brut/3dp_taz/Juniper/TAZ-BOM-Juniper.xlsx

Sheet: KT-PR0017
№ | Category | AO Part # | Description | Manufacturer | Manufacturer PN | Distributor | Distributor SKU | КОЛ-ВО | UOM | Price Per Unit | Price Total | Qty to Order | PO | Date | ETA
1 | Hardware | HD-MS0054 | Square Bumper |  |  | Advanced Antivibration components | V10R87-B08130 | 8 | ea | $0.087 | $0.70 | 12000 | PO04955 | 2014-10-16 | 2014-11-03
2 | Firmware |  | Firmware, Marlin 2014Q4 |  |  | Aleph Objects |  | 1 | ea |  |  | 1520
3 | Printed | PP-GP0083 | bed_finger |  |  |  |  | 4 | ea | $0.100 | $0.40 | 6080
4 | Printed | PP-GP0084 | double_bearing_holder |  |  |  |  | 3 | ea | $2.890 | $8.67 | 4560
5 | Printed | PP-GP0117 | Bearing Holder v1.1b, TAZ |  |  |  |  | 5 | ea | $1.170 | $5.85 | 7600
6 | Printed | PP-GP0086 | Belt clamp, TAZ |  |  |  |  | 2 | ea | $0.080 | $0.16 | 3040
7 | Printed | PP-GP0089 | LCD_spacer |  |  |  |  | 4 | ea | $0.005 | $0.02 | 6080
8 | Printed | PP-GP0120 | feed_tube_holder_v2.0 |  |  |  |  | 1 | ea | $0.660 | $0.66 | 1520
9 | Printed | PP-GP0074 | feed_tube spinner |  |  |  |  | 1 | ea | $0.530 | $0.53 | 1520
10 | Printed | PP-GP0061 | herringbone_large_gear |  |  |  |  | 1 | ea | $2.430 | $2.43 | 1520
11 | Printed | PP-GP0062 | herringbone_small_gear |  |  |  |  | 1 | ea | $0.340 | $0.34 | 1520
12 | Printed | PP-GP0060 | Wade Reloaded Bearing Washer |  |  |  |  | 1 | ea | $0.020 | $0.02 | 1520
13 | Printed | PP-GP0186 | Wade extruder body for Hex nozzle v1.0 |  |  |  |  | 1 | ea | $4.010 | $4.01 | 1520
14 | Printed | PP-GP0059 | Wade Reloaded Idler Block v1.4, Taz & Mini |  |  |  |  | 1 | ea | $0.900 | $0.90 | 1520
15 | Printed | PP-GP0091 | extruder_latch |  |  |  |  | 1 | ea | $0.260 | $0.26 | 1520
16 | Printed | PP-GP0151 | X Idler v2.3 , TAZ |  |  |  |  | 1 | ea | $2.770 | $2.77 | 1520
17 | Printed | PP-GP0128 | X Carriage v2.0 ,TAZ |  |  |  |  | 1 | ea | $6.000 | $6.00 | 1520
18 | Printed | PP-GP0094 | x_carriage_guide |  |  |  |  | 1 | ea | $0.760 | $0.76 | 1520
19 | Printed | PP-GP0152 | X Motor Mount v2.1, TAZ |  |  |  |  | 1 | ea | $2.820 | $2.82 | 1520
20 | Printed | PP-GP0194 | Extruder Mount for Hex v1.0, TAZ |  |  |  |  | 1 | ea | $6.510 | $6.51 | 1520
21 | Printed | PP-GP0150 | y_belt_mount |  |  |  |  | 1 | ea | $2.460 | $2.46 | 1520
22 | Printed | PP-GP0121 | Y Mount Chassis v2.1, TAZ |  |  |  |  | 4 | ea | $0.730 | $2.92 | 6080
23 | Printed | PP-GP0122 | y_mount_table-2.1 |  |  |  |  | 4 | ea | $0.730 | $2.92 | 6080
24 | Printed | PP-GP0123 | Z Top Drive v1.2-Left, TAZ |  |  |  |  | 1 | ea | $3.560 | $3.56 | 1520
25 | Printed | PP-GP0124 | Z Top Drive v1.2-Right, TAZ |  |  |  |  | 1 | ea | $3.560 | $3.56 | 1520
26 | Printed | PP-GP0125 | Z Motor Mount v2.1 nonswitch-Right |  |  |  |  | 1 | ea | $5.840 | $5.84 | 1520
27 | Printed | PP-GP0126 | Z Motor Mount v2.1 switch-Left , TAZ |  |  |  |  | 1 | ea | $6.070 | $6.07 | 1520
28 | Printed | PP-GP0109 | Spool Arm, TAZ |  |  |  |  | 1 | ea | $2.010 | $2.01 | 1520
29 | Printed | PP-GP0118 | Bed Corner v2.5 |  |  |  |  | 4 | ea | $0.250 | $1.00 | 6080
30 | Printed | PP-GP0107 | shipping_clamp_a |  |  |  |  | 4 | ea | $0.250 | $1.00 | 6080
31 | Printed | PP-GP0108 | shipping_clamp_b |  |  |  |  | 4 | ea | $0.210 | $0.84 | 6080
32 | Printed | PP-GP0113 | Y Corner Left v1.2, TAZ |  |  |  |  | 2 | ea | $2.010 | $4.02 | 3040
33 | Printed | PP-GP0114 | Y Corner Right v1.2, TAZ |  |  |  |  | 2 | ea | $2.010 | $4.02 | 3040
34 | Printed | PP-GP0115 | Y Bearing Mount v2.6.b, TAZ |  |  |  |  | 1 | ea | $0.970 | $0.97 | 1520
35 | Printed | PP-GP0116 | Y Motor Mount v2.4, TAZ |  |  |  |  | 1 | ea | $5.170 | $5.17 | 1520
36 | Printed | PP-GP0127 | Z Nut Mount V 2.0 , TAZ |  |  |  |  | 2 | ea | $2.050 | $4.10 | 3040
37 | Printed | PP-GP0154 | Electronics Case Mount v1.0 |  |  |  |  | 4 | ea | $0.240 | $0.96 | 6080
38 | Printed | PP-GP0153 | Extruder Fan Mount v1.0, TAZ |  |  |  |  | 1 | ea | $1.120 | $1.12 | 1520
39 | Printed | PP-GP0163 | Long Shim |  |  |  |  | 2 | ea | $1.000 | $2.00 | 3040
40 | Accessories | RM-AB0079 | ABS 3mm, 1m filament sample, LulzBot green |  |  | Aleph Objects |  | 1 | ea | $0.200 | $0.20 | 1520
41 | Electronic | EL-MS0126 | CONN PLUG, 25 POS, IDC GOLD | 3M | 8225-8000 | Heilind / AA ADAM ELECTRONIC TECHNOLOGY CO., LTD (AMICU ELECTRONICS) | 3M15408-ND | 1 | ea | $3.400 | $3.40 | 1520 | PO05324 / PO06544 | 2015-03-03 | 2015-03-06 | Units that came out of AA Adam will not serve our needs. This need to be 3M parts. Pulled from Heilind
42 | Electronic | EL-MS0127 | CONN D-SUB RCPT 25 POS IDC GOLD | 3M | 8325-8003 | Heilind / AA ADAM ELECTRONIC TECHNOLOGY CO., LTD (AMICU ELECTRONICS) | 3M15414-ND | 1 | ea | $3.990 | $3.99 | 1520 | PO05324 / PO06544 | 3/3/15/ | 2015-03-06 | Units that came out of AA Adam will not serve our needs. This need to be 3M parts. Pulled from Heilind
43 | Mechanical | HD-MS0002-3 | Borosilicate Glass Bed 300mm x 300mm |  |  | Allen Scientific |  | 1 | ea | $12.850 | $12.85 | 1520 | PO05325 | 2014-11-19 | 2014-12-29
44 | Hardware | HD-MS0027 | Spring, Extruder, 6mm OD, 0.8mm WD, 9.7mm FL |  |  | Associated Spring | C0240-032-0380-M | 6 | ea | $0.137 | $0.82 | 9120 | PO04996 | 2014-10-21 | 2014-11-03
45 | Mechanical | HD-BL0009 | GT2, Single sided Neoprene Belt, 2mm pitch, 582 teeth, 6mm wide,fiberglass cords |  |  | B & B Manufacturing, Inc | 1164-2P-06 (2MR-1164-06) | 2 | ea | $2.540 | $5.08 | 3040 | PO05281 | 2014-11-20 | 2015-01-09
46 | Mechanical | HD-MS0033 | GT2 Timing Pulley, 5mm Bore Aluminum |  |  | B & B Manufacturing, Inc | 16-2P06M6CA5 5MM BORE ALUMINUM | 2 | ea | $2.900 | $5.80 | 3040 | PO05281 | 2014-11-20 | 2015-01-16
47 | Tools | TL-HD0048 | Elmer's X-Acto No. 1 Precision Knife – Aluminum |  | X3201 | Utrecht Art Supplies | 57497-1001 | 1 | ea | $1.940 | $1.94 | 1520 | PO05559 | 2014-12-12 | 2015-01-06 | 198 units shipping 12/31/2014 – Balance to ship1/8/2015. TS
48 | Tools | TL-HD0050 | 6" Professional Long Nose Pliers |  |  | Newark | 43W8049 | 1 | ea | $5.180 | $5.18 | 1520 | PO05016 | 2014-10-24 | 2014-10-24 | Vendor double shipped the Ironwood order
49 | Mechanical | PP-FP0012 | frame_connector |  |  | Custom Laser Design |  | 7 | ea | $2.450 | $17.15 | 10640 | PO05561 | 2014-12-12 | 2015-01-06 | First units will start to arrive the week of 12/29/2014 and a minimum of 250 units will be delivered weekly until complete. TSimpson
50 | Mechanical | PP-FP0011 | TAZ name plate, laser cut |  |  | Custom Laser Design |  | 1 | ea | $3.700 | $3.70 | 1520 | PO05561 | 2014-12-12 | 2015-01-06 | First units will start to arrive the week of 12/29/2014 and a minimum of 250 units will be delivered weekly until complete. TSimpson
51 | Hardware | HD-MS0061 | KNOB CLR/MATTE .50"DIA 6MM SHAFT |  | OEJA-50-3-7 | Digikey | 226-3128-ND | 1 | ea | $3.170 | $3.17 | 1520 | PO05779 | 2014-12-30 | See Notes | 1339 units shipping 12/30/2014 remaining 181 shipping 2/2/2015
52 | Electronic | EL-MS0141 | Term Ring Non Ins 26-22AWG #4 (THIS COMES IN BULK) | Panduit | P22-4R-M | TTI | 298-10067-ND | 3 | ea | $0.059 | $0.10 | 4560 | PO05784 | 2014-12-31 | 2015-01-09 | Per Chris, this is a bulk product.
53 | Electronic | PC-CN0010 | IDC 10POS Dual 30AU | FCI | BRG71600-010LF | Digikey / TTI | 609-1739-ND | 2 | ea | $0.501 | $1.00 | 3040 | PO05790 | 2014-12-31 | 2015-01-09
54 | Electronic | EL-MS0134 | Backshell DB25 Flat Ribbon | Norcomp, Inc. | 976-025-010R031 | Digikey/Mouser | 976-25RPE-ND | 1 | ea | $0.998 | $1.00 | 1520 | PO05113 | 2014-11-05 | See Notes | 10 Week Lead Time – 11/05Shipping 31 immediately BO Schedule 550 by 12/21, 200 by 1/30, 739 by 2/4. (Becasue these are difficult to get, I had Heilind pull in addition units to reduce lead times. -
55 | Electronic | EL-MS0133 | 14-POS, panel mount w. brass inserts | TE | 211103-1 | TTI | A106308-ND | 4 | ea | $3.771 | $15.08 | 6080 | PO05694 | 2014-12-29 | 2015-01-09 | 2301 units shipping 12/31/2014 the balance will ship ~ 1/23/2015.
56 | Electronic | EL-MS0128 | 4-POS, free hanging | TE | 206429-1 | TTI | A1357-ND | 1 | ea | $2.552 | $2.55 | 1520 | PO05694 | 2014-12-29 | 2015-01-09
57 | Electronic | EL-MS0131 | 14-POS, free hanging | TE | 206044-1 | Digikey | A1358-ND | 3 | ea | $2.403 | $7.21 | 4560 | PO05239 | 2014-11-14 | 2014-11-20
58 | Electronic | PC-CN0035 | 4-POS, panel mount w. brass inserts | TE | 211102-01 | TTI | A25053-ND | 1 | ea | $3.360 | $3.36 | 1520 | PO05784 | 2014-12-31 | 2015-01-09
59 | Electronic | EL-MS0142 | CONN RECEPT FASTON 22-26AWG .110 |  | 7-520365-2 | TTI | 7-520365-2 | 6 | ea | $0.109 | $0.65 | 9120 | PO05694 | 2014-12-29 | 2015-01-09
60 | Electronic | EL-MS0143 | Conn Fast Receptacle14-16 AWG .250 |  | 3-350820-2 | TTI | 3-350820-2 | 2 | ea | $0.077 | $0.15 | 3040 | PO05694 | 2014-12-29 | 2015-01-09
61 | Electronic | EL-MS0123 | 20-24 AWG Tin Pin for Plug | TE | 1-66106-5 | Digikey | A31991TR-ND | 37 | ea | $0.200 | $7.40 | 56240 | PO04398 | 2014-09-19 | 2014-09-24 | 60000 (Notes from Ironwood) | Do not need more for Juniper | 17+ WK LT (12/19/2014 placed order for 60K units for Kauri) | There was a 12 week lead on PN-A31991TR-ND / Ordered 4k of alternate PN-A032008-TR-ND Under PO 04547. B/O of PO03450 from June for 20,000 ETA 10/13.
62 | Electronic | EL-MS0124 | 20-24 AWG Tin Sockets for Receptacle | TE | 1-66331-4 | Digikey / Heilind | A31995TR-ND | 48 | ea | $0.230 | $11.04 | 72960 | PO05113 | 2014-11-05 | See Notes | 18 Week Lead Time / 12k Shipping 11/05 -BO Schedule 36k by 1/7, 12k by 2/11, 12k by 3/11. | Qty was 46, qty of line above was 35 | 17+ WK LT (12/19/2014 placed order for 73K units for Kauri)
63 | Electronic | EL-MS0121 | 14-18 AWG Tin Sockets for Receptacle | TE | 1-66358-6 | TTI | A31997TR-ND | 3 | ea | $0.210 | $0.63 | 4560 | PO05784 | 2014-12-31 | 2015-01-09
64 | Electronic | EL-MS0122 | 14-18 AWG Tin Pin for Plug | TE | 1-66359-4 | Digikey | A31998TR-ND | 3 | ea | $0.174 | $0.52 | 4560 | PO05239 | 2014-11-14 | 2014-11-20 | Needed to order a small amount for RMA's and it only comes on reels of 4k to I ordered Juniper as well.
65 | Electronic | EL-MS0129 | Cable Clamp for 14-Pos; 0.453” opening | TE | 206070-8 | TTI | A32516-ND | 2 | ea | $2.160 | $4.32 | 3040 | PO05784 | 2014-12-31 | 2015-01-09
66 | Electronic | EL-MS0130 | Cable Clamp for 14-Pos; 0.453” opening; full cover | TE | AMP1546349-2 | Heilind | A33754-ND | 1 | ea | $3.390 | $3.39 | 1520 | PO05784 / PO06453 | 2014-12-31 | 2015-01-09 | Ordered Fill in from Digi Key (PO06455) and Heilind
67 | Electronic | EL-WR0104 | 24AWG Stranded – Orange |  | HU1569247OE | Allcable | HU1569247OE | 2520 | mm | $7.545931759e-05 | $0.19 | 12566.92913 | PO05812 | 2014-12-12 | 2015-01-09
68 | Electronic | EL-WR0105 | 24AWG Stranded – Black |  | HU1569247BK | Allcable | HU1569247BK | 4860 | mm | $0.0001 | $0.37 | 24236.22047 | PO05812 | 2014-12-12 | 2015-01-09 | qty was 3560 (PO05812 covers Juniper, fill in for Daffodil and Euphorbia)
69 | Electronic | EL-WR0111 | 24AWG Stranded – Blue |  | HU1569247BE | Allcable | HU1569247BE | 690 | mm | $0.0001 | $0.05 | 3440.944882 | PO05812 | 2014-12-12 | 2015-01-09
70 | Electronic | EL-WR0103 | 24AWG Stranded – Red |  | HU1569247RD | Allcable | HU1569247RD | 6100 | mm | $0.0001 | $0.46 | 30419.94751 | PO05812 | 2014-12-12 | 2015-01-09 | qty was 4800 (PO05812 covers Juniper, fill in for Daffodil and Euphorbia)
71 | Electronic | EL-WR0107 | 24AWG Stranded – White |  | HU1569247WE | Allcable | HU1569247WE | 1160 | mm | $0.0001 | $0.09 | 5784.776903 | PO05812 | 2014-12-12 | 2015-01-09
72 | Electronic | EL-WR0109 | 24AWG Stranded – Yellow |  | HU1569247YW | Allcable | HU1569247YW | 1100 | mm | $0.0001 | $0.08 | 5485.564304 | PO05812 | 2014-12-12 | 2015-01-09
73 | Electronic | EL-WR0106 | 16AWG Stranded – Red |  | HU15691626RD | Allcable | HU15691626RD | 650 | mm | $0.0003 | $0.19 | 3241.469816 | PO05812 | 2014-12-12 | 2015-01-09
74 | Electronic | EL-WR0108 | 16AWG Stranded – Violet |  | HU15691626VT | Allcable | HU15691626VT | 1200 | mm | $0.0003 | $0.35 | 5984.251969 | PO05812 | 2014-12-12 | 2015-01-09
75 | Electronic | EL-WR0110 | 16AWG Stranded – Yellow |  | HU15691626YW | Allcable | HU15691626YW | 50 | mm | $0.0003 | $0.01 | 249.343832 | PO05812 | 2014-12-12 | 2015-01-09
76 | Electronic | EL-SW0020 | SWITCH ROCKER DPST 20A 125V | E-switch | R5ABLKBLKFF0 | Digikey | EG1529-ND | 1 | ea | $1.046 | $1.05 | 1520 | PO05779 | 2014-12-30 | 2015-01-06
77 | Electronic | EL-WR0098 | 25Cond Ribbon LT GRY |  | HF365/25SF | Digikey | MD25R-100-ND | 160 | mm | $0.316 | $50.56 | 243200 | PO05776 | 2014-12-30 | 2015-01-06 | 800 ft
78 | Electronic | EL-SW0021 | Switch SIM Roll SPDT 3A 125V | Omron | SG-3GL13PT | Digikey | SW768-ND | 3 | ea | $0.609 | $1.83 | 4560 | See notes |  |  | 5500 from PO04969 on hand
79 | Electronic | EL-WR0099 | Shielded 4Cond 22AWG |  | 0762A.41.10 | Allcable | C0762A.41.10 | 3657 | mm | $0.001 | $3.70 | 18237.00787 | PO05812 | 2014-12-12 | 2015-01-09
80 | Electronic | EL-MS0059 | CONN TERM FEMALE 22-24AWG TIN | Molex Inc. | 16-02-0086 | TTI | WM2510TR-ND | 96 | ea | $0.019 | $1.82 | 145920 (8 Reels) | PO05694 | 2014-12-29 | 2015-01-09 | Reel = 20,000 units
81 | Electronic | EL-MS0205 | CONN TERM MALE 22-24AWG TIN | Molex | 16-02-0107 | TTI | WM2517TR-ND | 36 | ea | $0.042 | $1.51 | 54720 (3 Reels of 20K) | PO05694 | 2014-12-29 | 2015-01-09 | Qty was 32, qty of line above was 92 Reel = 20,000 units
82 | Electronic | EL-MS0212 | CONN PIN 24-30AWG CRIMP TIN | Molex | 16-02-0108 | TTI | MOL16-02-0108 | 2 | ea | $0.081 | $0.16 | 3040 | PO05784 | 2014-12-31 | 2015-01-09 | This comes in BULK
83 | Electronic | EL-MS0075 | 8-POS .100 Dual (Black) |  | 22552081 | TTI | WM2521-ND | 1 | ea | $0.081 | $0.08 | 1520 | PO05694 | 2014-12-29 | 2015-01-09
84 | Electronic | EL-MS0074 | 20-POS .100 Dual (Black) |  | 22552201 | Digikey | WM2527-ND | 1 | ea | $0.988 | $1.059 | 1520 | PO05779 | 2014-12-30 | 2015-01-06 | Backorder will ship 215 units on 1//21/15.
85 | Electronic | PP-MP0059 | CONN HOUSING MALE 2POS .100 |  | 0701070001 | TTI | WM2533-ND | 5 | ea | $0.124 | $0.62 | 7600 | PO05694 | 2014-12-29 | 2015-01-09 | qty was 4 PO05694 Ordered 8,000 units)
86 | Electronic | EL-MS0061 | Connector, 4 pin Male housing with latch | Molex | 0701070003 | TTI | WM2535-ND | 6 | ea | $0.136 | $0.82 | 9120 | PO05694 | 2014-12-29 | 2015-01-09 | qty was 5
87 | Electronic | PC-CN0001 | CONN HOUSING 2POS .100 W/LATCH |  | 050579402 | TTI | WM2900-ND | 12 | ea | $0.062 | $0.74 | 18240 | PO05694 | 2014-12-29 | 2015-01-09 | qty was 10
88 | Electronic | PC-CN0003 | Connector Housing 3POS .100 W/Latch |  | 0050579403 | TTI | WM2901-ND | 3 | ea | $0.060 | $0.18 | 4560 | PO05694 | 2014-12-29 | 2015-01-09
89 | Electronic | EL-MS0062 | Connector, 4 pin Female housing with latch | Molex | 50579404 | Helind | WM2902-ND | 12 | ea | $0.062 | $0.74 | 18240 | PO05062 | 2014-12-31 | 2015-01-09
90 | Electronic | PC-CN0032 | Term Block Plug 2POS STR 5.08MM |  | 0395300002 | TTI | WM7819-ND | 5 | ea | $0.456 | $2.28 | 7600 | PO05694 | 2014-12-29 | 2015-01-09
91 | Electronic | PC-CN0036 | Term Block Plug 6POS STR 5.08MM |  | 0395300006 | TTI/ Digi-Key /Vercial | WM7822-ND | 1 | ea | $1.820 | $1.82 | 1520 | PO05780 | 2014-12-30 | 2015-01-06 | TTI Out of stock, Digi-key only has 1112 – Vertical had enough in stock and was cheaper than Digi-Key.
92 | Electronic | EL-MS0140 | Cable Clamp for 4-Pos; 0.329” opening | TE | 1-206062-5 | TTI | A104910-ND | 1 | ea | $1.420 | $1.42 | 1520 | PO05784 | 2014-12-31 | 2015-01-09
93 | Electronic | EL-MS0242 | TAPE COPPER FOIL 12.7MMX5.5 |  |  | Digikey | 3M9903-ND | 0.0127 | ea | $19.403 | $0.25 | 20 rolls | PO06249 | 2015-02-02 |  | 5 received, 15 unknown backorder
94 | Mechanical | PP-FP0029 | Cover, Electronics, TAZ |  |  | EPOCS |  | 1 | ea | $5.750 |  | 200 | PO05088 | 2014-11-05 | 2014-12-10
95 | Mechanical | PP-FP0030 | Enclosure, Sheet Metal, TAZ |  |  | EPOCS |  | 1 | ea | $23.750 |  | 200 | PO05088 | 2014-11-05 | 2014-12-10
96 | Mechanical | PP-FP0009 | LCD cover back, black anodized, TAZ |  |  | EPOCS |  | 1 | ea | $14.500 |  | 200 | PO05088 | 2014-11-05 | 2014-12-10
97 | Mechanical | PP-FP0008 | LCD cover front, black anodized, TAZ |  |  | EPOCS |  | 1 | ea | $3.750 |  | 200 | PO05088 | 2014-11-05 | 2014-12-10
98 | Mechanical | PP-MP0045 | Bed Mount Plate, Aluminum, TAZ |  |  | EPOCS |  | 1 | ea | $16.500 |  | 200 | PO05088 | 2014-11-05 | 2014-12-10
99 | Mechanical | PP-FP0015 | Y Axis End Idler, TAZ |  |  | EPOCS |  | 1 | ea | $6.750 |  | 200 | PO05088 | 2014-11-05 | 2014-12-10
100 | Mechanical | PP-FP0016 | Y Axis End Motor, TAZ |  |  | EPOCS |  | 1 | ea | $6.750 |  | 200 | PO05088 | 2014-11-05 | 2014-12-10
101 | Mechanical | PP-FP0031 | X end Plate, TAZ |  |  | EPOCS |  | 2 | ea | $12.000 |  | 400 | PO05088 | 2014-11-05 | 2014-12-10
102 | Mechanical | PP-FP0029 | Cover, Electronics, TAZ |  |  | Rapid Sheet Metal |  | 1 | ea | $5.500 | $5.500 | 1400 | PO04936 | 2014-10-14 | See Notes | 100 Piece set of parts to start landing 10/23 – 2nd set of 100 parts by 10/30/2014 Then the 1,200 unit balance of this PO will start shipping 12/16/2014 with all units to be in house on or before 1/22/2015 – the first deliveries of 100 units x 2 was to fill in for Ironwood/Epocs delay – the rest are for Juniper. These are all Juniper parts now.
103 | Mechanical | PP-FP0030 | Enclosure, Sheet Metal, TAZ |  |  | Rapid Sheet Metal |  | 1 | ea | $20.750 | $20.750 | 1400 | PO04936 | 2014-10-14 | See Notes Above
104 | Mechanical | PP-FP0009 | LCD cover back, black anodized, TAZ |  |  | Rapid Sheet Metal |  | 1 | ea | $13.750 | $13.750 | 1400 | PO04936 | 2014-10-14 | See Notes Above
105 | Mechanical | PP-FP0008 | LCD cover front, black anodized, TAZ |  |  | Rapid Sheet Metal |  | 1 | ea | $3.250 | $3.250 | 1400 | PO04936 | 2014-10-14 | See Notes Above
106 | Mechanical | PP-MP0045 | Bed Mount Plate, Aluminum, TAZ |  |  | Rapid Sheet Metal |  | 1 | ea | $16.500 | $16.500 | 1400 | PO04936 | 2014-10-14 | See Notes Above
107 | Mechanical | PP-FP0015 | Y Axis End Idler, TAZ |  |  | Rapid Sheet Metal |  | 1 | ea | $7.350 | $7.350 | 1400 | PO04936 | 2014-10-14 | See Notes Above
108 | Mechanical | PP-FP0016 | Y Axis End Motor, TAZ |  |  | Rapid Sheet Metal |  | 1 | ea | $7.200 | $7.200 | 1400 | PO04936 | 2014-10-14 | See Notes Above
109 | Mechanical | PP-FP0031 | X end Plate, TAZ |  |  | Rapid Sheet Metal |  | 2 | ea | $11.500 | $23.00 | 2800 | PO04936 | 2014-10-14 | See Notes Above
110 | Consumable | TL-CS0003 | ArmsKeeper Glues: Maxi-Cure Extra Thick |  |  | FRP Games | ARM05113 | 1 | g | $0.141 | $0.14 | 1520 | PO05795 | 2015-01-02 | 2015-01-09
111 | Tools | TL-MS0020 | Stainless Steel/Straight Instrument Cleaner Brush |  |  | Gordon Brush | 906501 | 1 | ea | $5.290 | $5.29 | 1520 | PO05562 | 2014-12-12 | 2015-01-06
112 | Tools | TL-HD0047 | Tekton 13-pc. Long Arm Ball Hex Key Wrench Set (Metric) |  |  | Hayden Industrial | 25220 | 1 | ea | $4.850 | $4.85 | 1520 | PO05796 | 2014-12-31 | 2015-01-09
113 | Consumable | TL-CS0099 | Hot Glue |  |  | Quill |  | 1 | g | $0.0001641791045 | $0.0001641791045 | 1520 | PO05838 | 2015-01-06 | 2015-01-09
114 | Consumable | TL-CS0010/TL-CS0114 | Lithium Grease |  |  | Amazon | 934178 | 3 | g | $0.015 | $0.04 | 4560 | PO5809 | 2015-01-05 | 2015-01-09
115 | Mechanical | HD-BU0001 | DryLin® R - Solid polymer bearing RJM-01, 10mm |  |  | IGUS | RJM-01-10 | 11 | ea | $1.320 | $14.52 | 16720 | PO04957 | 2014-10-16 | 2014-12-31
116 | Electronic | EL-FA0011 | FAN,24VDC,Sleeve,5.75CFM,40X40X10MM,60mA 6000RPM,1.44W,280MM LEADS,CE/RoHS |  | TF4010-24H-S | Kysan | 69829 | 1 | ea | $1.450 | $1.45 | 1520 | PO04958 | 2014-10-16 | 2015-01-02
117 | Electronic | EL-FA0012 | FAN,24VDC,BALL,31.60CFM,80×80×15 MM,100mA |  | TF8015-24M-B | Kysan | 69866 | 1 | ea | $2.350 | $2.35 | 1520 | PO04958 | 2014-10-16 | 2015-01-02
118 | Documentation | DC-MN0013 | Lulzbot-Taz 5.0 User Manual |  |  | Lightning Source |  | 1 | ea | $3.530 | $3.53 | 1520 | PO05569
119 | Accessories | DC-LB0007 | Label, Top of Box |  |  | Lightspeed Color |  | 1 | ea | $0.238 | $0.24 | 1520 | PO05563 |  |  | Need Steven's Approval to order
120 | Accessories | DC-LB0024 | Label, Bottom of Box |  |  | Lightspeed Color |  | 1 | ea | $0.238 | $0.24 | 1520 | PO05563 |  |  | Need Steven's Approval to order
121 | Documentation | DC-MS0034 | Test/Acceptance record TAZ 5.0 |  |  | Lightspeed Color |  | 1 | ea | $0.476 | $0.48 | 1520 | PO05563 |  |  | Need Steven's Approval to order
122 | Documentation | DC-MS0035 | Quality checklist, TAZ 5.0 |  |  | Lightspeed Color |  | 1 | ea | $0.762 | $0.76 | 1520 | PO05563 |  |  | Need Steven's Approval to order
123 | Documentation | DC-MS0036 | Packing List, TAZ 5.0 |  |  | Lightspeed Color |  | 1 | ea | $0.238 | $0.24 | 1520 | PO05563 |  |  | Need Steven's Approval to order
124 | Documentation | DC-MN0012 | Getting Started Guide, TAZ 5 |  |  | Lightspeed Color |  | 1 | ea | $1.619 | $1.62 | 1520 | PO05563 |  |  | Need Steven's Approval to order
125 | Documentation | DC-MS0041 | Declaration of Conformity, TAZ v5.0 |  |  | Lightspeed Color |  | 1 | ea | $0.114 | $0.11 | 1520 |  | 2015-02-24 | 2015-03-02
126 | Mechanical | HD-RD0004 | 8mm Smooth Rod x 18-19mm |  |  | MBK | 8mm Smooth Rod x 18-19mm | 1 | ea | $5.100 | $5.10 | 1520 | PO05554 | 2014-12-12 | 2015-01-08
127 | Hardware | HD-BT0108 | Hobbed Bolt, M8 x 50mm Hex head, 26mm offset, Stainless Steel |  |  | Quatro |  | 1 | ea | $5.850 | $5.85 | 1520 | PO05555 | 2014-12-12 | 2015-01-08
128 | Hardware | HD-TB0007 | Feed Tube, PTFE |  | Z49086 | Hayden Industrial | 5239K12 | 850 | mm | $0.004 | $3.76 | 1292000 | PO05811 | 2015-01-05 | 2015-01-14
129 | Tools | TL-HD0253 | 13mm Combination End Wrenches - Crome Finish, 13mm Sz, 15 Deg Angle |  |  | Image Supply Service, Inc. | MI13MML19 | 1 | ea | $2.790 | $2.79 | 1520 | PO05955 | 2015-01-09 | 2015-01-19 | These were TL-HD0014 but because they were hard to get in large volumes, I had to switch to TL-HD0253 with a crome finish. Costing goes from 7.660 to 2.79 each. Purchased for Juniper and Kauri | McMaster-Carr Supply Company – 5488A19 Black Oxide units at 7.660 ea. / Manufacture Metric & Multistandard Complenents PN1027215 3000 units @ 2.00 with 8-10 week lead time.
130 | Tools | TL-HD0008 | Stainless Steel Pocket Rule Semiflexible, Metric Grads, 150 mm Length |  |  | McMaster-Carr Supply Company / Image Supply | 6813A62 | 1 | ea | $2.100 | $2.10 | 1520 | PO06045 | 2015-01-12 | 2015-01-19 | 500 coming in from McMcaster and Image Supply is providing the rest. (Juniper and Kauri) | McMaster-Carr Supply Company | 6813A62
131 | Electronic | EL-MS0073 | Tubing, Corrugated Loom .25" | Panduit | CLT25F-C20 | Fastenal | 708161 | 1345 | mm | $2.916666667e-06 | $0.003922916667 | 3526400 | PO05823 | 2015-01-02 | 2015-01-09
132 | Electronic | EL-MS0139 | Tubing, Corrugated Loom .375" | Panduit | 0708162 | McMaster / Fastenal | 7840K32 | 1280 | mm | $3.225065617e-06 | $0.00412808399 | 463600 | PO05598 | 2014-12-16 | 2014-12-17 | 463600/304.8=1520.99 so we need to order 1550 feet
133 | Electronic | TL-CS0083 | EMI/RFI-Shield Heat-Shrink Tubing 3/16" ID Before, 3/32" ID After, 48" L, Black |  |  | Allcable | 7937K31 | 230 | mm | $0.013 | $3.04 | 286.7454068 | PO05812 | 2014-12-12 | 2015-01-09
134 | Electronic | TL-CS0129 | Interference-Shielding Heat-Shrink Tubing, 3/8" ID Before, 3/16" ID After, 48" Long, Black |  |  | Allcable | 7937K33 | 175 | mm | $0.025 | $4.38 | 218.175853 | PO05812 | 2014-12-12 | 2015-01-09
135 | Hardware | HD-MS0197 | Type 316 Stainless Steel Socket Head Cap Screw, M5 Thread, 12mm Length, .8mm Pitch |  | DMS-08350030 | Timberline | DMS-08350030 | 1 | ea | $0.061 | $0.06 | 1520 | PO05688 | 2015-01-02 | 2015-01-09
136 | Hardware | HD-MS0164 | Aluminum Male-Female Threaded Hex Standoff, 3/16" Hex, 3/16" Length |  |  | McMaster-Carr Supply Company | 93505A853, 4-40 | 2 | ea | $0.660 | $1.32 | 3040 | PO05891 | 2015-01-08 | 2015-01-09
137 | Hardware | HD-WA0027 | Metric 18-8 Stainless Steel Internal-Tooth Lock Washer, M3 Screw Size, 6mm OD, .4mm min Thick |  | WF6330000/ | Mcmaster / Fastenal | 93925A240 | 2 | ea | $0.006 | $0.01 | 3040 | PO05891 | 2015-01-08 | 2015-01-09
138 | Hardware | HD-MS0157 | Plastic Head Thumb Screw, Knurled Head, M5 Thread, 0.8mm Pitch, 20mm Long |  |  | McMaster-Carr Supply Company | 96016A245 | 1 | ea | $0.738 | $0.74 | 1520 | PO05891 | 2015-01-08 | 2015-01-09 | 65 packs shipping 1/15/2015 and the balance will deliver on January 20th.
139 | Hardware | HD-MS0203 | Steel Compression Spring, Zinc-Plated Music Wire, 1.00" Long,.300" OD,.022" Wire |  |  | Associated Spring | CO300-022-1000-M | 1 | ea | $0.271 | $0.27 | 1520 | PO04996 | 2014-10-21 | 2014-01-14 | Get BACKORDER information
140 | Electronic | EL-MS0160 | Noninsulated Wire Ferrule, 14 AWG, .39" Pin Length |  |  | McMaster-Carr Supply Company | 9681K25 | 1 | ea | $0.064 | $0.06 | 1520 | PO05891 | 2015-01-08 | 2015-01-09
141 | Hardware | HD-NT0017 | T-nut M5 Thread |  |  | Misumi | HNKK5-5 | 77 | ea | $0.091 | $7.05 | 117040 | PO05162 | 2014-11-07 | See Notes | Staggered deliveries: 12/29/2014 – 01/19/2015 – 02/09/2015 – 03/02/2015
142 | Mechanical | HD-RD0018 | 10mm x 500mm smooth rod |  |  | Misumi | SSFHR10-500 | 6 | ea | $11.990 | $71.94 | 9120 | PO05162 | 2014-11-07 | See Notes | Staggered deliveries: 12/29/2014 – 01/19/2015 – 02/09/2015 – 03/02/2015
143 | Mechanical | HD-MS0194 | Coupling, Set Screw, Misumi GSASL16-5-5 |  |  | Misumi | GSASL16-5-5 | 2 | ea | $7.500 | $15.00 | 3040 | PO05162 | 2014-11-07 | See Notes | Staggered deliveries: 12/29/2014 – 01/19/2015 – 02/09/2015 – 03/02/2015
144 | Mechanical | HD-EX0010 | Aluminum Frame, extrusion 20mm x 20mm x 500mm, black |  |  | Misumi | HFSB5-2020-500 | 4 | ea | $4.150 | $16.60 | 6080 | PO05162 | 2014-11-07 | See Notes | Staggered deliveries: 12/29/2014 – 01/19/2015 – 02/09/2015 – 03/02/2015
145 | Mechanical | HD-EX0011 | Aluminum Frame LTP, extrusion 20mm x 20mm x 500mm,Tapped M5x0.8 on one End, black |  |  | Misumi | HFSB5-2020-500-LTP | 4 | ea | $5.840 | $23.36 | 6080 | PO05162 | 2014-11-07 | See Notes | Staggered deliveries: 12/29/2014 – 01/19/2015 – 02/09/2015 – 03/02/2015
146 | Mechanical | HD-EX0012 | Aluminum Frame TPW, extrusion 20mm x 20mm x 500mm,Tapped M5x0.8 on both Ends, black |  |  | Misumi | HFSB5-2020-500-TPW | 2 | ea | $7.420 | $14.84 | 3040 | PO05162 | 2014-11-07 | See Notes | Staggered deliveries: 12/29/2014 – 01/19/2015 – 02/09/2015 – 03/02/2015
147 | Mechanical | HD-MS0172 | Screw, Lead, Misumi MTSBRK12-420-F7-R8-T9-Q8-S20-E5-FE0-FW7-FY1 |  |  | Misumi | MTSBRK12-420-F7-R8-T9-Q8-S20-E5-FE0-FW7-FY1 | 2 | ea | $24.180 | $48.36 | 3040 | PO05162 | 2014-11-07 | See Notes | Staggered deliveries: 12/29/2014 – 01/19/2015 – 02/09/2015 – 03/02/2015
148 | Mechanical | HD-MS0173 | Nut, Lead Screw, Resin, Misumi MTSRR12 |  |  | Misumi | MTSRR12 | 2 | ea | $7.400 | $14.80 | 3040 | PO05162 | 2014-11-07 | See Notes | Staggered deliveries: 12/29/2014 – 01/19/2015 – 02/09/2015 – 03/02/2015
149 | Electronic | EL-CA0001 | 6ft USB 2.0 A Male to B Male 28/24AWG Cable |  |  | Monoprice | 5438 | 1 | ea | $1.090 | $1.09 | 1520 | PO04966 | 2014-10-16 | 2014-11-03 | Have Linvox quote these next time.
150 | Electronic | EL-MS0008 | Heavy Duty Power Connectors HOUSING ONLY, BLACK POWERPOLE 15/45 |  |  | Mouser | 879-1327G6-BK | 2 | ea | $0.184 | $0.37 | 3040 | PO05425 | 2014-12-02 | 2014-12-08
151 | Electronic | EL-MS0010 | Heavy Duty Power Connectors POWERPOLE 15A CONT |  |  | Mouser | 879-1332-BK | 2 | ea | $0.121 | $0.24 | 3040 | PO05425 | 2014-12-02 | 2014-12-08
152 | Electronic | EL-CA0016 | Flat Cables .050" 10C Shielded Black 28AWG Stranded |  |  | Mouser | 517-3517/10 | 685 | mm | $0.016 | $11.24 | 1041200 | PO05425 | 2014-12-02 | 2015-01-05 | 685*1520=1041200/304.8= 3,416 / 11 units shipping 12/2/2014 – 4 week lead on remaining 29 Est. ETA 1/5/2015
153 | Electronics | PC-BD0027 | Silicon Heater, 24V ,360W, 298mm x 298mm, Self Adhesive, w/ connectors |  | NPH PC-BD0027 | National Plastic Heater | NPH PC-BD0027 | 1 | ea | $37.900 | $37.90 | 1520 | PO04210 | 2014-08-19 | 2014-11-07
154 | Electronic | TL-HD0178 | MOLEX 19069-0117 TERMINAL, RING TONGUE, #10, CRIMP |  | 55H3650 | TTI | 55H3650 | 1 | ea | $0.051 | $0.05 | 1520 | PO05694 | 2014-12-29 | 2015-01-09
155 | Electronic | EL-WR0013 | HOOK-UP WIRE 100FT 18AWG TIN-COPPER BLK |  | HU15691816BK | Allcable | HU15691816BK | 240 | mm | $0.002 | $0.44 | 1196.850394 | PO05812 | 2014-12-12 | 2015-01-09
156 | Hardware | EL-MS0144 | Connector Accessories, Sealing Cap, Shell Size 17 |  |  | Onlinecomponents.com | 207445-3 | 1 | ea | $1.980 | $1.98 | 1520 | PO05568 | 2014-12-15 | 2014-12-31 | 1230 Ships Today 12/15/2014 - 290 Backorder (8 Wks ~2/9/2015)
157 | Mechanical | HD-MS0262 | Ultem PEI, 0.010" x 12.50" x 90ft rolls |  |  | Professional Plastics |  | 0.01162790698 | ea | $1199.640 | $13.95 | 19 | PO05792 | 2014-12-31 | 2015-01-15 | Rolls need to be cut to 12.5 inches
158 | Mechanical | HD-MS0263 | 3M 468MP Adhesive Transfer Tape – 14.4” x 60 yards |  |  | Professional Plastics |  | 0.005813953488 | ea | $402.390 | $2.34 | 11 | PO05792 | 2014-12-31 | 2015-01-15 | Rolls need to be cut to 14.4 inches
159 | Electronic | EL-PS0022 | Power Supply, 24V, 16.66A, 400W, 4pin, Pengchu Ltd. V2 |  |  | Pengchu Ltd. |  | 1 | ea | $48.000 | $48.00 | 1520 | PO05278 | 2014-11-26 | See Notes | We will be doing a partial shipment to start production, there are 14 PSU per carton, connsidering a half pallet which would be 21 cartons - 294 PSUs – the rest to come by sea.
160 | Electronic | KT-EL0026 | Wired Power plug from Power Supply, 24V, 16.66A, 400W, 4pin, Pengchu Ltd. |  |  | Pengchu Ltd. |  | 1 | ea | $0.000 | #VALUE! | 1520 |  |  |  | Comes with EP-PS0022
161 | Electronic | EL-FA0020 | RFB2008 Micro Blower, 30 AWG wire 250mm long |  |  | Pelonis |  | 1 | ea | $6.68 | $6.68 | 1520 | PO05564 | 2014-12-15 | 2015-01-16 | Make sure this is ordered with 30awg wire that is 250mm long (DONE) 1600 pc shipping 1/12/ and Bal to follow another 4 weeks – All should be in by 2/13. TS
162 | Tools | TL-HD0046 | Pro Dental Pick, 5 3/4 in |  | J1031S | Precision Products | (DP-19) M S V | 1 | ea | 1.05 | 1.05 | 1520 | PO06004 | 2015-01-12 | 2015-01-16
163 | Mechanical | HE-SH0033 | Reprap Modified Hexagon Hotend, Lulzbot Edition, 3.0mm Filament, 0.35mm nozzle |  |  | reprapdiscount |  | 1 | ea | $23.000 | $23.00 | 1520 | PO05566 | 2014-12-12 | 2015-01-08
164 | Electronic | PC-AS0019 | Full Graphic Smart LCD Controller |  |  | reprapdiscount |  | 1 | ea | $28.000 | $28.00 | 1520 | PO05566 | 2014-12-12 | 2015-01-08
165 | Accessories | EL-MS0119 | SD card from GLCD kit |  |  | reprapdiscount |  | 1 | ea |  |  | 1520 | PO05566 | 2014-12-12 | 2015-01-08
166 | Accessories | SH-PG0031 | Anti-Static Control Products 2X3 STATIC SHLD BAG W/ZIP TOP |  |  | Uline | S-6509 | 1 | ea | $0.130 | $0.13 | 1520 | PO06054 | 2015-01-14 | 2015-01-16 | Added this line item to the BOM per Seth 1/14/2015. Placing Uline order now. TS
167 | Tools | TL-HD0049 | 6'' Deluxe Bent Stainless Steel Tweezer with Serrated Teeth |  |  | Roeder Industries | TWE6 | 1 | ea | $2.250 | $2.25 | 1520 | PO05537 | 2014-12-10 | 2014-12-31
168 | Accessories | SH-BX0032 | 30x24x13 CUSTOM BOX |  |  | Shippers Supply |  | 1 | ea | $4.090 | $4.09 | 1520 | PO05542 | 2014-12-12 | 2014-01-09
169 | Accessories | SH-BX0025 | 10x8x2-1/2 32 Ect B Brown Roll End Tuck Mailer, Custom Box |  |  | Shippers Supply |  | 1 | ea | $0.650 | $0.65 | 1520 | PO05542 | 2014-12-12 | 2014-01-09
170 | Accessories | SH-PA0030 | Fabricated Foam Insert: 2 End Caps, Tray w/Plastic Corrugated & Plain Pad, v4 |  |  | Shippers Supply |  | 1 | ea | $37.95 | $37.95 | 1520 | PO05542 | 2014-12-12 | 2014-01-09
171 | Accessories | SH-PG0056 | Kraft packing tape, tan, 3x450', gummed |  |  | Shippers Supply |  | 4267 | mm | $4.738990959e-05 | $0.20 | 6485840 | PO05542 | 2014-12-12 | 2014-01-09
172 | Accessories | SH-PA0025 | CUSTOM PAD 4-1/2X9-38 |  |  | Shippers Supply |  | 1 | ea | $0.140 | $0.14 | 1520 | PO05542 | 2014-12-12 | 2014-01-09
173 | Electronic | EL-MT0001 | NEMA 17 Stepper Motors, wires cut to 60mm |  |  | Changzhou FTX Motors Co., Ltd. | SY42STH47-1504A | 5 | ea | $7.500 | $37.50 | 7600 | PO04851 | 2014-10-23 | 2015-01-05 | Needs confirmation
174 | Tools | TL-MS0001 | Tool Kit Bag w/ LulzBot logo |  |  | Specialty incentives Inc. |  | 1 | ea | $12.500 | $12.50 | 1520 | PO05565 | 2014-12-15 | 2015-01-05
175 | Hardware | HD-MS0062 | Metric Aluminum Unthreaded Spacer, 8MM OD, 8MM Length, M5 Screw Size |  |  | Fastenal | 11485208 | 1 | ea | $0.169 | $0.17 | 1520 | PO05823 | 2015-01-02 | 2015-01-09
176 | Hardware | HD-BT0053 | 18-8 SS Flat Head Phillips Machine Screw Black-Oxide Finish, 4-40 Thread, 1/4" Length |  | NS3420-2208/BO | Timberline | NS3420-2208/BO | 20 | ea | $0.027 | $0.53 | 30400 | PO05688 | 2015-01-02 | 2015-01-09
177 | Hardware | HD-BT0054 | Metric Class 12.9 Socket Head Cap Screw Alloy STL, M2.5 Thread, 12mm Length, 0.45mm Pitch |  | 0134612 | Fastenal | 0134612 | 4 | ea | $0.023 | $0.09 | 6080 | PO05823 | 2015-01-02 | 2015-01-09
178 | Hardware | HD-WA0013 | DIN 125 Zinc-Plated Class 4 Steel Flat Washer M2.5 Screw Size, 6mm OD, .45mm-.55mm Thick |  | MNTR-M312.521 | Timberline | MNTR-M312.521 | 4 | ea | $0.003 | $0.01 | 6080 | PO05688 | 2015-01-02 | 2015-01-09
179 | Hardware | PP-MP0066 | Metric Brass Heat-Set Insert for Plastics, Tapered, M2-.4 Internal Thread, 2.9MM Length |  |  | Mcmaster / Hayden | 94180A307 | 5 | ea | $0.103 | $0.51 | 7600 | PO05891 | 2015-01-09 | 2015-01-12 | This qty was 4 (Mark is pulling 85K of these in for TAZ and MINI for 2015 VMI)
180 | Hardware | HD-BT0107 | Metric Class 12.9 Socket Head Cap Screw Alloy Steel, Black, M2 Thread, 10mm Length, 0.4mm Pitch |  | 0134599 | Fastenal | 0134599 | 6 | ea | $0.022 | $0.13 | 9120 | PO05823 | 2015-01-02 | 2015-01-09
181 | Hardware | HD-WA0012 | Steel Flat Washer, DIN 125 zinc-plated class 4,M2 screw sz, 5mm OD, .25mm-.35mm thick |  | 40350 | Fastenal | 40350 | 6 | ea | $0.002 | $0.01 | 9120 | See notes |  |  | 18K in stock as of 1/12/2015
182 | Hardware | HD-MS0230 | M2 x 6 SHCS, Black-Oxide |  | 8050-0206 | Timberline | 8050-0206 | 1 | ea | $0.04 | $0.04 | 1520 | PO05688 | 2015-01-02 | 2015-01-09
183 | Hardware | HD-MS0030 | M3-.5 3.8mm Heatset Insert |  | 11125995 | Hayden Industrial | 11125995 | 69 | ea | $0.040 | $2.76 | 104880 | PO04956 | 2014-10-16 | 2014-12-19
184 | Hardware | HD-MS0060 | M5-.8 11mm Heatset Insert |  | 11126012 | Hayden Industrial | DV-M50-TH | 15 | ea | $0.110 | $1.65 | 22800 | PO05541 | 2014-12-11 | 2014-12-19
185 | Hardware | HD-MS0158 | M5-.8 6.7mm Heatset Insert |  | 11125997 | Hayden Industrial | 11125997 | 6 | ea | $0.149 | $0.90 | 9120 | PO04956 | 2014-10-16 | 2014-12-19
186 | Hardware | HD-NT0004 | M3 Nut, Zinc Plated |  | 8100-0030 | Timberline | 8100-0030 | 16 | ea | $0.009 | $0.15 | 24320 | PO05688 | 2015-01-02 | 2015-01-09
187 | Hardware | HD-BT0012 | M3 Set Screw (Grub Screw) |  | NS0310-0306/met | Timberline | NS0310-0306/met | 11 | ea | $0.019 | $0.21 | 16720 | PO05688 | 2105-01-02 | 2015-01-09
188 | Hardware | HD-WA0001 | M3 Washer, Steel, Zinc Plated |  | MTR-M3100321 | Timberline | MTR-M3100321 | 106 | ea | $0.002 | $0.18 | 161120 | PO05688 | 2015-01-02 | 2015-01-09
189 | Hardware | HD-BT0044 | M3 x 5 Bolt, SHCS Black-Oxide |  | 39501 | Fastenal | 39501 | 4 | ea | $0.022 | $0.09 | 6080 | PO05823 | 2015-01-02 | 2015-01-09
190 | Hardware | HD-BT0104 | M3 x 8 Bolt, BHCS, SST |  |  | mcmaster | 92095A181 | 1 | ea | $0.094 | $0.09 | 1100 | See notes |  |  | 2241 In stock as of 1/12/2015
191 | Hardware | HD-BT0039 | M3 x 12 Bolt, SHCS Black-Oxide |  | 8050-0312 | Timberline | 8050-0312 | 105 | ea | $0.012 | $1.23 | 159600 | PO05688 | 2015-01-02 | 2015-01-09
192 | Hardware | HD-BT0041 | M3 x 25 Bolt, SHCS Black-Oxide |  | 8050-0325 | Timberline | 8050-0325 | 5 | ea | $0.033 | $0.17 | 7600 | PO05688 | #N/A | 2015-01-09
193 | Hardware | HD-NT0011 | M4 Nut,Zinc-Plated Steel |  | 8100-0040 | Timberline | 8100-0040 | 4 | ea | $0.005 | $0.02 | 6080 | PO05688 | 2015-01-02 | 2015-01-09
194 | Hardware | HD-NT0007 | Metric Zinc-Plated Class 5 Steel Wing Nut M4 Screw Size, 0.7mm Pitch |  | 90671 | Fastenal | 90671 | 4 | ea | $0.419 | $1.68 | 6080 | PO06472 | 2015-02-18 | 2015-03-03
195 | Hardware | HD-WA0005 | M4 Washer |  | 8200-0040 | Timberline | 8200-0040 | 6 | ea | $0.004 | $0.02 | 9120 | PO05688 | 2015-01-02 | 2015-01-09
196 | Hardware | HD-BT0010 | M4 x 20 Bolt, SHCS Black-Oxide | 1139527 | 1139527 | Fastenal | 1139527 | 2 | ea | $0.014 | $0.03 | 3040 | PO05823 | 2015-01-02 | 2015-01-09
197 | Hardware | HD-BT0030 | Metric 8.8 Zinc-Pltd Steel Hex Head Cap Screw M4 Size, 20mm Length, .7mm Pitch, Fully Threaded |  | 8000-0420 | Timberline | 8000-0420 | 4 | ea | $0.032 | $0.13 | 6080 | PO05688 | 2015-01-02 | 2015-01-09
198 | Hardware | HD-BT0052 | M4 x 55 Bolt, SHCS Black-Oxide |  | NS8050-0455 | Timberline | NS8050-0455 | 2 | ea | $0.078 | $0.16 | 3040 | PO05688 | 2015-01-02 | 2015-01-09
199 | Hardware | HD-WA0007 | M5 Washer, Steel, Zinc Plated |  | 8200-0050 | Timberline | 8200-0050 | 109 | ea | $0.008 | $0.87 | 165680 | PO05688 | 2015-01-02 | 2015-01-09
200 | Hardware | HD-BT0055 | Class 10.9 STL Button Head Socket Cap Screw M5 Size, 8 mm Length, .8 mm Pitch |  | 40876 | Fastenal | 91239A222 | 4 | ea | $0.028 | $0.11 | 6080 | PO05823 | 2015-01-02 | 2015-01-09
201 | Hardware | HD-BT0048 | M5 x 10 Bolt, SHCS Black-Oxide |  | 8050-0510 | Timberline | 8050-0510 | 106 | ea | $0.022 | $2.33 | 161120 | PO05688 | 2015-01-02 | 2015-01-09
202 | Hardware | HD-BT0049 | M5 x 14 Bolt, SHCS Black_Oxide |  | 1139539 | Fastenal | NOR-M60051014SO | 12 | ea | $0.025 | $0.29 | 18240 | PO05823 | 2015-01-02 | 2015-01-09
203 | Hardware | HD-NT0002 | M8 Nyloc Nut, Zinc Plated |  | GBO-9862700004 | Timberline | 90576A117 | 3 | ea | $0.012 | $0.04 | 4560 | PO05688 | 2015-01-02 | 2015-01-09
204 | Hardware | HD-WA0006 | M8 Washer, Steel, Zinc Plated |  | 8200-0080 | Timberline | 8200-0080 | 9 | ea | $0.014 | $0.13 | 13680 | PO05688 | 2015-01-02 | 2015-01-09
205 | Hardware | HD-BT0059 | M8 x 35 Bolt, BHCS Black-oxide |  | NS8052-0835 | Timberline | NS8052-0835 | 2 | ea | $0.073 | $0.15 | 3040 | PO05688 | 2015-01-02 | 2015-01-09
206 | Hardware | HD-WA0008 | Metric Spring Steel Shim - DIN 988 0.5mm Thick, 8mm ID, 14mm OD |  | NS-010373 | Timberline | 98055A114 | 1 | ea | $0.050 | $0.05 | 1520 | PO05688 | 2015-01-02 | 2015-01-09 |  | McMaster 98055A114
207 | Hardware | HD-WA0009 | Metric Spring Steel Shim - DIN 988 1.0mm Thick, 8mm ID, 14mm OD |  | NS-010374 | Timberline | NS-010374 | 1 | ea | $0.060 | $0.06 | 1520 | PO05688 | 2015-01-02 | 2015-01-09 |  | McMaster-Carr Supply Company | 98055A115
208 | Hardware | HD-MS0031 | Thumb Screw Knob for M4 SHCS, Black |  | NSK-83-98-929B | Timberline | NSK-83-98-929B | 2 | ea | $0.095 | $0.19 | 3040 | PO05688 | 2015-01-02 | 2015-01-09
209 | Hardware | HD-MS0055 | Thumb Screw Knob for M5 SHCS, Black |  | NS-SHE#8398930B | Timberline / McMaster-Carr Supply Company | 91175A063 | 4 | ea | $0.130 | $0.52 | 6080 | PO06478 / PO06472 | 2015-02-18 | 2015-03-03
210 | Hardware | HD-MS0058 | Wire Tie, 8" |  | 7130K32 | Electronics Distributors Corp. | 7130K32 | 24 | ea | $0.020 | $0.47 | 34960 | PO05823 | 2015-01-02 | 2015-01-09 | qty was 23 | McMaster 7130K32
211 | Consumable | TL-CS0040 | Extreme-Temperature Pipe Sealant & Threadlocker, 4 oz bottle, blue |  |  | Mcmaster | 7604A55 | 0.5 | g | $0.066 | $0.03
212 | Accessories | SH-PG0069 | 3M 8898 Economy Strapping Tape - 1⁄2" x 60 yards |  |  | Uline | S-16075 | 700 | mm | $0.0001257655293 | $0.09 | 1064000 | PO05794 | 2014-12-31 | 2015-01-06 | 60 yard rolls 12 per case
213 | Accessories | SH-PG0072 | 3M 8898 Economy Strapping Tape - 2" x 60 yards |  |  | Uline | S-16076 | 600 | mm | $0.001 | $0.50 | 912000 | PO05794 | 2014-12-31 | 2015-01-06
214 | Accessories | DC-LB0023 | Circle Inventory Control Labels - "QC Passed" |  |  | Uline | S-13118 | 1 | ea | $0.036 | $0.04 | 1520 | PO05794 | 2014-12-31 | 2015-01-06
215 | Accessories | DC-LB0021 | Circle Inventory Control Labels - "Inspected by ____" |  |  | Uline | S-13119 | 1 | ea | $0.036 | $0.04 | 1520 | PO05794 | 2014-12-31 | 2015-01-06
216 | Packaging | DC-LB0030 | "CE" Regulated Label - 1 x 1" |  |  | Uline | S-13827 | 1 | ea | $0.03 | $0.03 | 1521 | PO05830 | 2015-01-06 | 2015-01-08
217 | Packaging | OF-MS0011 | 1" Circle Anti-Static Labels - RoHS Compliant" |  |  | Uline | S-13181 | 1 | ea | $0.01 | $0.01 | 1522 | PO05830 | 2015-01-06 | 2015-01-08
218 | Packaging | DC-MS0037 | Colorado Made Green Sticker |  |  | Alpha Graphics |  | 1 | ea | $0.15 | $0.15
219 | Packaging | DC-LB0037 | FCC Sticker, Blank |  |  | Aleph Objects |  | 1 | ea | $0.10 | $0.10
220 | Electronic | PC-BD0045 | RAMBO Electronics v1.3L | UltiMachine |  | UltiMachine |  | 1 | ea | $78.000 | $78.00 | 1520 | PO05567 | 2014-12-12 | 2015-01-06
221 | Mechanical | HD-MS0204 | 100 Sealed Skateboard/inline/Rollerblade Skate Bearing Ball Bearings |  |  | vxb.com | kit708 | 11 | ea | $0.200 | $2.20 | 16720 | PO04999 | 2014-11-19 | 2014-12-22
222 | Tools | TL-HD0009 | 7 1/2" Nylon Handle Clam Knife |  |  | WEBstaurant Store | 35340592 | 1 | ea | $2.030 | $2.03 | 1520 | PO05115 | 2014-11-05 | 2014-12-01

Sheet: KT-PR0017NA
Category | AO Part # | Description | Manufacturer | Manufacturer PN | Distributor | Distributor SKU | Qty Per | UOM | Price Per Unit | Price Total | Qty to Order | PO | Date | ETA
 |  |  |  |  |  |  |  |  |  | $1038.39 | 1100
Printer | KT-PR0017 | TAZ 3D Printer, v5.0 | Aleph Objects, Inc. | KT-PR0017 |  |  | 1 | ea | $1038.19 | $1038.19
Accessories | DC-LB0032 | Label, Lulzbot TAZ 5.0 Barcode, KT-PR0017NA |  |  | Lightspeed Color |  | 1 | ea | $0.143 | $0.14 | 1100
Accessories | DC-LB0031 | TAZ v5.0 serial number sticker, KT-PR0017NA |  |  | Lightspeed Color |  | 2 | ea | $0.029 | $0.06 | 2200

Sheet: KT-PR0017EU
Category | AO Part # | Description | Manufacturer | Manufacturer PN | Distributor | Distributor SKU | Qty Per | UOM | Price Per Unit | Price Total | Qty to Order | PO | Date | ETA
 |  |  |  |  |  |  |  |  |  | $1042.07 | 300
Printer | KT-PR0017 | TAZ 3D Printer, v5.0 | Aleph Objects, Inc. | KT-PR0017 |  |  | 1 | ea | $1038.19 | $1038.19
Accessories | DC-LB0034 | Label, Lulzbot TAZ 5.0 Barcode, KT-PR0017EU |  |  | Lightspeed Color |  | 1 | ea | $0.143 | $0.14 | 300
Accessories | DC-LB0033 | TAZ v5.0 serial number sticker, KT-PR0017EU |  |  | Lightspeed Color |  | 2 | ea | $0.029 | $0.06 | 600
Accessories | EL-CA0031 | 6ft 18AWG England Power Cord Cable - H05VV-F NEMA C13 – Black |  |  | Monoprice | 7691 | 1 | ea | $1.98 | $1.98 | 300 | PO05988 / PO06582 | 2015-03-03 | 2015-03-15 | Purchased 200 as directed in meeting before this page of the BOM was created. 2/25/15 Purchasing the others through new vendor linvox – same mfr part from monoprice -.36
Accessories | EL-CA0032 | 6ft 18AWG European Power Cord Cable - H05VV-F NEMA C13 – Black |  |  | Monoprice | 7692 | 1 | ea | $1.70 | $1.70 | 300 | PO05988 / PO06582 | 2015-03-03 | 2015-03-15 | Purchased 200 as directed in meeting before this page of the BOM was created. 2/25/15 Purchasing the others through new vendor linvox – same mfr part from monoprice -.51

Sheet: KT-PR0017AU
Category | AO Part # | Description | Manufacturer | Manufacturer PN | Distributor | Distributor SKU | Qty Per | UOM | Price Per Unit | Price Total | Qty to Order | PO | Date | ETA
 |  |  |  |  |  |  |  |  |  | $1039.59 | 100
Printer | KT-PR0017 | TAZ 3D Printer, v5.0 | Aleph Objects, Inc. | KT-PR0017 |  |  | 1 | ea | $1038.19 | $1038.19
Accessories | DC-LB0036 | Label, Lulzbot TAZ 5.0 Barcode, KT-PR0017AU |  |  | Lightspeed Color |  | 1 | ea | $0.143 | $0.14 | 100
Accessories | DC-LB0035 | TAZ v5.0 serial number sticker, KT-PR0017AU |  |  | Lightspeed Color |  | 2 | ea | $0.029 | $0.06 | 200
Accessories | EL-CA0056 | 6ft 18AWG Australian Power Cord Cable - H05VV-FNEMA C13 – Black |  |  | Monoprice | 7670 | 1 | ea | $1.20 | $1.20 | 100 | PO06582
