brut/3dp_taz/Juniper/spec.xlsx

Sheet: изготовление
# | наименование | обозначение | кол-во
1
2

Sheet: URLs
инструкция по сборке | https://ohai-kit.alephobjects.com/group/taz-4/
