brut/3dp_taz/1.0/FCStd/TK0_Assembly.fcstd

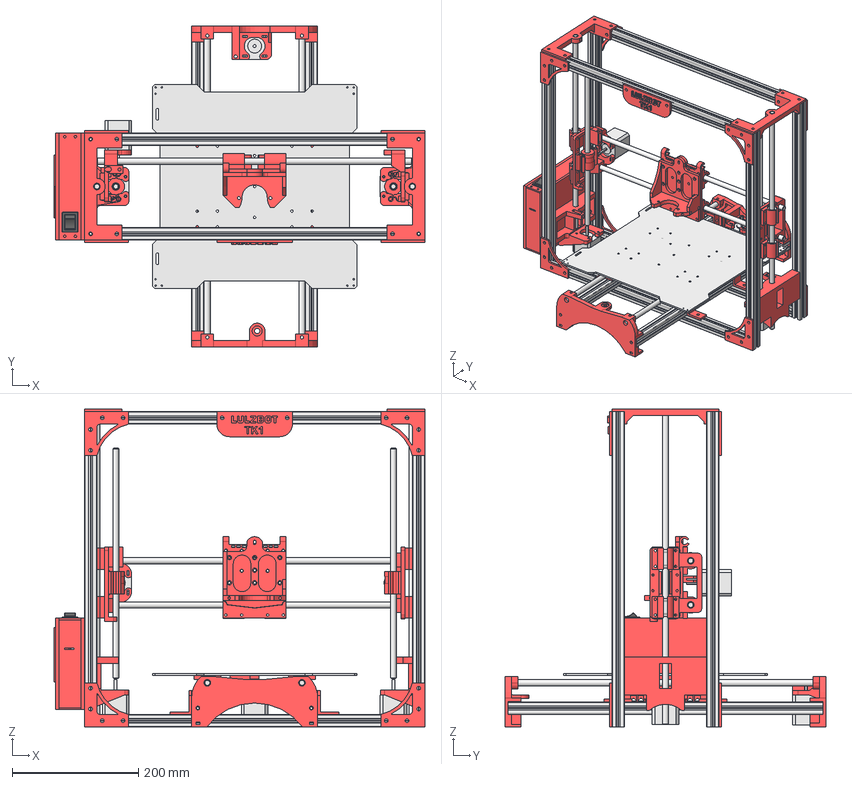
[picture p1: CAD file, 2015-04-01]
1.0/FCStd/TK0_Assembly.fcstd
588.0 x 508.0 x 504.0 mm
HFS5_2020x500mm
HFS5_2020x500mm001
HFS5_2020x500mm002
HFS5_2020x500mm003
FrameConnectors
FrameConnectors001
FrameConnectors002
FrameConnectors003
HFS5_2020x500mm004
HFS5_2020x500mm005
HFS5_2020x500mm006
HFS5_2020x500mm007
FrameConnectors004
FrameConnectors005
FrameConnectors006
FrameConnectors007
Z_top
Z_top001
Z_MotorMount
Z_MotorMount001
smooth_rod_10x500mm
smooth_rod_10x500mm001
NEMA_17_StepperMotor
NEMA_17_StepperMotor001
NamePlate
threaded_rod_0375_12_365mm
threaded_rod_0375_12_365mm001
HFS5_2020x500mm008
HFS5_2020x500mm009
Y_Bearing_4mmoffset
Y_Motor
smooth_rod_10x500mm002
smooth_rod_10x500mm003
NEMA_17_StepperMotor002
Y_FrameConnectorA
Y_FrameConnectorA001
Y_FrameConnectorB
Y_FrameConnectorB001
Y_FrameConnectorA002
Y_FrameConnectorA003
Y_FrameConnectorB002
Y_FrameConnectorB003
Bearing_Holder
Bearing_Holder001
Bearing_Holder002
Bearing_Holder003
LM10UU_LinearBearing
LM10UU_LinearBearing001
LM10UU_LinearBearing002
LM10UU_LinearBearing003
Y_Bed
Y_BeltMount
X_BearingForSpring
Bearing_Holder004
Bearing_Holder005
LM10UU_LinearBearing004
LM10UU_LinearBearing005
smooth_rod_10x500mm004
smooth_rod_10x500mm005
Bearing_Holder006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
