brut/3dp_taz/1.0/FCStd/HFS5-2020-500.fcstd

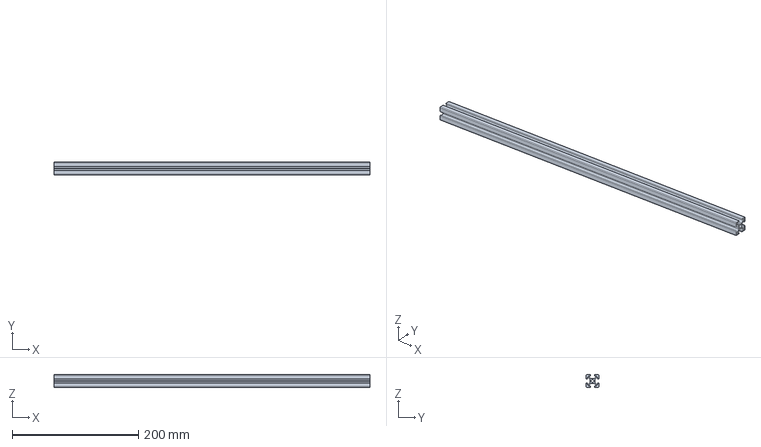
[picture p2: CAD file, 2015-04-01]
1.0/FCStd/HFS5-2020-500.fcstd
500.0 x 20.0 x 20.0 mm
