brut/3dp_taz/1.0/STEP/threaded_rod_0375-12_365mm.stp

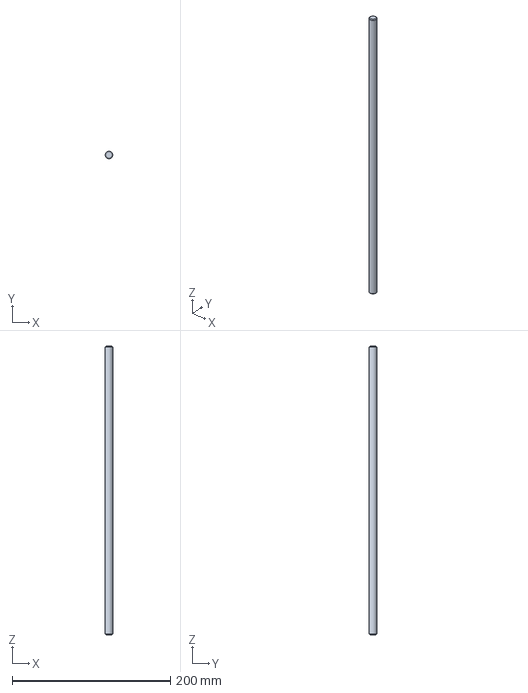
[picture p3: CAD file, 2015-04-01]
1.0/STEP/threaded_rod_0375-12_365mm.stp
9.52 x 9.52 x 365.0 mm
