brut/3dp_taz/Juniper/ToPrint/FreeCAD/X_SingleExtruderMountOffset_v1.1.1.fcstd

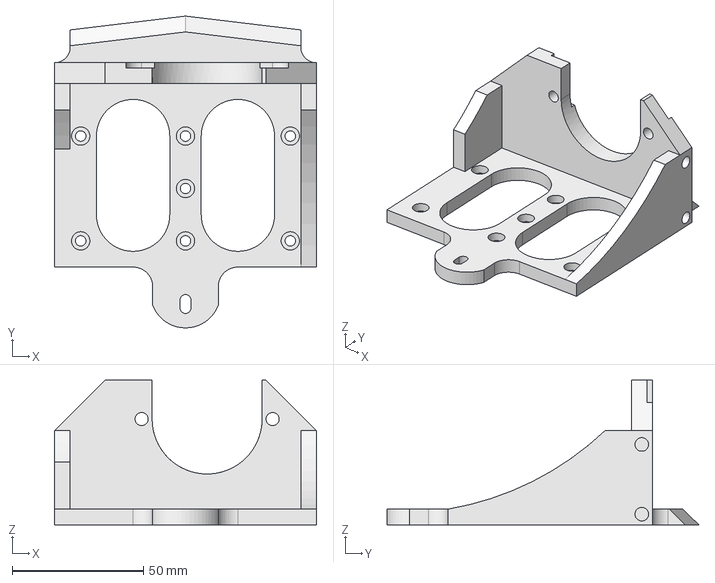
[picture p4: CAD file, 2015-04-01]
Juniper/ToPrint/FreeCAD/X_SingleExtruderMountOffset_v1.1.1.fcstd
100.0 x 119.0 x 55.2 mm
