brut/3dp_taz/Juniper/ToPrint/STL/PP-GP0153 fan_mount_3_ss.STL

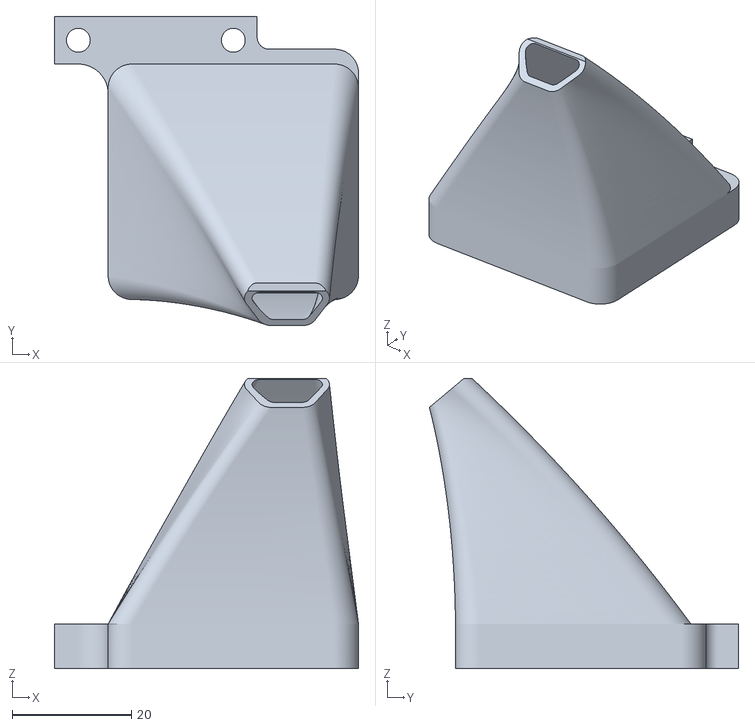
[picture p5: CAD file, 2015-04-01]
Juniper/ToPrint/STL/PP-GP0153 fan_mount_3_ss.STL
51.0 x 51.9 x 48.7
