brut/3dp_taz/1.0/STEP/glass_corner.stp

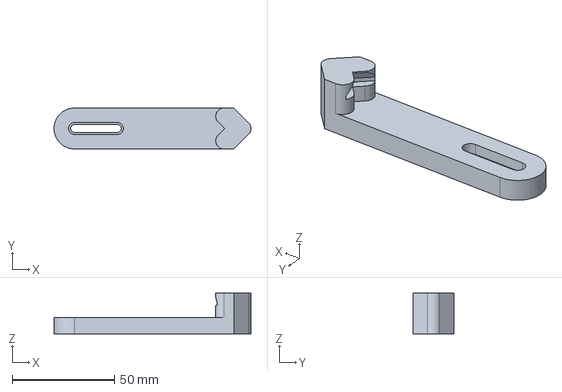
[picture p6: CAD file, 2015-04-01]
1.0/STEP/glass_corner.stp
96.3 x 20.0 x 20.0 mm
