brut/3dp_taz/Juniper/ToPrint/STL/PP-GP0126 z_motor_mount-v2.1-switch-left_ebe_s.stl

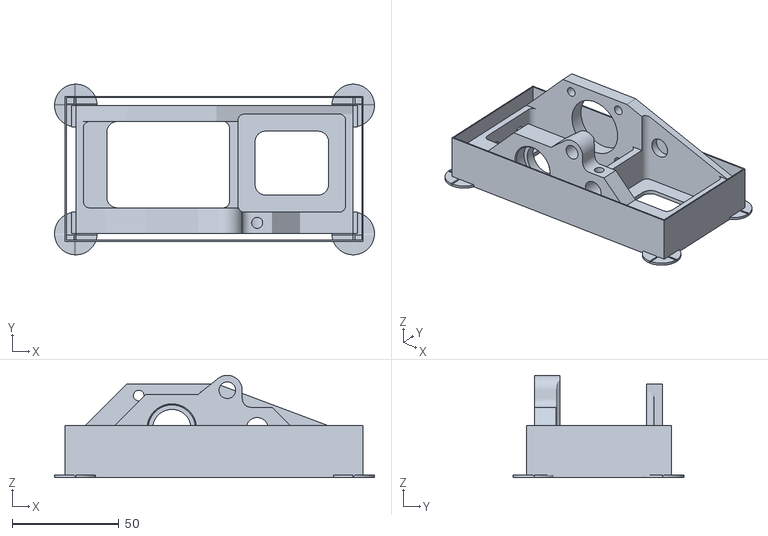
[picture p7: CAD file, 2015-04-01]
Juniper/ToPrint/STL/PP-GP0126 z_motor_mount-v2.1-switch-left_ebe_s.stl
150.0 x 80.0 x 48.0
