brut/3dp_taz/1.0/STEP/ElectronicEnclosureSDSlotSide.stp

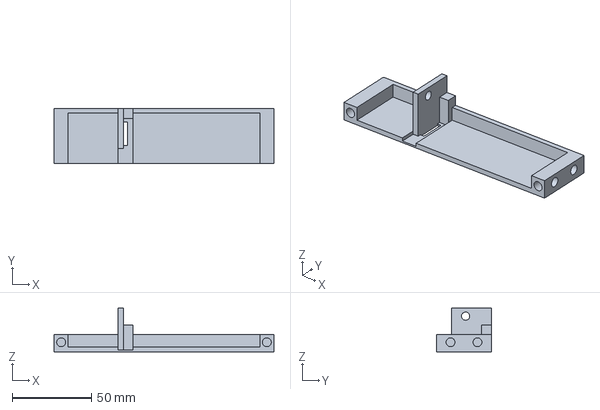
[picture p8: CAD file, 2015-04-01]
1.0/STEP/ElectronicEnclosureSDSlotSide.stp
139.0 x 35.0 x 27.5 mm
