brut/3dp_taz/Juniper/ToPrint/FreeCAD/PP-GP0163 long_shim.fcstd

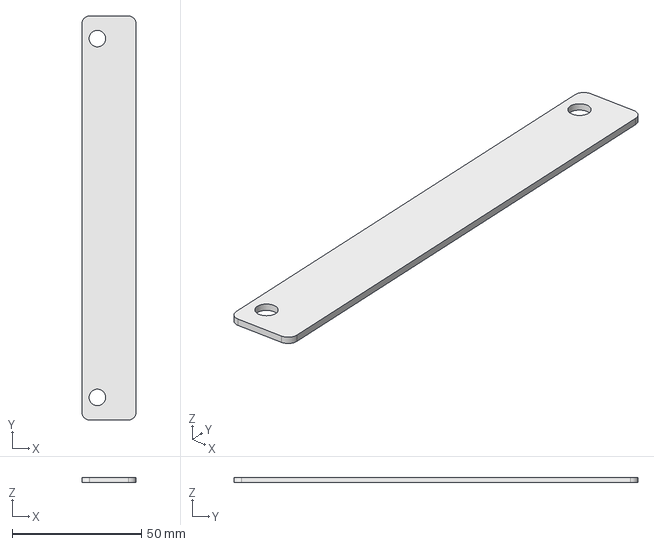
[picture p9: CAD file, 2015-04-01]
Juniper/ToPrint/FreeCAD/PP-GP0163 long_shim.fcstd
21.0 x 156.5 x 2.00 mm
