brut/3dp_taz/Juniper/ToPrint/STL/PP-GP0116 y_motor_mount_v2.4.STL

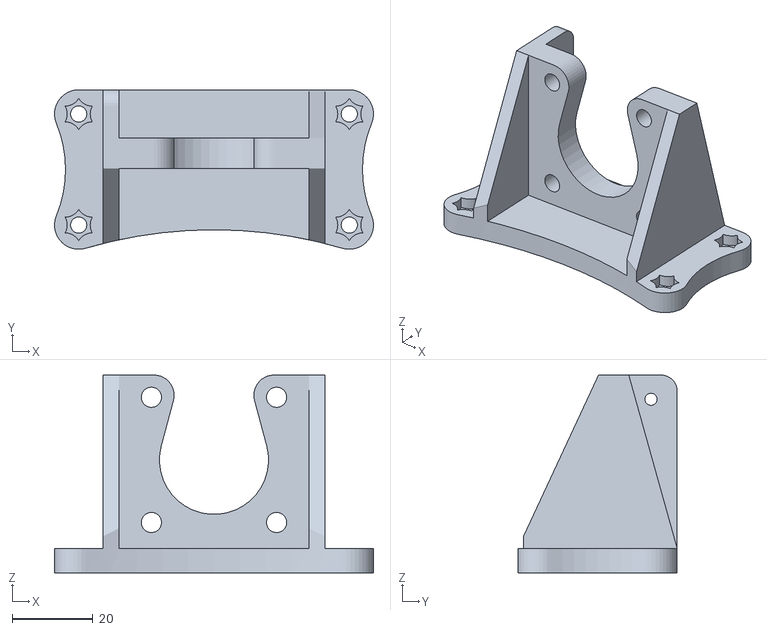
[picture p10: CAD file, 2015-04-01]
Juniper/ToPrint/STL/PP-GP0116 y_motor_mount_v2.4.STL
79.0 x 39.5 x 49.0
