brut/3dp_taz/1.0/STEP/X_Carriage_QuickGuide.stp

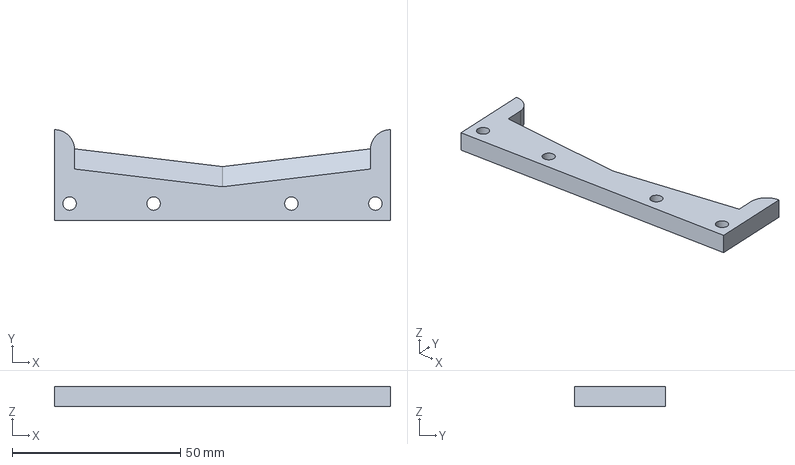
[picture p11: CAD file, 2015-04-01]
1.0/STEP/X_Carriage_QuickGuide.stp
100.0 x 27.0 x 6.00 mm
