brut/3dp_taz/Juniper/ToPrint/STL/PP-GP0113 y_corner_left-v1.4.stl

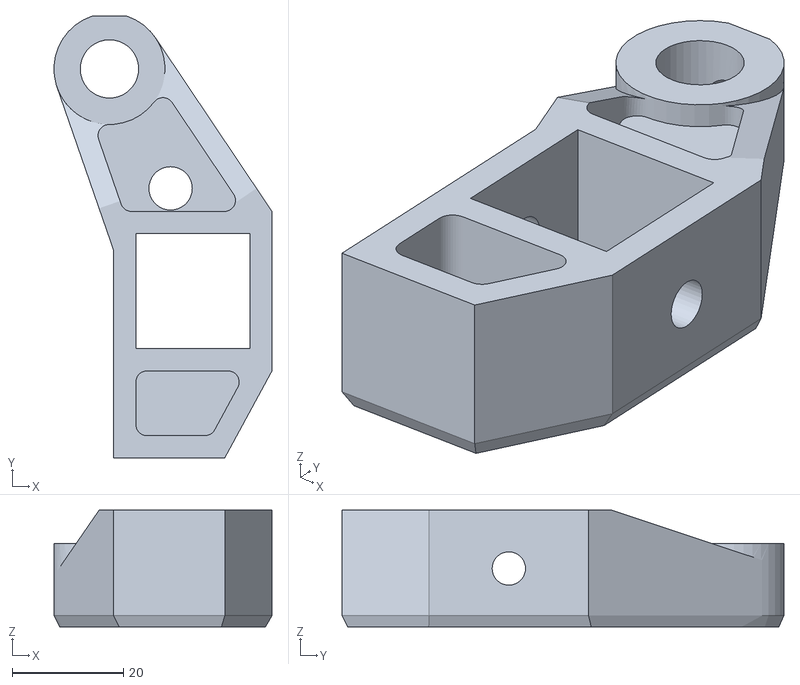
[picture p12: CAD file, 2015-04-01]
Juniper/ToPrint/STL/PP-GP0113 y_corner_left-v1.4.stl
39.2 x 79.5 x 21.0
