brut/3dp_taz/1.0/STEP/CableHolder.stp

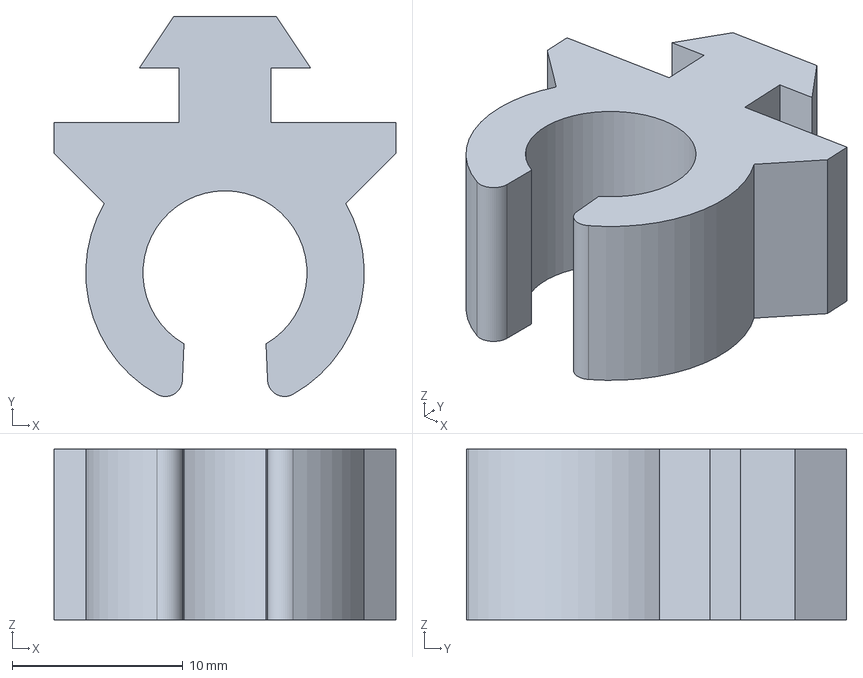
[picture p13: CAD file, 2015-04-01]
1.0/STEP/CableHolder.stp
20.0 x 22.2 x 10.0 mm
