brut/3dp_taz/Juniper/ToPrint/FreeCAD/PP-GP0125 z_motor_mount-v2.1-nonswitch-right_easy-break-ears.fcstd

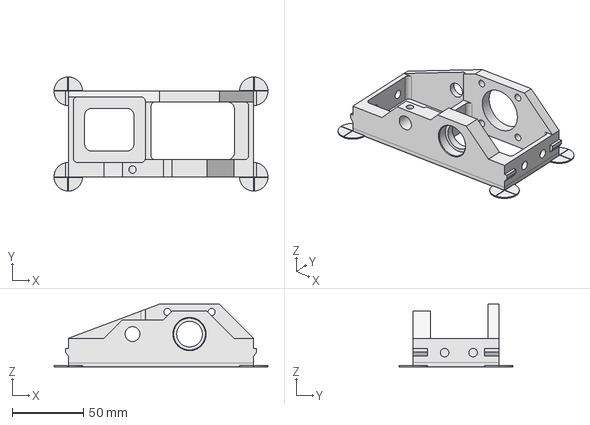
[picture p14: CAD file, 2015-04-01]
Juniper/ToPrint/FreeCAD/PP-GP0125 z_motor_mount-v2.1-nonswitch-right_easy-break-ears.fcstd
150.0 x 80.0 x 44.0 mm
