brut/3dp_taz/Juniper/ToPrint/STL/PP-GP0124 z_top_drive_right-v1.3.stl

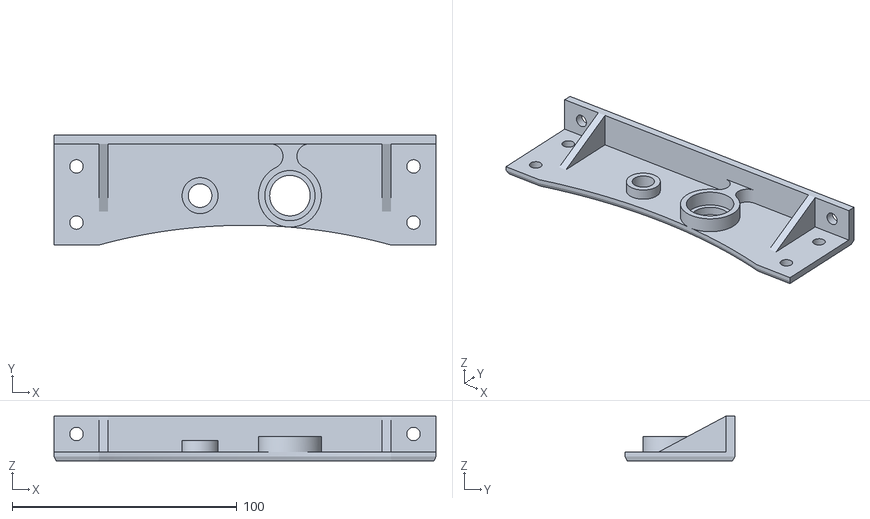
[picture p15: CAD file, 2015-04-01]
Juniper/ToPrint/STL/PP-GP0124 z_top_drive_right-v1.3.stl
170.0 x 49.0 x 20.0
