brut/3dp_taz/1.0/STEP/X_MotorForSpring.stp

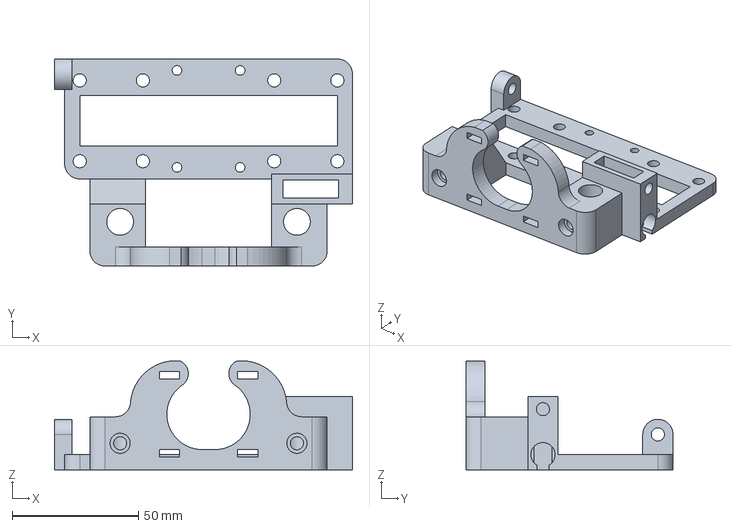
[picture p16: CAD file, 2015-04-01]
1.0/STEP/X_MotorForSpring.stp
118.0 x 82.0 x 43.0 mm
