brut/3dp_taz/Juniper/ToPrint/FreeCAD/Y_Bearing-4mmoffset_v1.1.fcstd

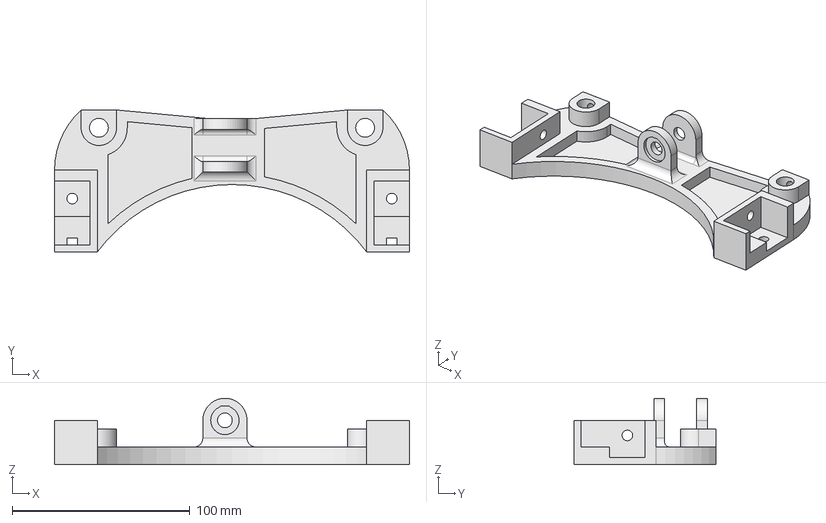
[picture p17: CAD file, 2015-04-01]
Juniper/ToPrint/FreeCAD/Y_Bearing-4mmoffset_v1.1.fcstd
200.0 x 80.0 x 37.5 mm
