brut/3dp_taz/Juniper/ToPrint/STL/PP-GP0115 y_bearing_mount_v2.6.b.STL

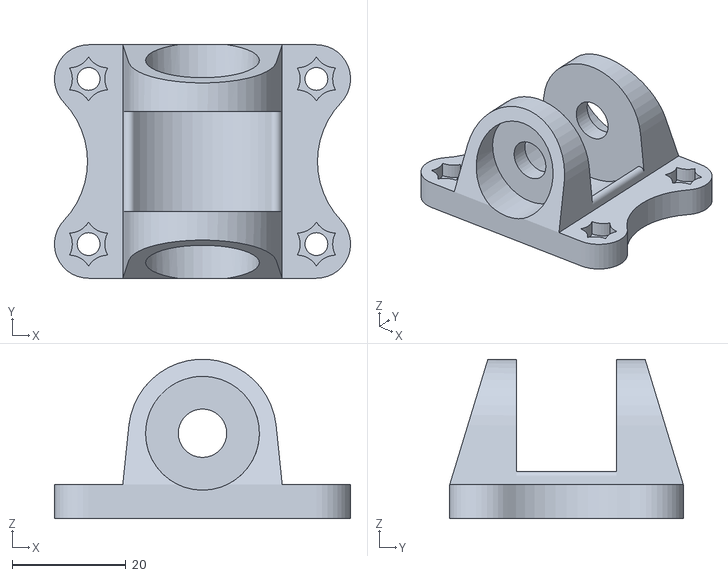
[picture p18: CAD file, 2015-04-01]
Juniper/ToPrint/STL/PP-GP0115 y_bearing_mount_v2.6.b.STL
52.0 x 41.0 x 28.0
