brut/3dp_taz/Juniper/ToPrint/FreeCAD/PP-GP0154 electronics_case_mount_v1.1.fcstd

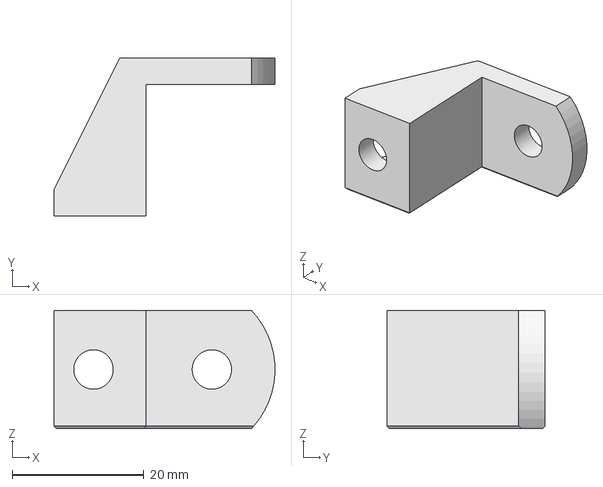
[picture p19: CAD file, 2015-04-01]
Juniper/ToPrint/FreeCAD/PP-GP0154 electronics_case_mount_v1.1.fcstd
33.6 x 24.0 x 18.0 mm
