brut/3dp_taz/Juniper/ToPrint/STL/budaschnozzle1_1.stl

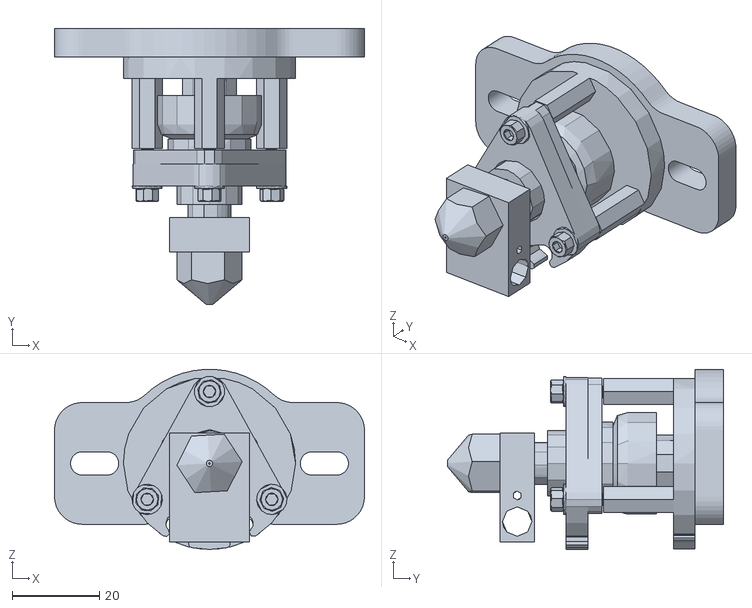
[picture p20: CAD file, 2015-04-01]
Juniper/ToPrint/STL/budaschnozzle1_1.stl
71.1 x 63.3 x 41.3
