brut/3dp_taz/1.0/STEP/ElectronicEnclosurePowerCordSide.stp

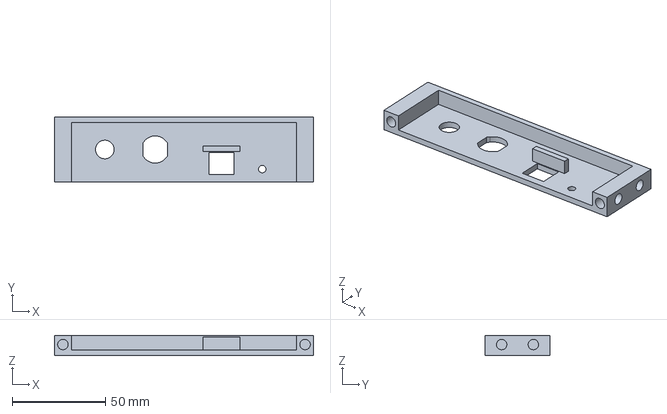
[picture p21: CAD file, 2015-04-01]
1.0/STEP/ElectronicEnclosurePowerCordSide.stp
139.0 x 35.0 x 11.0 mm
