brut/3dp_taz/Juniper/ToPrint/FreeCAD/PP-GP0126 z_motor_mount-v2.1-switch-left.fcstd

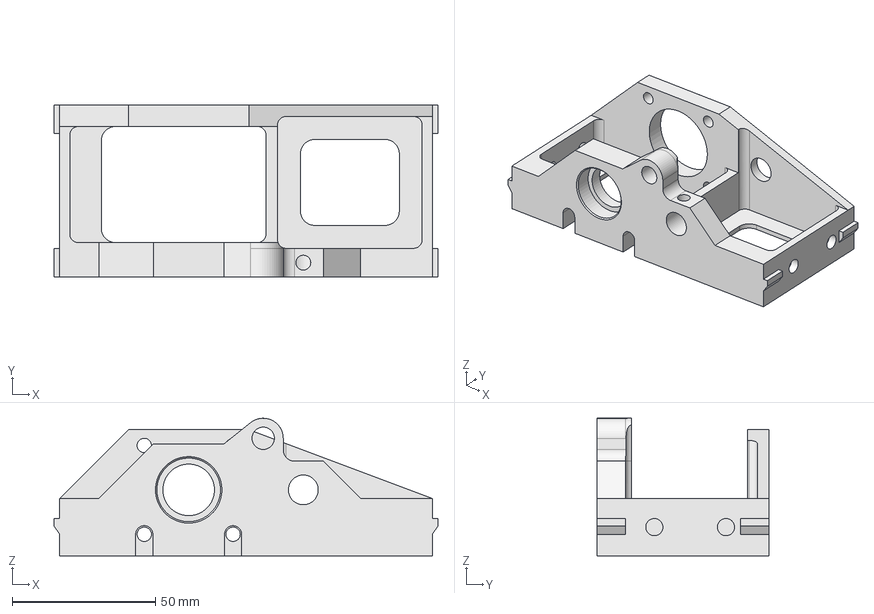
[picture p22: CAD file, 2015-04-01]
Juniper/ToPrint/FreeCAD/PP-GP0126 z_motor_mount-v2.1-switch-left.fcstd
134.0 x 60.0 x 48.0 mm
