brut/3dp_taz/Juniper/ToPrint/STL/PP-GP0150 y_belt_mount-2.4.stl

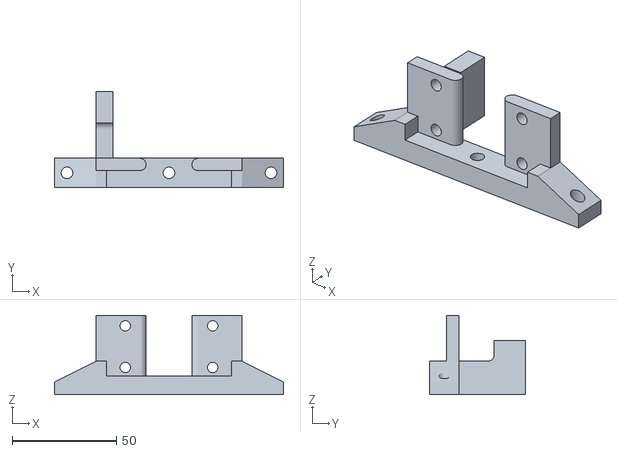
[picture p23: CAD file, 2015-04-01]
Juniper/ToPrint/STL/PP-GP0150 y_belt_mount-2.4.stl
110.0 x 46.0 x 38.0
