brut/3dp_taz/1.0/STEP/Y_FrameConnectorA.stp

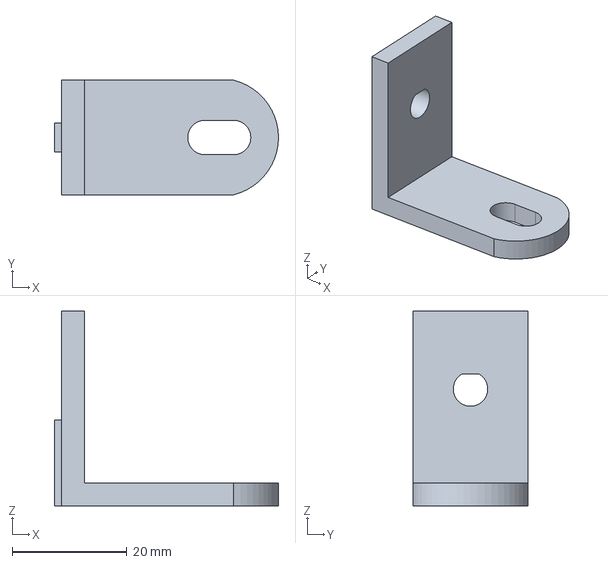
[picture p24: CAD file, 2015-04-01]
1.0/STEP/Y_FrameConnectorA.stp
39.1 x 20.0 x 34.0 mm
