brut/3dp_taz/Juniper/ToPrint/FreeCAD/PP-GP0122 y_mount_table-2.1.fcstd

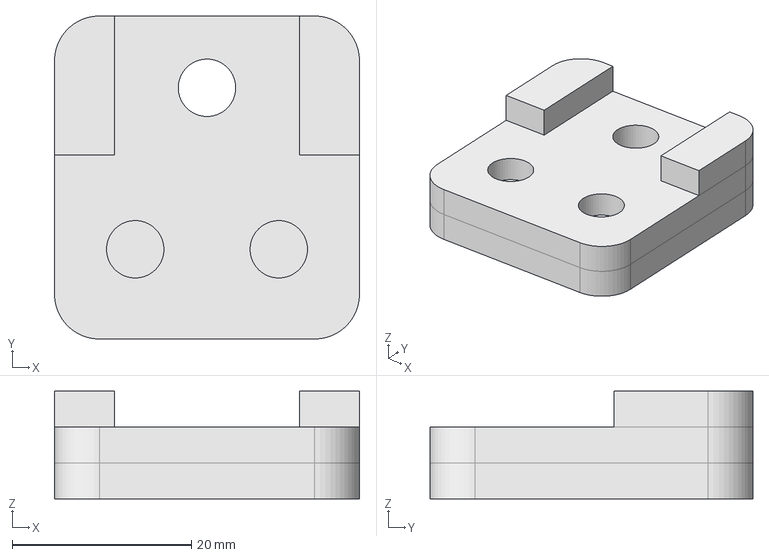
[picture p25: CAD file, 2015-04-01]
Juniper/ToPrint/FreeCAD/PP-GP0122 y_mount_table-2.1.fcstd
34.0 x 36.0 x 12.0 mm
