brut/3dp_taz/1.0/STEP/ElectronicEnclosureTop.stp

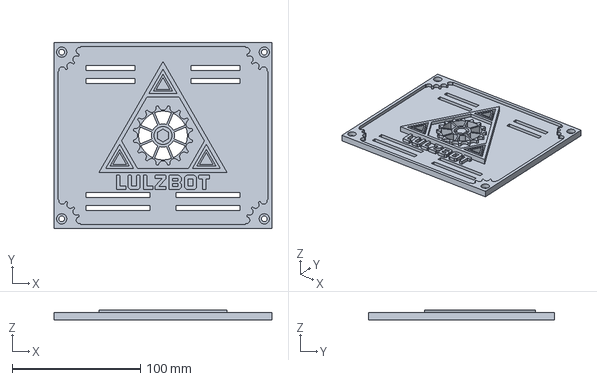
[picture p26: CAD file, 2015-04-01]
1.0/STEP/ElectronicEnclosureTop.stp
170.0 x 145.0 x 8.00 mm
