brut/3dp_taz/Juniper/ToPrint/FreeCAD/PP-GP0125 z_motor_mount-v2.1-nonswitch-right.fcstd

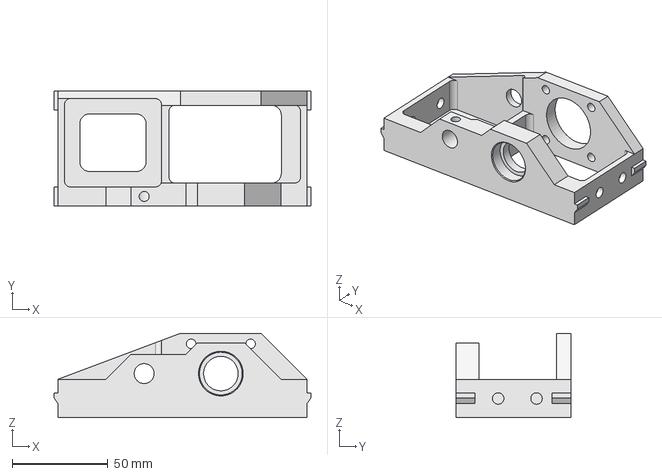
[picture p27: CAD file, 2015-04-01]
Juniper/ToPrint/FreeCAD/PP-GP0125 z_motor_mount-v2.1-nonswitch-right.fcstd
134.0 x 60.0 x 44.0 mm
