brut/3dp_taz/1.0/STEP/X_BearingForSpring.stp

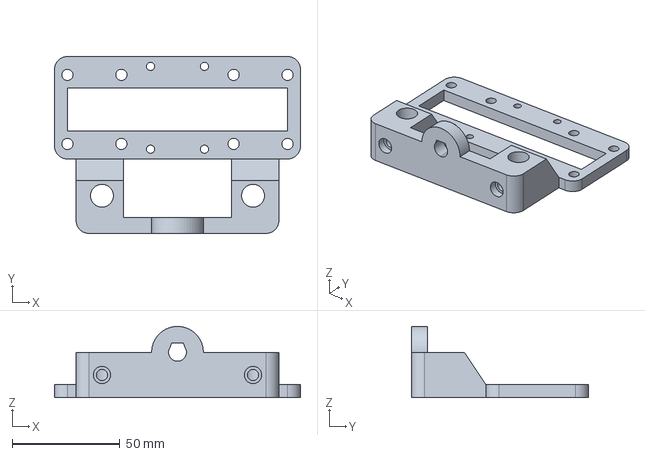
[picture p28: CAD file, 2015-04-01]
1.0/STEP/X_BearingForSpring.stp
114.0 x 82.0 x 33.0 mm
