brut/3dp_taz/Juniper/ToPrint/STL/PP-GP0121 y_mount_chassis-2.2.stl

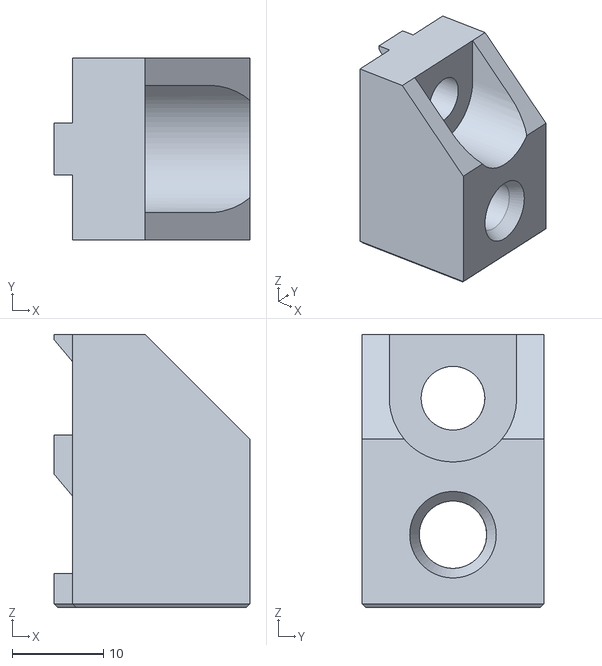
[picture p30: CAD file, 2015-04-01]
Juniper/ToPrint/STL/PP-GP0121 y_mount_chassis-2.2.stl
21.5 x 20.0 x 30.0
