brut/3dp_taz/1.0/STEP/LM10UU_LinearBearing.stp

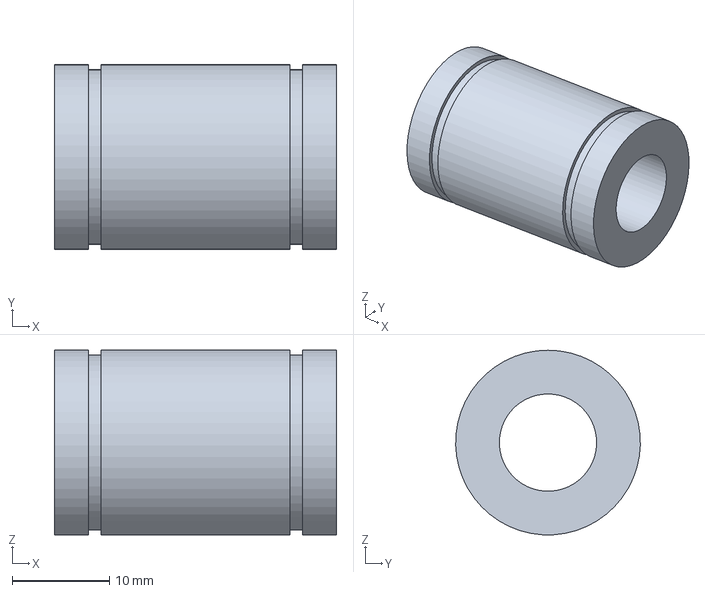
[picture p31: CAD file, 2015-04-01]
1.0/STEP/LM10UU_LinearBearing.stp
29.0 x 19.0 x 19.0 mm
