brut/3dp_taz/Juniper/ToPrint/FreeCAD/PP-GP0152 x_motor_mount-v2.1.fcstd

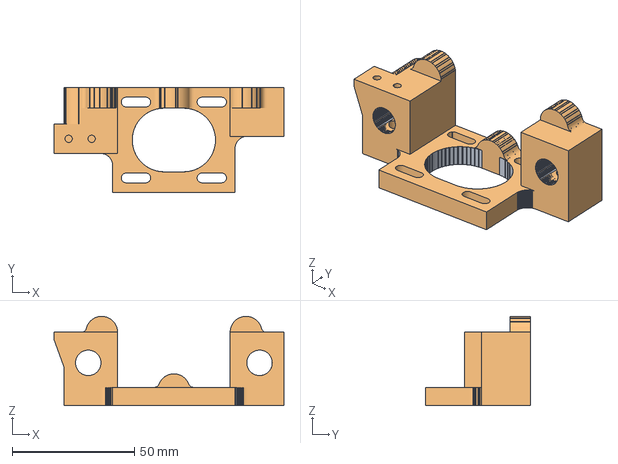
[picture p32: CAD file, 2015-04-01]
Juniper/ToPrint/FreeCAD/PP-GP0152 x_motor_mount-v2.1.fcstd
94.0 x 43.0 x 36.5 mm
Pad005 (Meshed)
