brut/3dp_taz/Juniper/ToPrint/STL/PP-GP0125 z_motor_mount-v2.1-nonswitch-right_easy-break-ears_skirt.stl

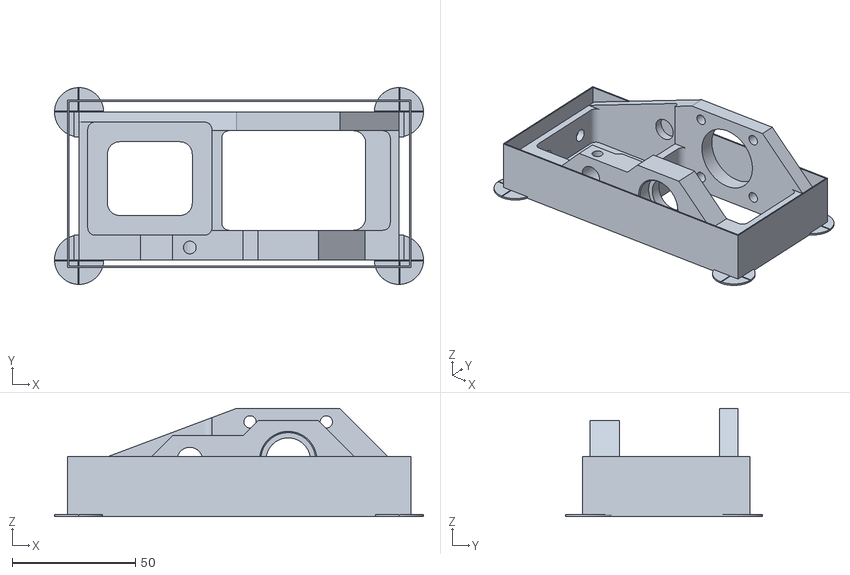
[picture p33: CAD file, 2015-04-01]
Juniper/ToPrint/STL/PP-GP0125 z_motor_mount-v2.1-nonswitch-right_easy-break-ears_skirt.stl
150.0 x 80.0 x 44.0
