brut/3dp_taz/1.0/STEP/ElectronicEnclosureBottom.stp

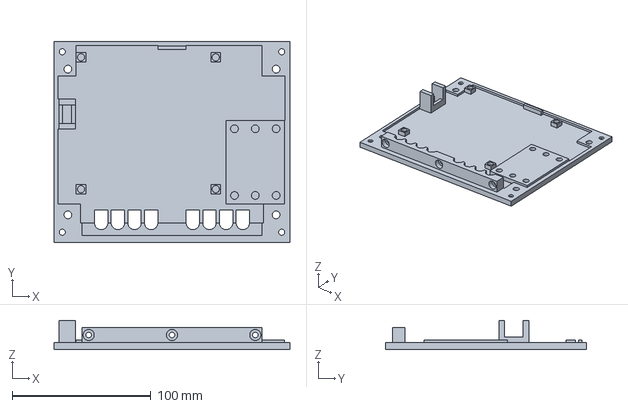
[picture p34: CAD file, 2015-04-01]
1.0/STEP/ElectronicEnclosureBottom.stp
170.0 x 145.0 x 21.0 mm
