brut/3dp_taz/Juniper/ToPrint/FreeCAD/jonaskuehling_gregs-wade-ao-v3.1.3-idler.fcstd

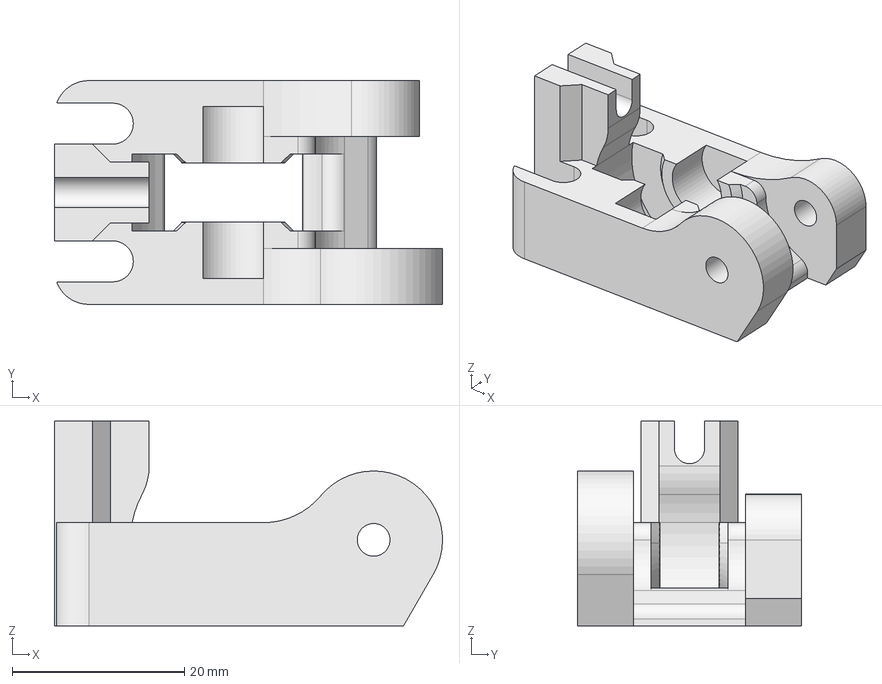
[picture p35: CAD file, 2015-04-01]
Juniper/ToPrint/FreeCAD/jonaskuehling_gregs-wade-ao-v3.1.3-idler.fcstd
45.1 x 26.0 x 23.8 mm
