brut/3dp_taz/Juniper/ToPrint/FreeCAD/PP-GP0128 X_Carriage_v1.2.fcstd

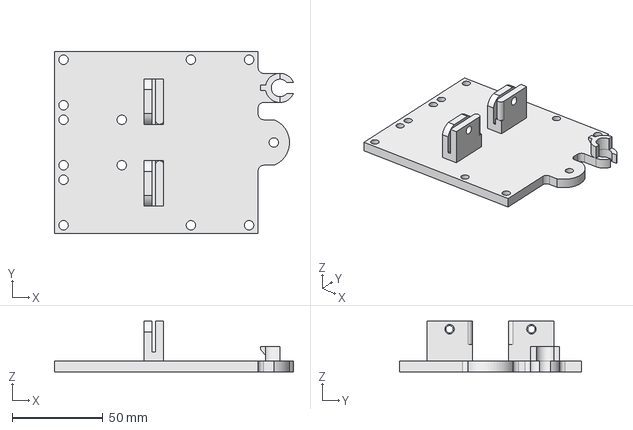
[picture p36: CAD file, 2015-04-01]
Juniper/ToPrint/FreeCAD/PP-GP0128 X_Carriage_v1.2.fcstd
131.4 x 100.0 x 28.0 mm
