brut/3dp_taz/Juniper/ToPrint/STL/PP-GP0109 spool_arm_2.1.stl

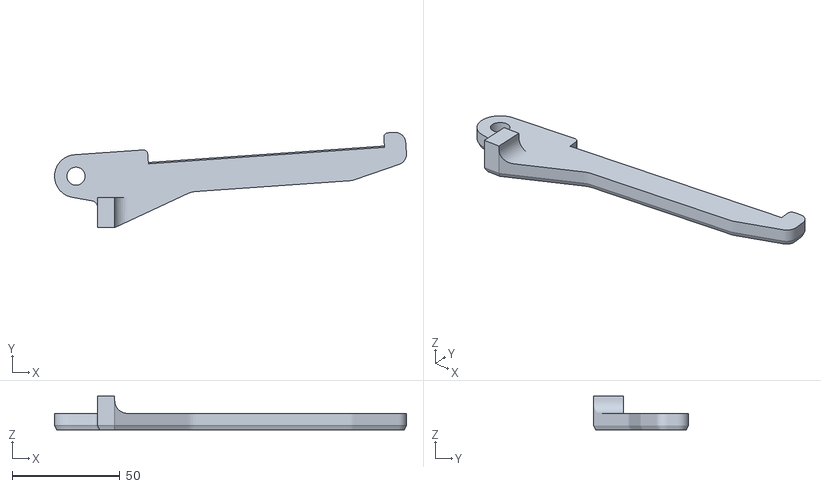
[picture p37: CAD file, 2015-04-01]
Juniper/ToPrint/STL/PP-GP0109 spool_arm_2.1.stl
163.6 x 44.3 x 15.6
