brut/3dp_taz/1.0/STEP/rocker_switch.stp

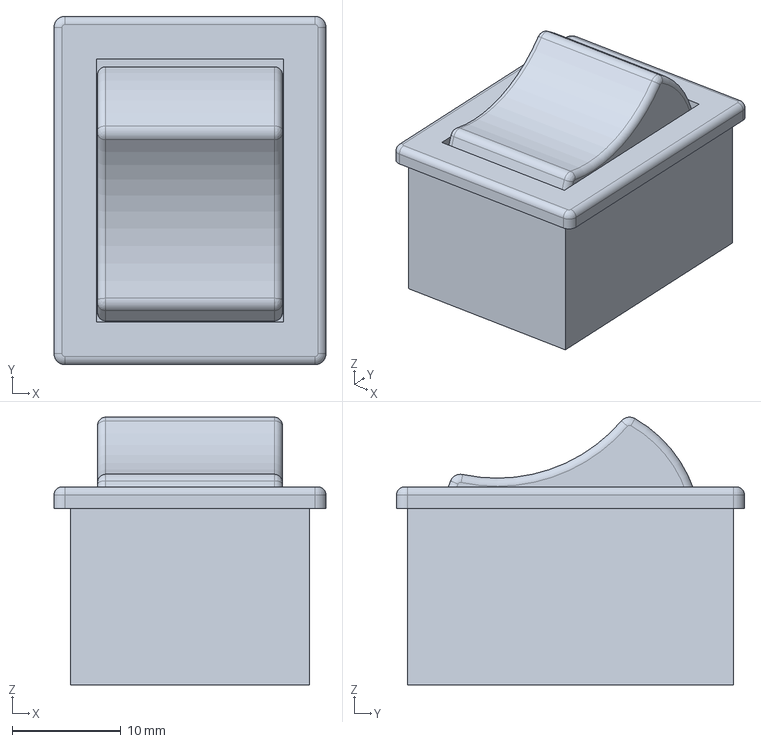
[picture p38: CAD file, 2015-04-01]
1.0/STEP/rocker_switch.stp
25.0 x 32.0 x 24.6 mm
