brut/3dp_taz/Juniper/ToPrint/FreeCAD/X_BearingForSpring_v1.2.fcstd

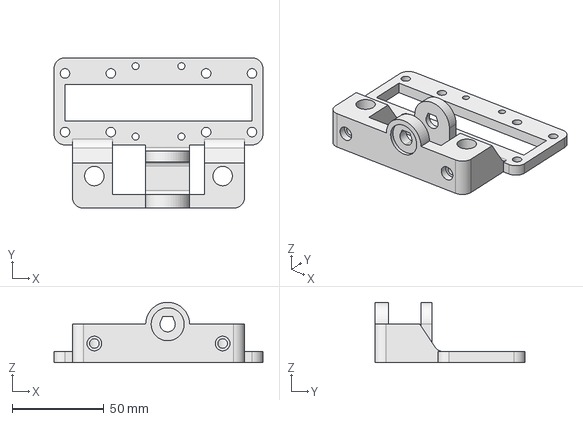
[picture p39: CAD file, 2015-04-01]
Juniper/ToPrint/FreeCAD/X_BearingForSpring_v1.2.fcstd
114.0 x 82.0 x 33.0 mm
