brut/3dp_taz/Juniper/ToPrint/STL/PP-GP0089 lcd_spacer_v0.4.stl

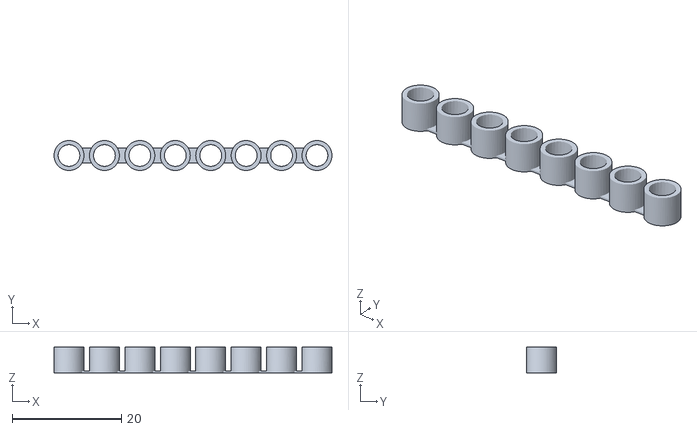
[picture p40: CAD file, 2015-03-31]
Juniper/ToPrint/STL/PP-GP0089 lcd_spacer_v0.4.stl
51.0 x 5.50 x 4.75
