brut/3dp_taz/1.0/STEP/X_SingleExtruderShield.stp

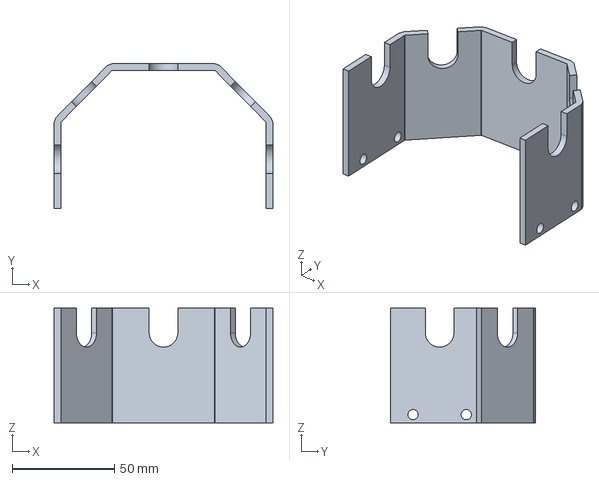
[picture p41: CAD file, 2015-04-01]
1.0/STEP/X_SingleExtruderShield.stp
107.0 x 70.8 x 56.0 mm
