brut/3dp_taz/Juniper/ToPrint/FreeCAD/PP-GP0123 z_top_drive_v1.2-left.fcstd

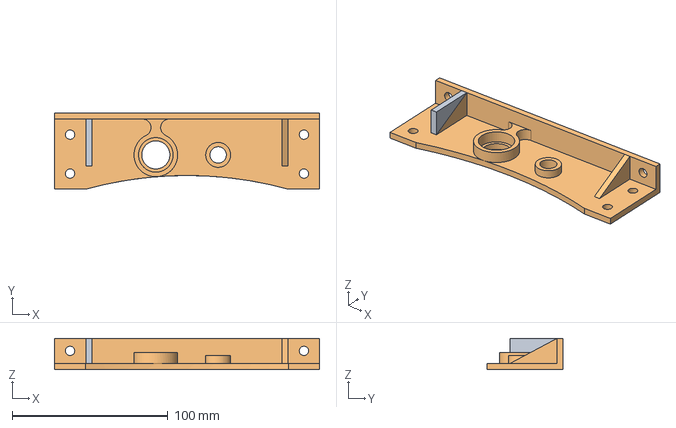
[picture p42: CAD file, 2015-04-01]
Juniper/ToPrint/FreeCAD/PP-GP0123 z_top_drive_v1.2-left.fcstd
170.0 x 49.0 x 20.0 mm
