brut/3dp_taz/1.0/STEP/smooth_rod_10x500mm.stp

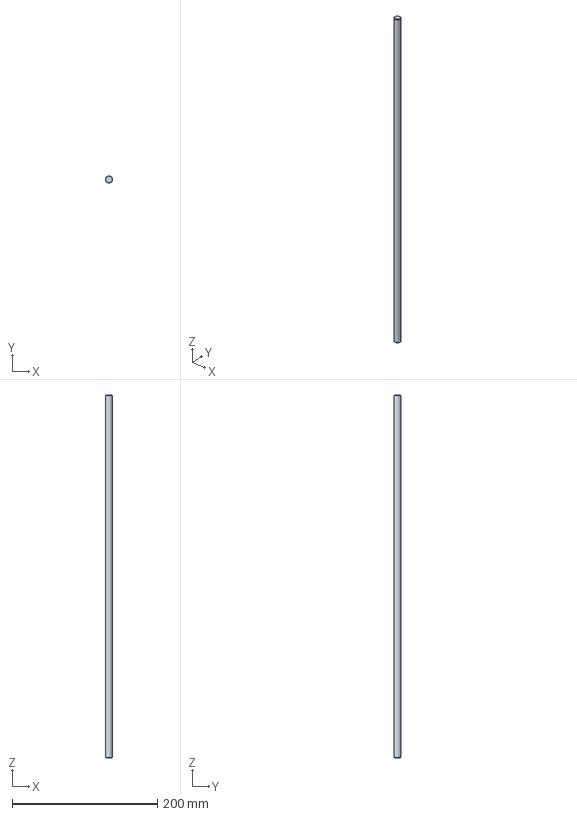
[picture p43: CAD file, 2015-04-01]
1.0/STEP/smooth_rod_10x500mm.stp
9.99 x 10.00 x 500.0 mm
