brut/3dp_taz/Juniper/ToPrint/STL/PP-GP0194 extruder_mount_hex.STL

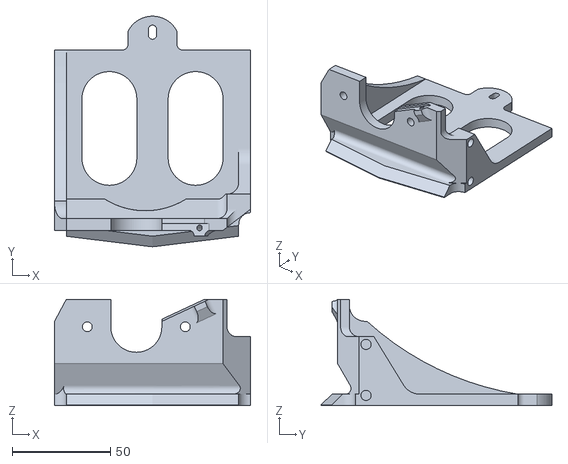
[picture p44: CAD file, 2015-03-31]
Juniper/ToPrint/STL/PP-GP0194 extruder_mount_hex.STL
100.0 x 117.7 x 54.2
