brut/3dp_taz/1.0/STEP/Y_FrameConnectorB.stp

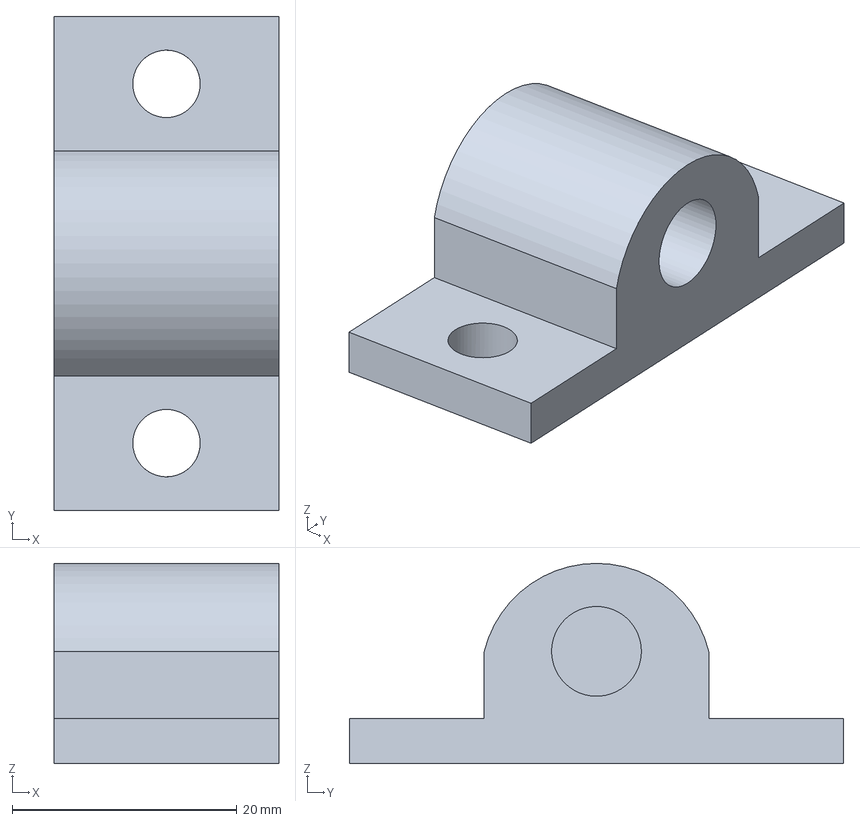
[picture p45: CAD file, 2015-04-01]
1.0/STEP/Y_FrameConnectorB.stp
20.0 x 44.0 x 17.8 mm
