brut/3dp_taz/Juniper/ToPrint/FreeCAD/extruder_mt_fangtooth-guppy_0.5.fcstd

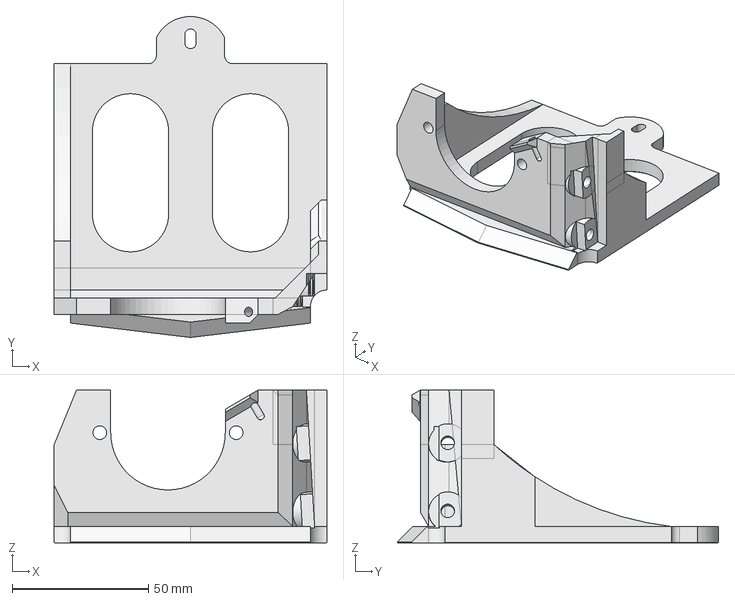
[picture p46: CAD file, 2015-04-01]
Juniper/ToPrint/FreeCAD/extruder_mt_fangtooth-guppy_0.5.fcstd
100.0 x 117.7 x 56.0 mm
