brut/3dp_taz/Juniper/ToPrint/STL/PP-GP0083 bed_finger-2.1.STL

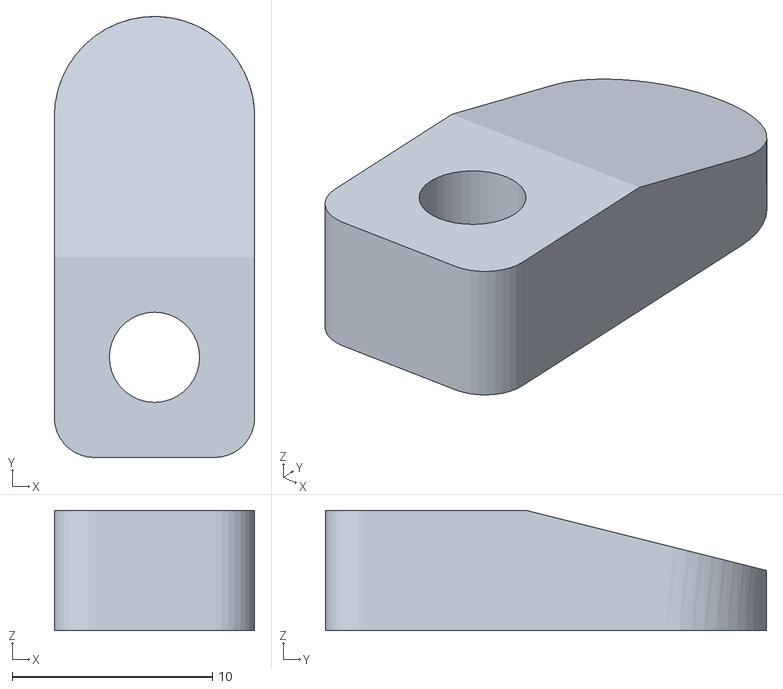
[picture p47: CAD file, 2015-03-31]
Juniper/ToPrint/STL/PP-GP0083 bed_finger-2.1.STL
10.0 x 22.0 x 6.00
