brut/3dp_taz/1.0/STEP/Z_top.stp

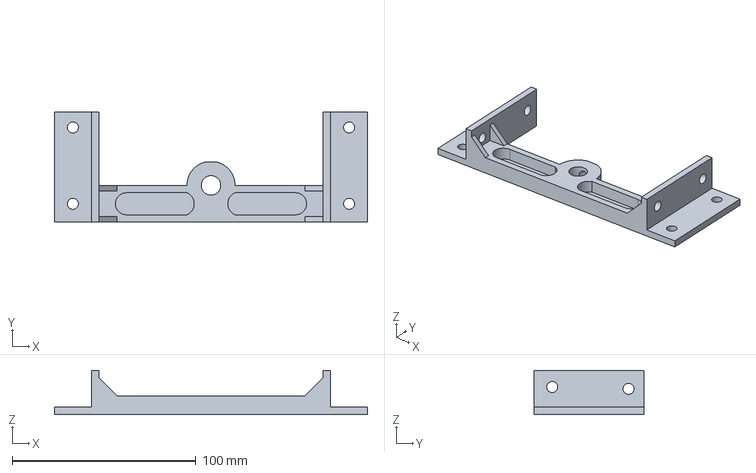
[picture p48: CAD file, 2015-04-01]
1.0/STEP/Z_top.stp
170.2 x 60.0 x 24.0 mm
