brut/3dp_taz/Juniper/ToPrint/STL/PP-GP0086 belt_clamp-2.0.stl

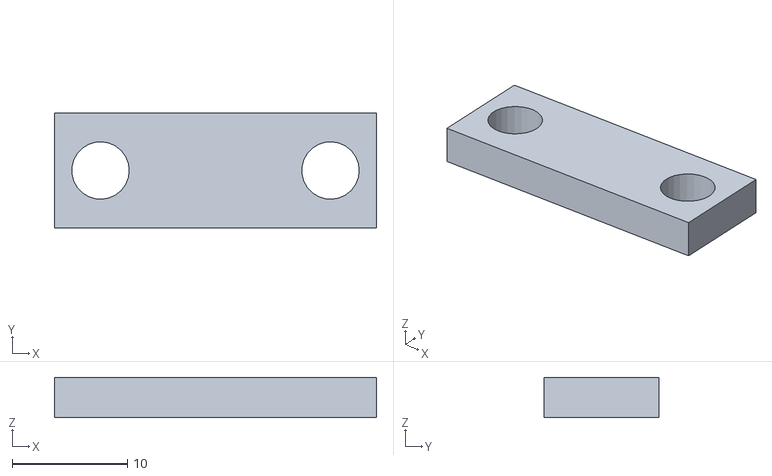
[picture p49: CAD file, 2015-03-31]
Juniper/ToPrint/STL/PP-GP0086 belt_clamp-2.0.stl
28.0 x 10.0 x 3.50
