brut/3dp_taz/1.0/STEP/Bearing_Holder.stp

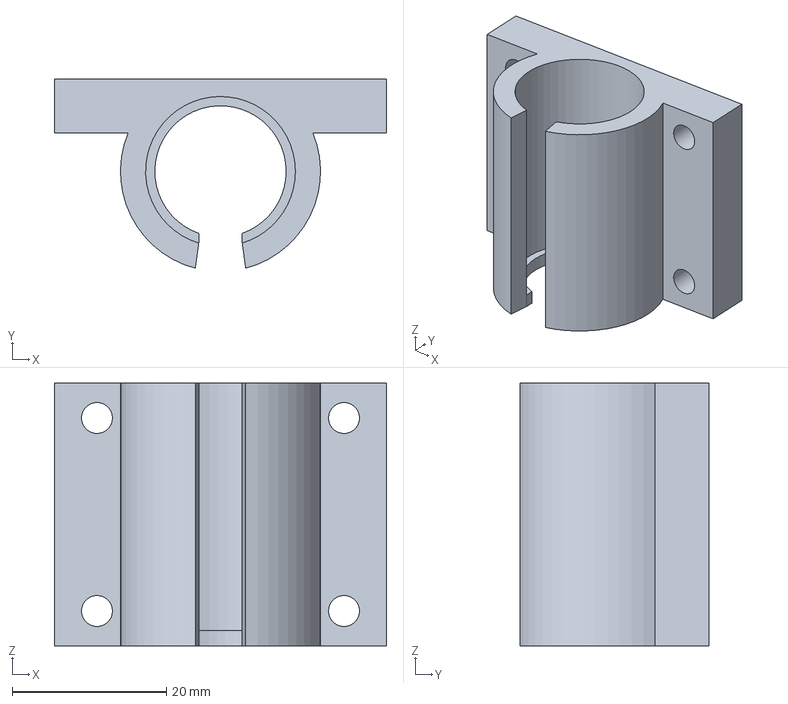
[picture p50: CAD file, 2015-04-01]
1.0/STEP/Bearing_Holder.stp
43.0 x 24.5 x 34.0 mm
