brut/3dp_taz/Juniper/ToPrint/FreeCAD/Z_MotorMount_v1.2.fcstd

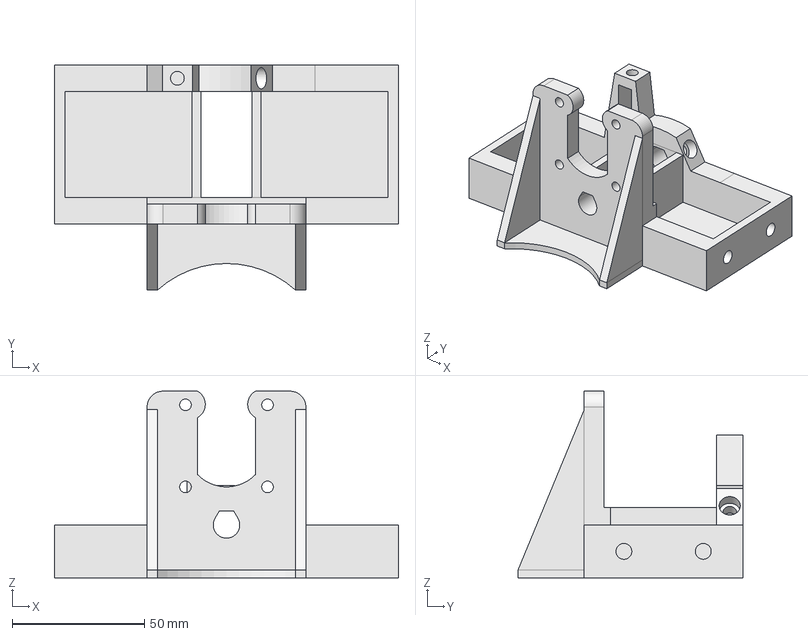
[picture p51: CAD file, 2015-04-01]
Juniper/ToPrint/FreeCAD/Z_MotorMount_v1.2.fcstd
130.0 x 85.0 x 70.6 mm
