brut/3dp_taz/Juniper/ToPrint/STL/PP-GP0091 extruder_latch-2.0.stl

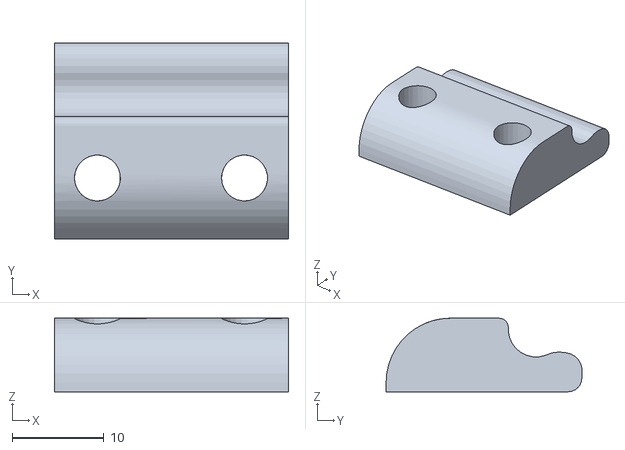
[picture p52: CAD file, 2015-03-31]
Juniper/ToPrint/STL/PP-GP0091 extruder_latch-2.0.stl
25.5 x 21.3 x 8.00
