brut/3dp_taz/1.0/STEP/FilamentGuide.stp

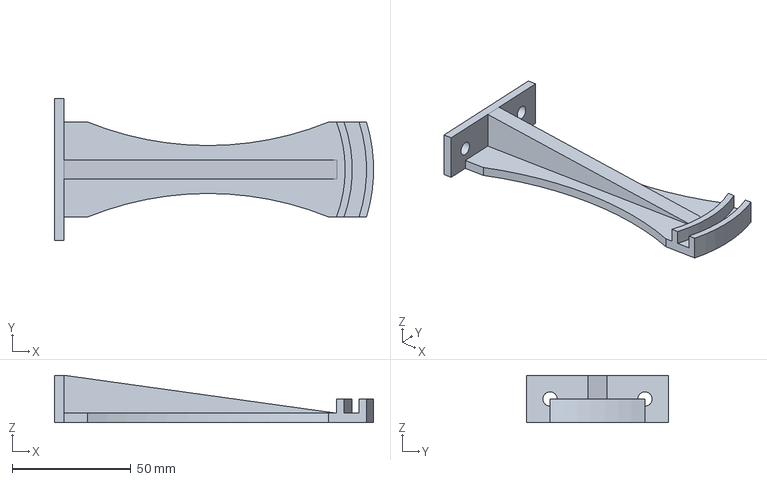
[picture p53: CAD file, 2015-04-01]
1.0/STEP/FilamentGuide.stp
134.4 x 60.0 x 20.0 mm
