brut/3dp_taz/Juniper/ToPrint/FreeCAD/PP-GP0118 bed_corner-2.5.FCStd

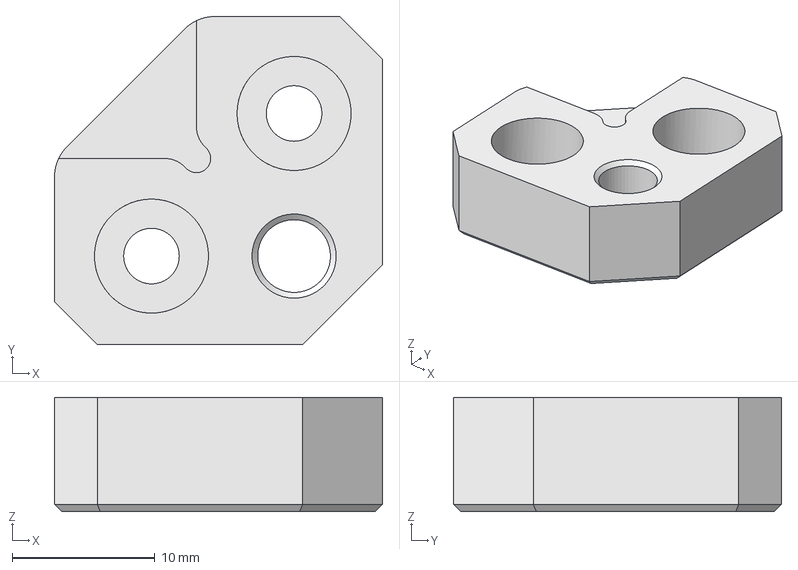
[picture p54: CAD file, 2015-04-01]
Juniper/ToPrint/FreeCAD/PP-GP0118 bed_corner-2.5.FCStd
23.0 x 23.0 x 8.00 mm
