brut/3dp_taz/Juniper/ToPrint/STL/PP-GP0151 x_idler_v2.4.stl

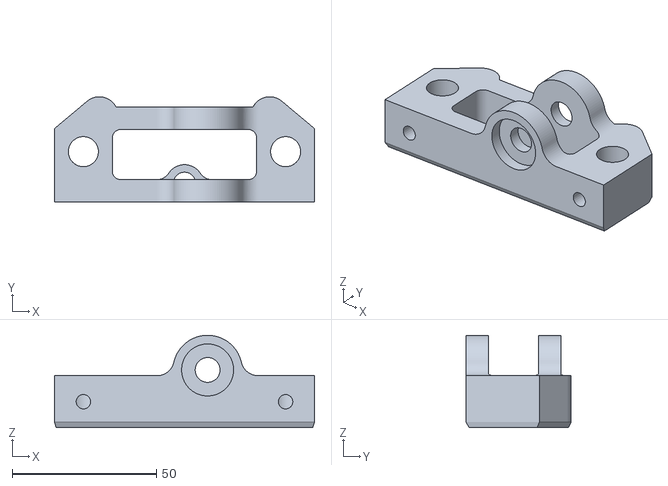
[picture p55: CAD file, 2015-03-31]
Juniper/ToPrint/STL/PP-GP0151 x_idler_v2.4.stl
90.0 x 36.5 x 32.0
