brut/3dp_taz/1.0/STEP/NEMA-17_StepperMotor.stp

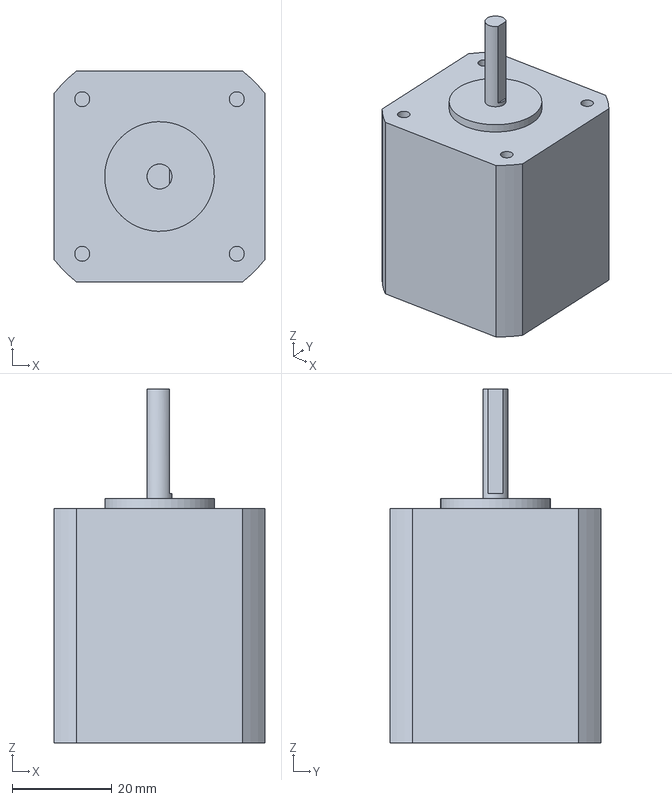
[picture p56: CAD file, 2015-04-01]
1.0/STEP/NEMA-17_StepperMotor.stp
42.3 x 42.3 x 71.0 mm
