brut/3dp_taz/Juniper/ToPrint/FreeCAD/PP-GP0126 z_motor_mount-v2.1-switch-left_easy-break-ears.fcstd

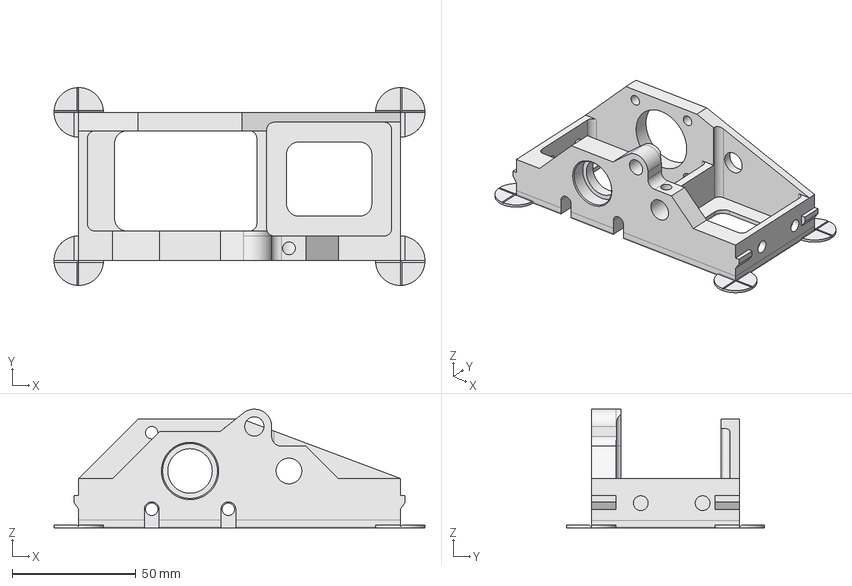
[picture p57: CAD file, 2015-04-01]
Juniper/ToPrint/FreeCAD/PP-GP0126 z_motor_mount-v2.1-switch-left_easy-break-ears.fcstd
150.0 x 80.0 x 48.0 mm
