brut/3dp_taz/Juniper/ToPrint/STL/PP-GP0084 double_bearing_holder_2.1.STL

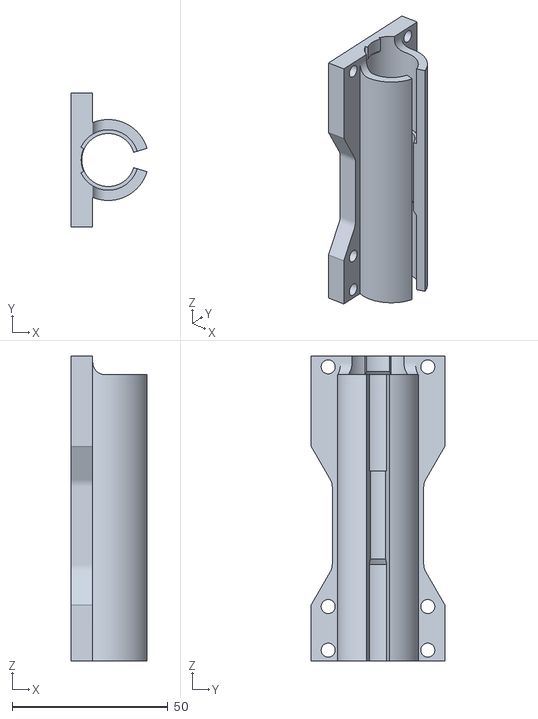
[picture p58: CAD file, 2015-03-31]
Juniper/ToPrint/STL/PP-GP0084 double_bearing_holder_2.1.STL
24.4 x 43.0 x 98.0
