brut/3dp_taz/1.0/STEP/X_Carriage.stp

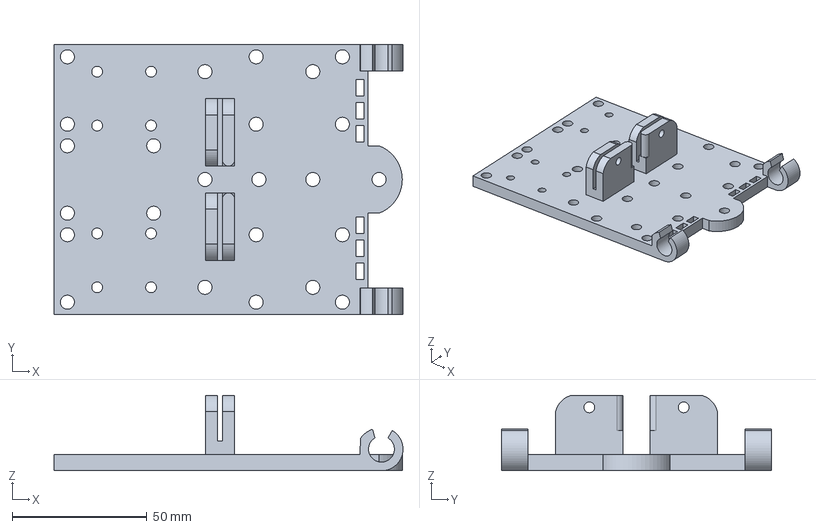
[picture p59: CAD file, 2015-04-01]
1.0/STEP/X_Carriage.stp
129.5 x 100.0 x 28.0 mm
