brut/3dp_taz/Juniper/ToPrint/STL/PP-GP0128 x_carriage_v2.0.STL

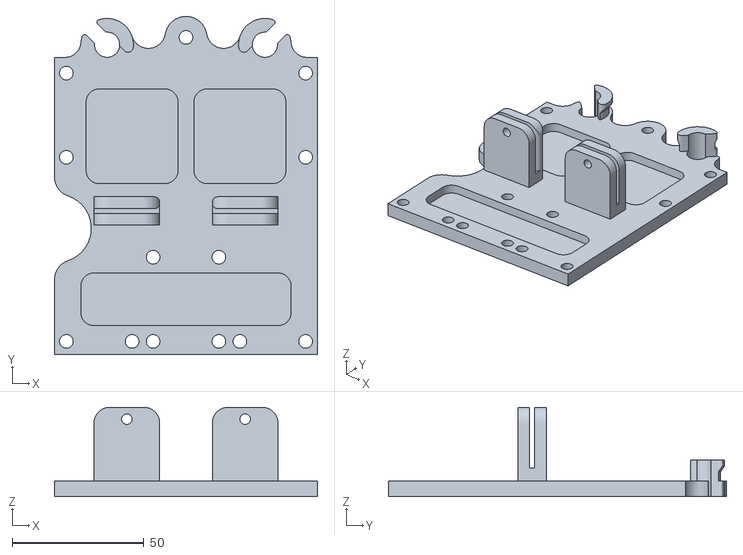
[picture p60: CAD file, 2015-03-31]
Juniper/ToPrint/STL/PP-GP0128 x_carriage_v2.0.STL
100.0 x 128.5 x 34.0
