brut/3dp_taz/1.0/STEP/glass_finger.stp

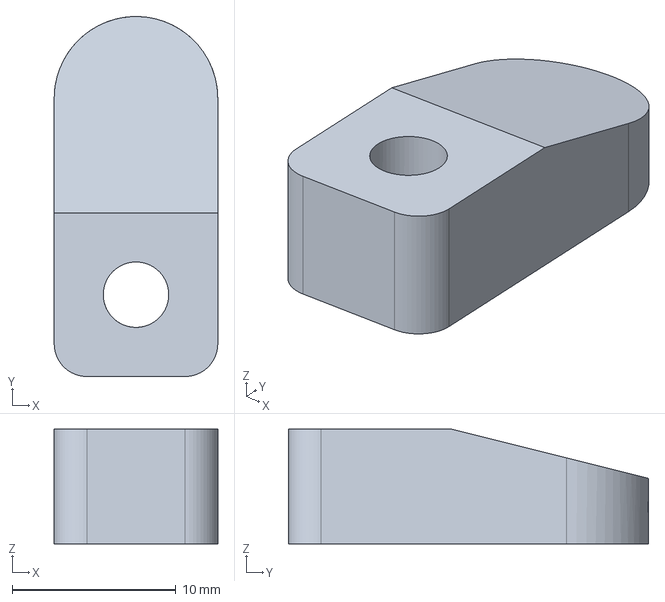
[picture p61: CAD file, 2015-04-01]
1.0/STEP/glass_finger.stp
10.0 x 22.0 x 7.00 mm
