brut/3dp_taz/Juniper/ToPrint/FreeCAD/Y_Bearing-4mmoffset_v1.3.b.fcstd

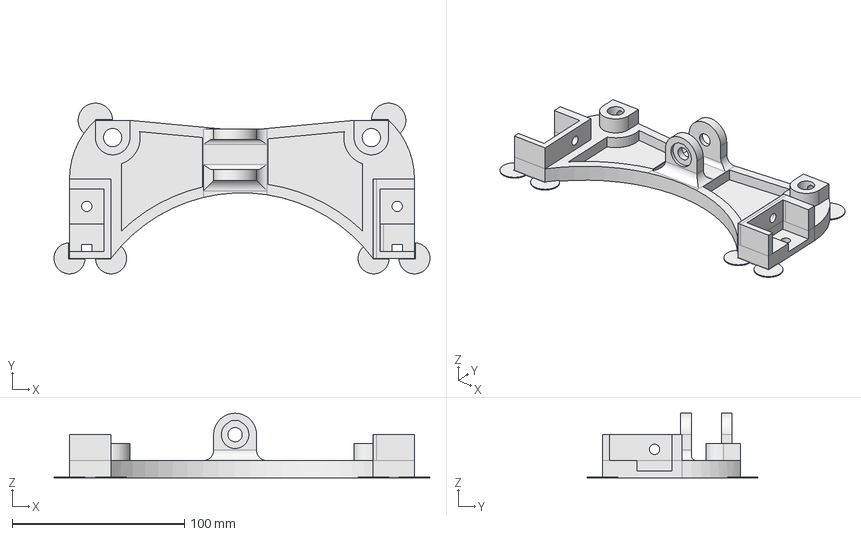
[picture p62: CAD file, 2015-04-01]
Juniper/ToPrint/FreeCAD/Y_Bearing-4mmoffset_v1.3.b.fcstd
218.0 x 99.0 x 37.4 mm
