brut/3dp_taz/Juniper/ToPrint/STL/PP-GP0061 lrg_herringbone_gear_v1.3.stl

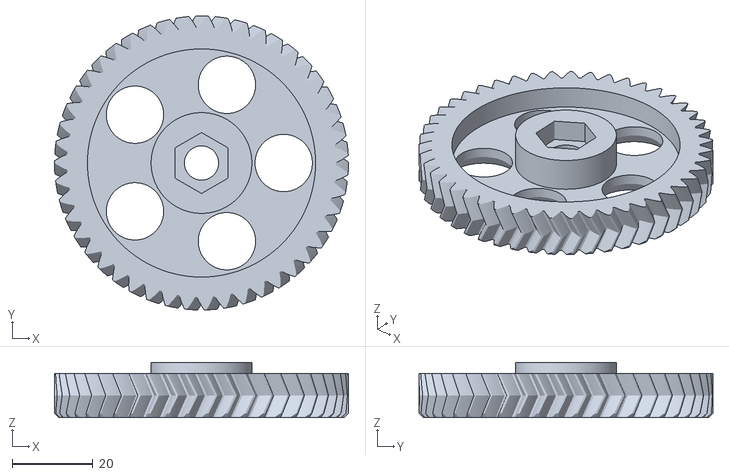
[picture p63: CAD file, 2015-03-31]
Juniper/ToPrint/STL/PP-GP0061 lrg_herringbone_gear_v1.3.stl
73.0 x 73.0 x 13.8
