brut/3dp_taz/1.0/STEP/Y_Motor.stp

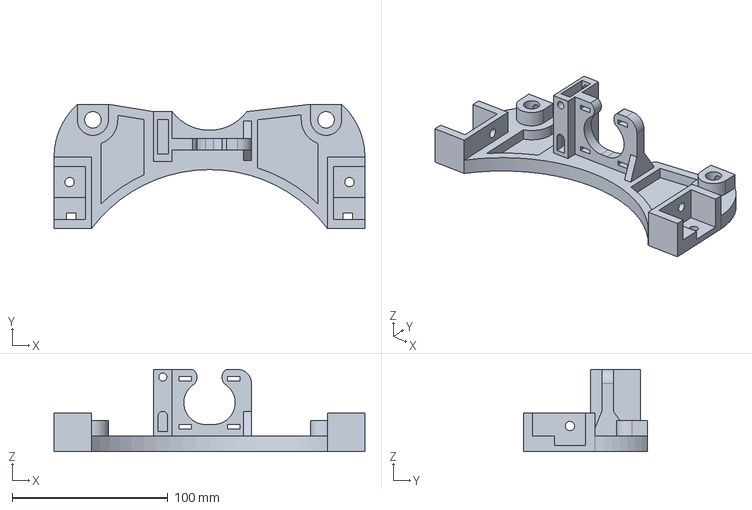
[picture p64: CAD file, 2015-04-01]
1.0/STEP/Y_Motor.stp
200.0 x 80.0 x 53.0 mm
