brut/3dp_taz/Juniper/ToPrint/FreeCAD/PP-GP0120 feed_tube_holder_v2.0.fcstd

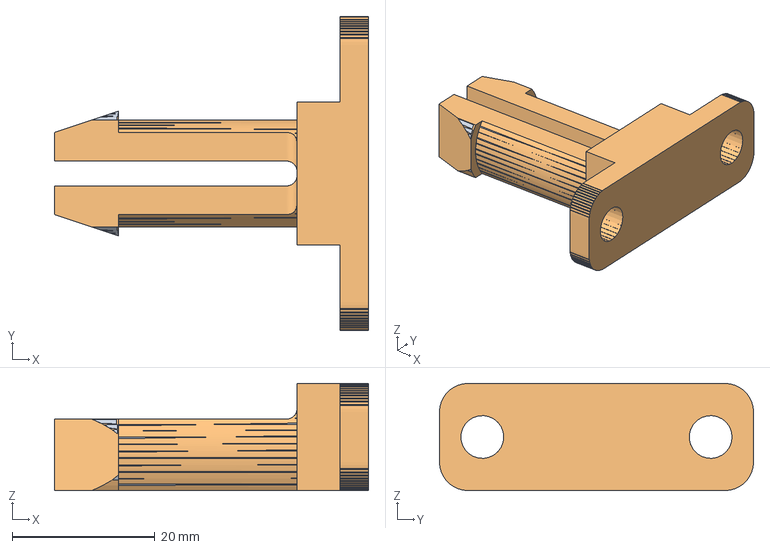
[picture p65: CAD file, 2015-03-31]
Juniper/ToPrint/FreeCAD/PP-GP0120 feed_tube_holder_v2.0.fcstd
44.0 x 44.0 x 15.0 mm
Fillet002 (Meshed)
