brut/3dp_taz/1.0/STEP/ElectronicEnclosureSwitchSide.stp

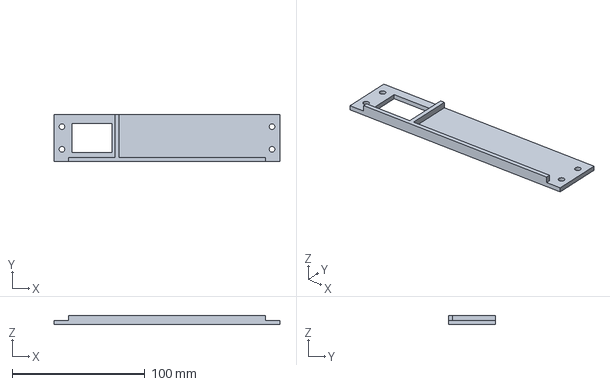
[picture p66: CAD file, 2015-04-01]
1.0/STEP/ElectronicEnclosureSwitchSide.stp
170.0 x 35.0 x 7.00 mm
