brut/3dp_taz/Juniper/ToPrint/FreeCAD/PP-GP0059 extruder_idler_v1.4.fcstd

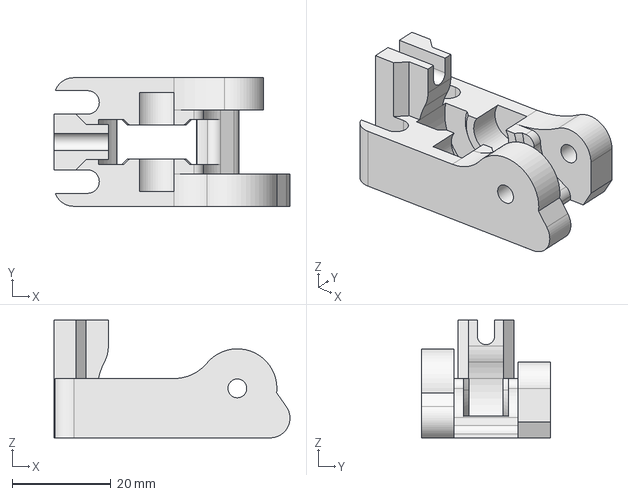
[picture p67: CAD file, 2015-03-31]
Juniper/ToPrint/FreeCAD/PP-GP0059 extruder_idler_v1.4.fcstd
47.7 x 26.0 x 23.8 mm
