brut/3dp_taz/Juniper/ToPrint/STL/PP-GP0062 herringbone_small_gear-1.1-highres-050.stl

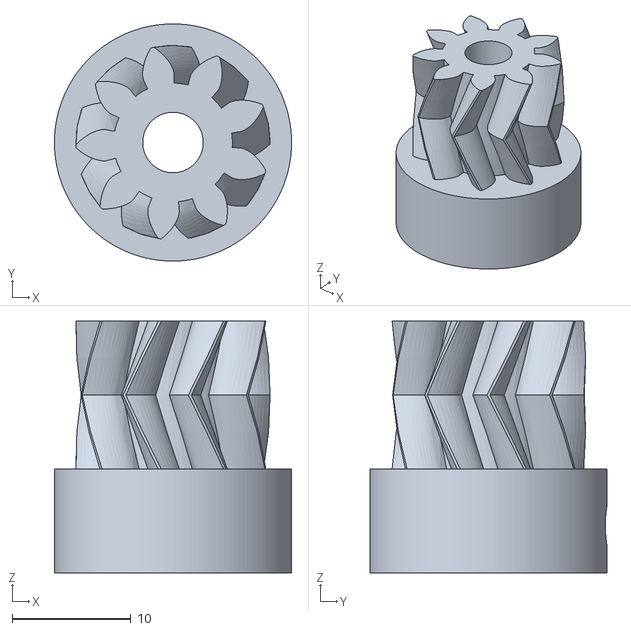
[picture p68: CAD file, 2015-03-31]
Juniper/ToPrint/STL/PP-GP0062 herringbone_small_gear-1.1-highres-050.stl
20.0 x 20.0 x 21.2
