brut/3dp_taz/1.0/STEP/Z_NutSpring.stp

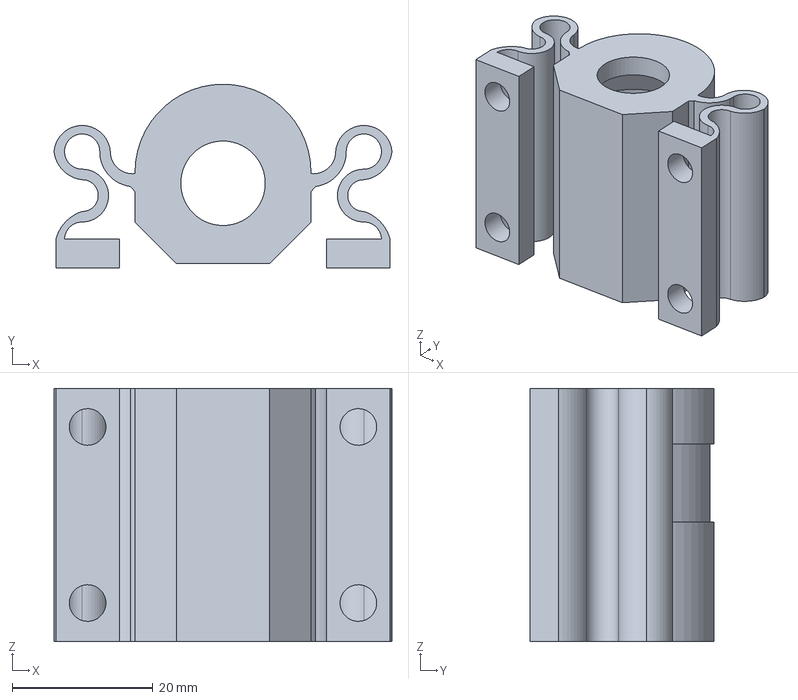
[picture p69: CAD file, 2015-04-01]
1.0/STEP/Z_NutSpring.stp
48.0 x 26.1 x 36.0 mm
