brut/3dp_taz/Juniper/ToPrint/STL/PP-GP0074 feed_tube_spinner-1.0-x6.stl

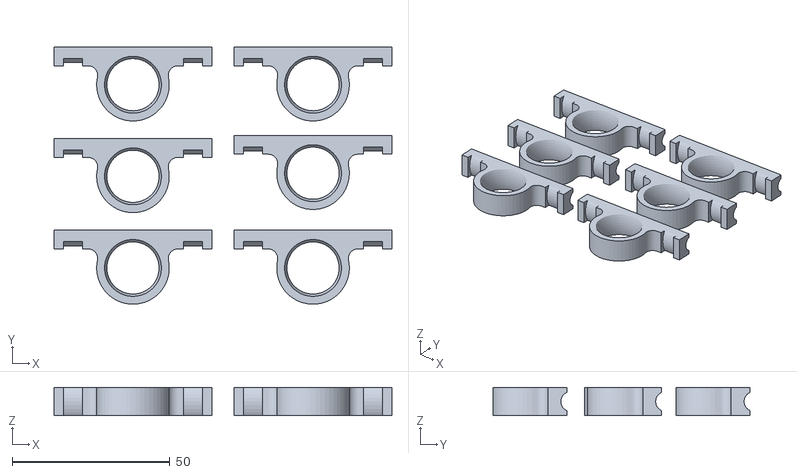
[picture p70: CAD file, 2015-03-31]
Juniper/ToPrint/STL/PP-GP0074 feed_tube_spinner-1.0-x6.stl
107.0 x 81.5 x 9.00
