brut/3dp_taz/1.0/STEP/Y_Bed.stp

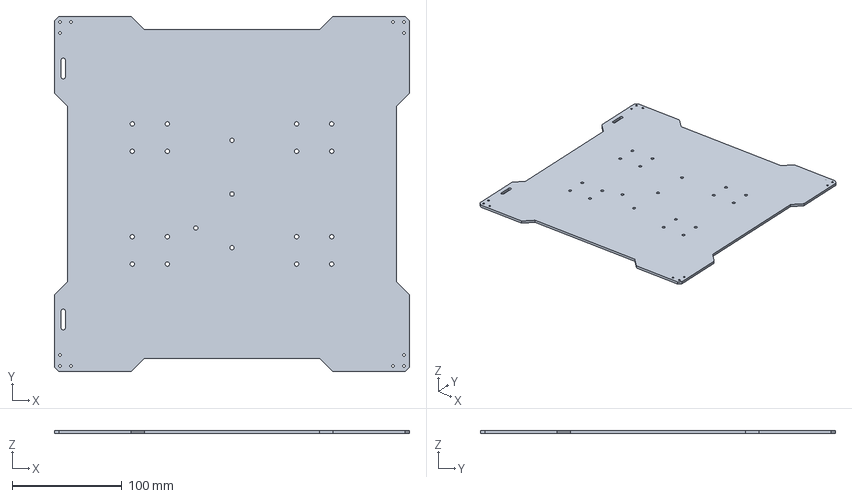
[picture p71: CAD file, 2015-04-01]
1.0/STEP/Y_Bed.stp
324.0 x 324.0 x 3.18 mm
