brut/3dp_taz/Juniper/ToPrint/STL/PP-GP0117 bearing_holder_v1.1.b.stl

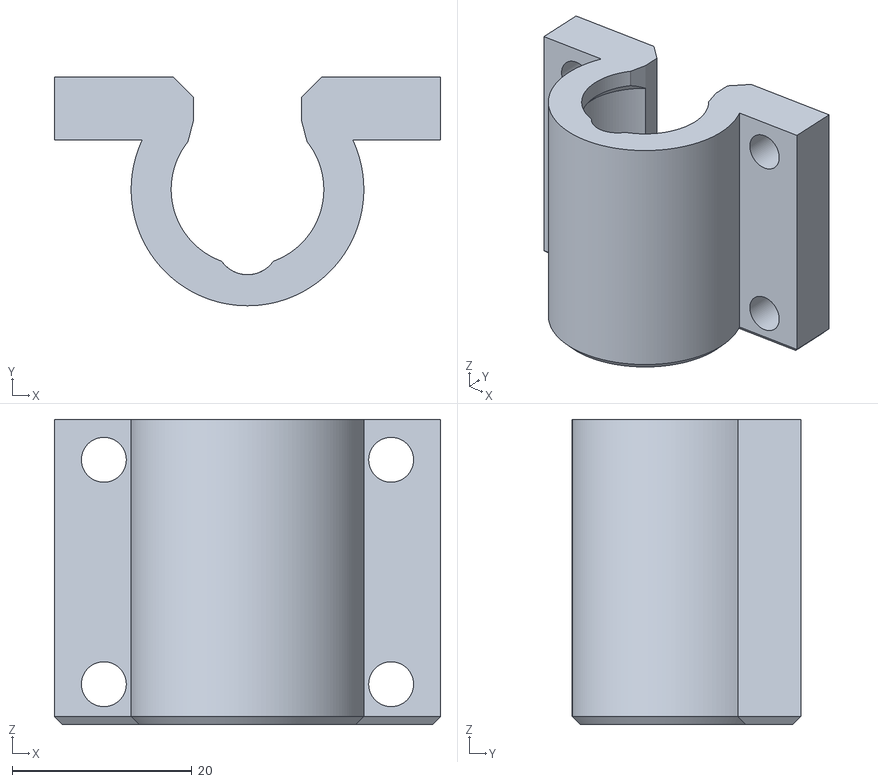
[picture p72: CAD file, 2015-03-31]
Juniper/ToPrint/STL/PP-GP0117 bearing_holder_v1.1.b.stl
43.0 x 25.5 x 34.0
