brut/3dp_taz/1.0/STEP/ElectronicEnclosureStrainRelief.stp

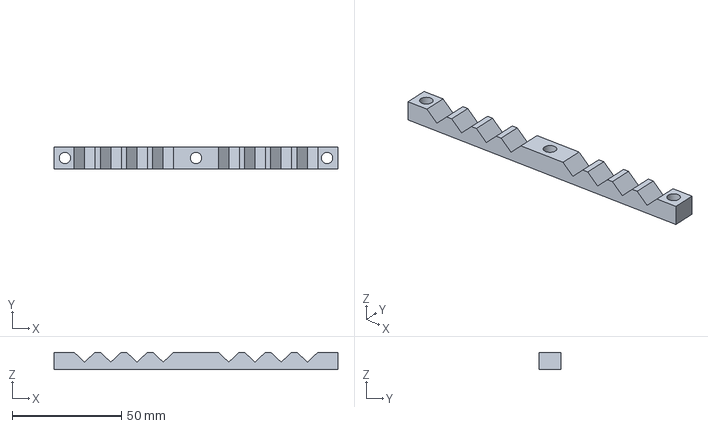
[picture p73: CAD file, 2015-04-01]
1.0/STEP/ElectronicEnclosureStrainRelief.stp
130.0 x 10.0 x 8.00 mm
