brut/3dp_taz/Juniper/ToPrint/STL/PP-GP0152 x_motor_mount_v2.2.stl

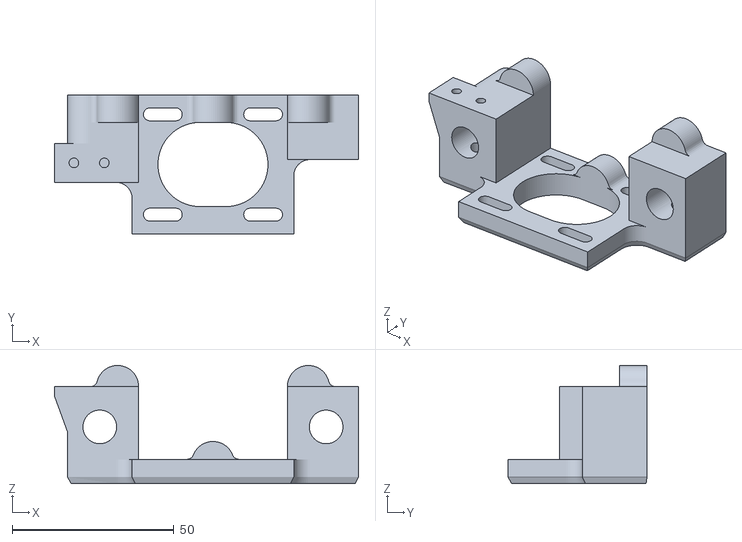
[picture p74: CAD file, 2015-03-31]
Juniper/ToPrint/STL/PP-GP0152 x_motor_mount_v2.2.stl
94.0 x 43.0 x 36.5
