brut/3dp_taz/1.0/STEP/ElectronicEnclosureTopBlank.stp

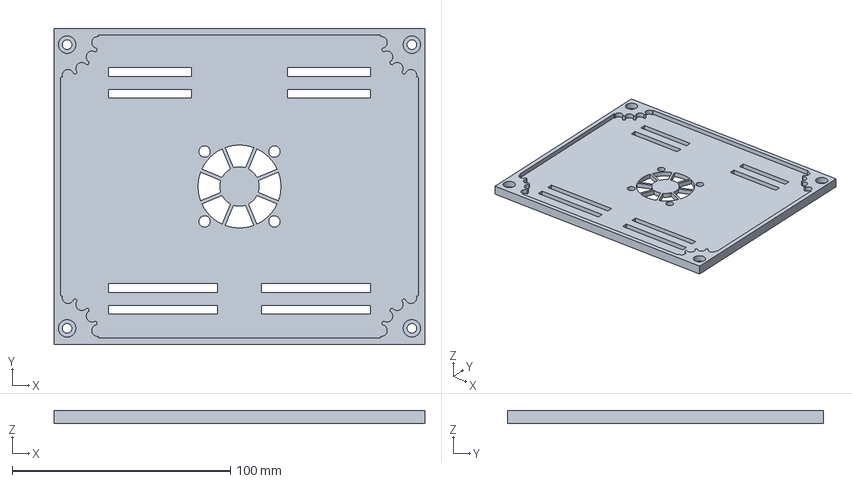
[picture p75: CAD file, 2015-04-01]
1.0/STEP/ElectronicEnclosureTopBlank.stp
170.0 x 145.0 x 6.00 mm
