brut/3dp_taz/1.0/STEP/BeltClamp.stp

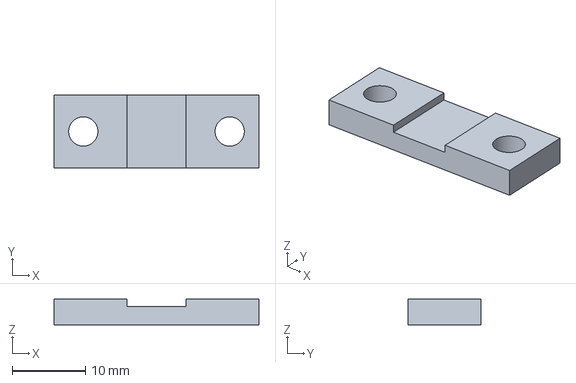
[picture p76: CAD file, 2015-04-01]
1.0/STEP/BeltClamp.stp
28.0 x 10.0 x 3.50 mm
