brut/3dp_taz/Juniper/ToPrint/STL/bed_finger-2.1-x20.stl

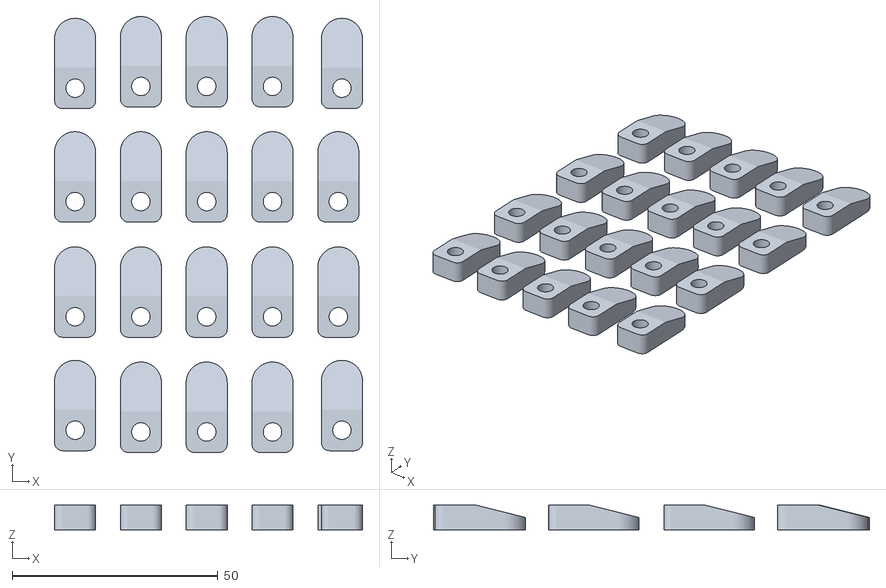
[picture p77: CAD file, 2015-03-31]
Juniper/ToPrint/STL/bed_finger-2.1-x20.stl
74.9 x 106.0 x 6.00
