brut/3dp_taz/1.0/STEP/NamePlate.stp

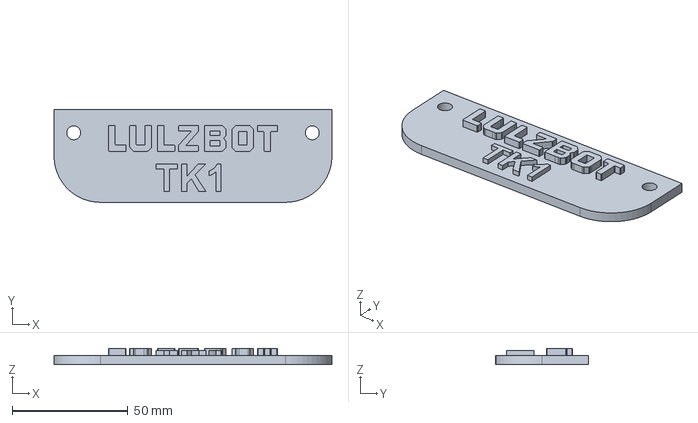
[picture p78: CAD file, 2015-04-01]
1.0/STEP/NamePlate.stp
120.0 x 40.0 x 7.00 mm
