brut/3dp_taz/1.0/STEP/FrameConnectors.stp

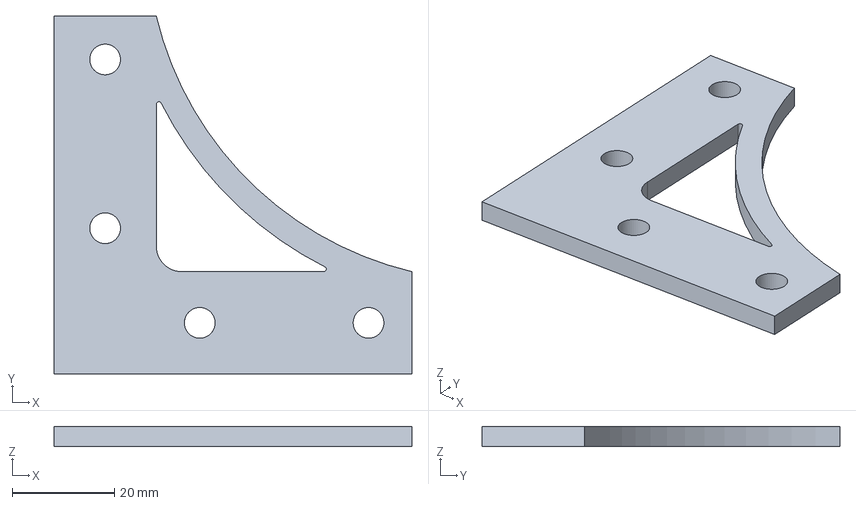
[picture p79: CAD file, 2015-04-01]
1.0/STEP/FrameConnectors.stp
70.0 x 70.0 x 4.00 mm
