brut/3dp_taz/(list of files, cad)

Other CAD files:
Juniper/ToPrint/FreeCAD/Y_Motor_v1.1.d.fcstd
1.0/STEP/HFS5-2020x500mm.stp
Juniper/ToPrint/STL/PP-GP0123 z_top_drive_left-v1.3.stl
Juniper/ToPrint/STL/PP-GP0114 y_corner_right-v1.4.stl
1.0/STEP/X_SingleExtruderMount.stp
Juniper/ToPrint/STL/PP-GP0094 x_carriage_guide-1.0.stl
Juniper/ToPrint/FreeCAD/PP-GP0121 y_mount_chassis-2.1.fcstd
Juniper/ToPrint/FreeCAD/X_MotorForSpring_v1.2.fcstd
Juniper/ToPrint/STL/PP-GP0084 double_bearing_holder-2.0.stl
Juniper/ToPrint/FreeCAD/PP-GP0089 lcd_spacers_v0.4.FCStd
1.0/STEP/ElectronicEnclosureStrainReliefSide.stp
1.0/STEP/Y_BeltMount.stp
1.0/STEP/Y_Bearing-4mmoffset.stp
1.0/STEP/X_SingleExtruderMountOffset.stp
1.0/STEP/Z_MotorMount.stp
1.0/FCStd/Bearing_Holder.fcstd
1.0/FCStd/BeltClamp.fcstd
1.0/FCStd/CableHolder.fcstd
1.0/FCStd/ElectronicEnclosureBottom.fcstd
1.0/FCStd/ElectronicEnclosurePowerCordSide.fcstd
1.0/FCStd/ElectronicEnclosureSDSlotSide.fcstd
1.0/FCStd/ElectronicEnclosureStrainRelief.fcstd
1.0/FCStd/ElectronicEnclosureStrainReliefSide.fcstd
1.0/FCStd/ElectronicEnclosureSwitchSide.fcstd
1.0/FCStd/ElectronicEnclosureTop.fcstd
1.0/FCStd/ElectronicEnclosureTopBlank.fcstd
1.0/FCStd/FilamentGuide.fcstd
1.0/FCStd/FrameConnectors.fcstd
1.0/FCStd/LM10UU_LinearBearing.fcstd
1.0/FCStd/NEMA-17_StepperMotor.fcstd
1.0/FCStd/NamePlate.fcstd
1.0/FCStd/X_BearingForSpring.fcstd
1.0/FCStd/X_Carriage.fcstd
1.0/FCStd/X_Carriage_QuickGuide.fcstd
1.0/FCStd/X_MotorForSpring.fcstd
1.0/FCStd/X_SingleExtruderMount.fcstd
1.0/FCStd/X_SingleExtruderMountOffset.fcstd
1.0/FCStd/X_SingleExtruderShield.fcstd
1.0/FCStd/Y_Bearing-4mmoffset.fcstd
1.0/FCStd/Y_Bed.fcstd
1.0/FCStd/Y_BeltMount.fcstd
1.0/FCStd/Y_FrameConnectorA.fcstd
1.0/FCStd/Y_FrameConnectorB.fcstd
1.0/FCStd/Y_Motor.fcstd
1.0/FCStd/Z_MotorMount.fcstd
1.0/FCStd/Z_NutSpring.fcstd
1.0/FCStd/Z_Top.fcstd
1.0/FCStd/glass_corner.fcstd
1.0/FCStd/glass_finger.fcstd
1.0/FCStd/rocker_switch.fcstd
1.0/FCStd/smooth_rod_10x500mm.fcstd
1.0/FCStd/threaded_rod_0375-12_365mm.fcstd
Juniper/ToPrint/FreeCAD/PP-GP0127 drive_nut_holder_4.fcstd
Juniper/ToPrint/FreeCAD/jonaskuehling_gregs-wade-ao-v3.1-washer.fcstd
Juniper/ToPrint/STL/PP-GP0059 extruder_idler_v1.4.stl
Juniper/ToPrint/STL/PP-GP0061 lrg_herringbone_gear_v1.3.blend
Juniper/ToPrint/STL/PP-GP0118 bed_corner-2.5.stl
Juniper/ToPrint/STL/PP-GP0120 feed_tube_holder_v2.0.stl
Juniper/ToPrint/STL/PP-GP0122 y_mount_table-2.1.stl
Juniper/ToPrint/STL/PP-GP0127 drive_nut_holder_4.1.stl
Juniper/ToPrint/STL/PP-GP0127 drive_nut_holder_4.stl
Juniper/ToPrint/STL/PP-GP0154 electronics_case_mount_v1.1.stl
Juniper/ToPrint/STL/PP-GP0163 long_shim.stl
Juniper/ToPrint/STL/jonaskuehling_gregs-wade-ao-v3-washer-x7.stl
