brut/3dp_taz/Juniper/ToBuy/300mm_bed_mount_plate_rA.PDF

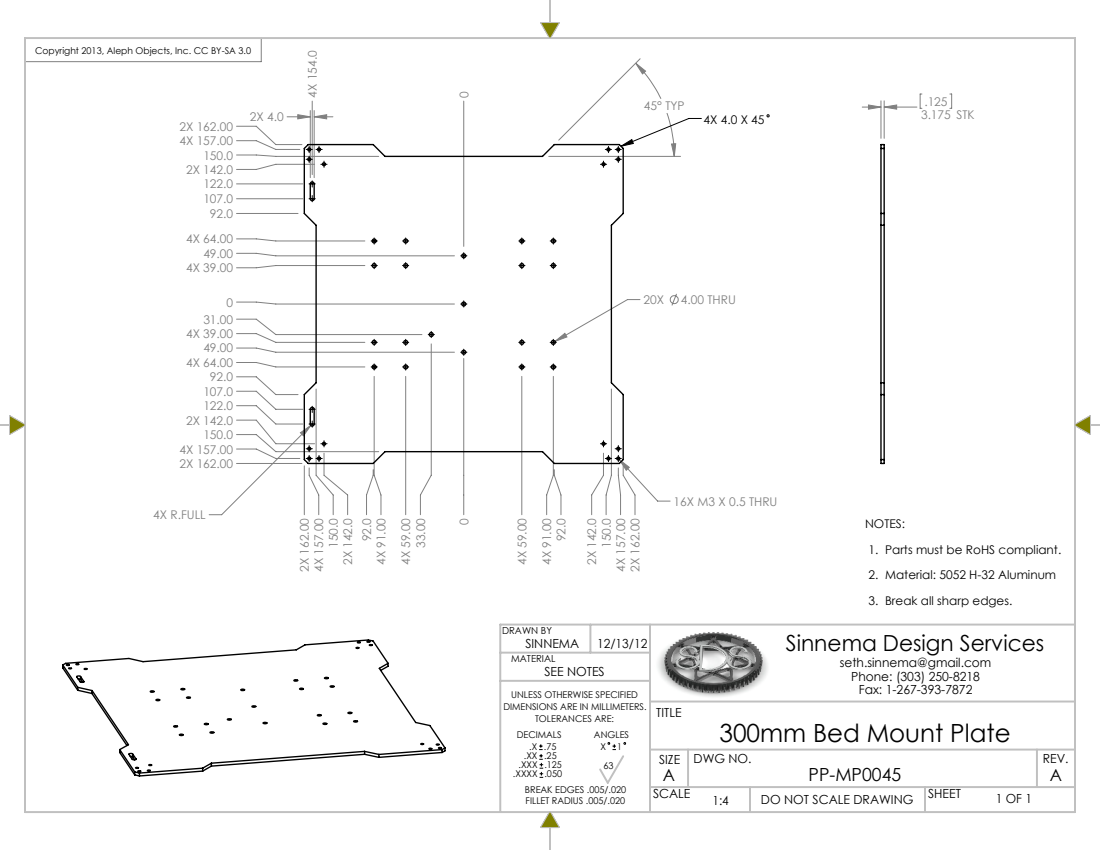
[picture p80: page 1]
45° TYP; 16X M3 X 0.5 THRU; 20X 4.00 THRU; 4X R.FULL; 3.175 STK; SEE NOTES; SINNEMA 12/13/12; DRAWN BY; SCALE; 1 OF 1 SHEET; DWG NO.; REV.

Copyright 2013, Aleph Objects, Inc. CC BY-SA 3.0

NOTES:
1. Parts must be RoHS compliant.
2. Material: 5052 H-32 Aluminum
3. Break all sharp edges.
Sinnema Design Services

seth.sinnema@gmail.com
Phone: (303) 250-8218
Fax: 1-267-393-7872

UNLESS OTHERWISE SPECIFIED
DIMENSIONS ARE IN MILLIMETERS.
TOLERANCES ARE:
DECIMALS
.XXX .125
.XXXX .050
BREAK EDGES .005/.020
FILLET RADIUS .005/.020

TITLE
300mm Bed Mount Plate

DO NOT SCALE DRAWING
