brut/3dp_taz/Juniper/ToBuy/smooth_rod_rF.PDF

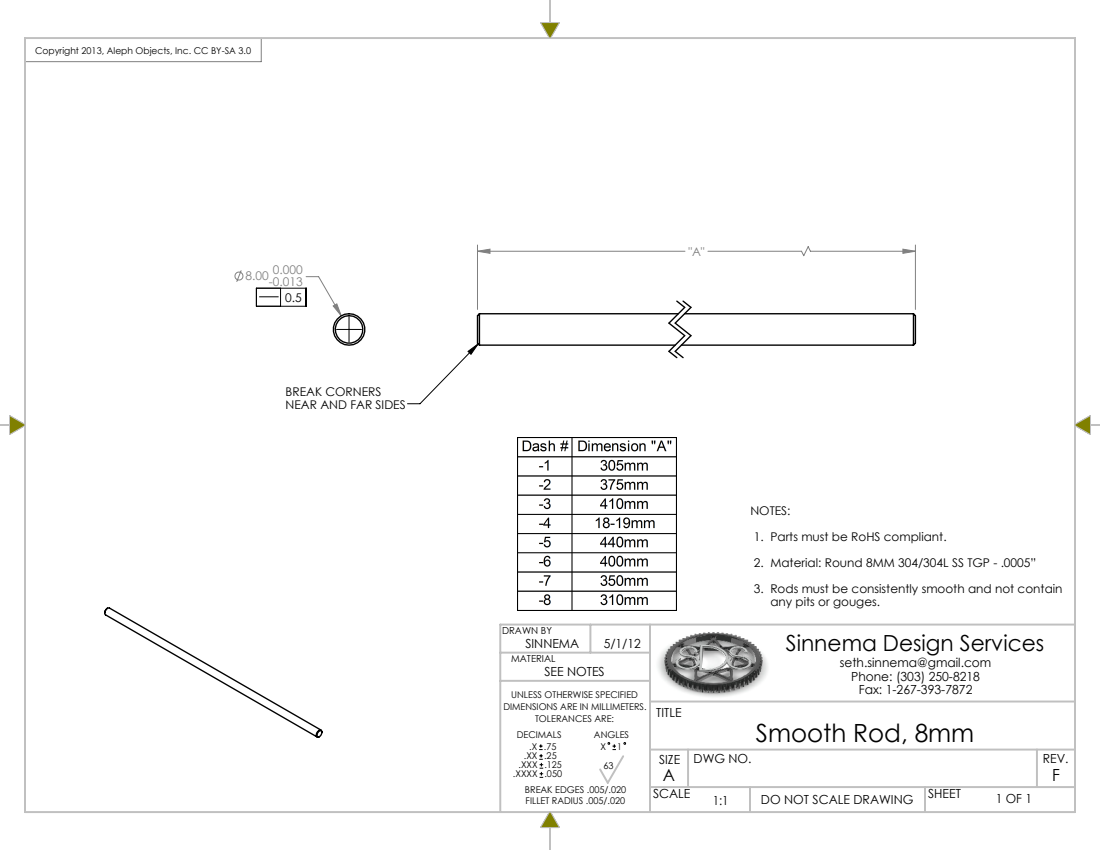
[picture p81: page 1]
SEE NOTES; DRAWN BY; Smooth Rod, 8mm; SCALE; 1 OF 1 SHEET; DWG NO.; REV.

Copyright 2013, Aleph Objects, Inc. CC BY-SA 3.0

BREAK CORNERS
NEAR AND FAR SIDES

NOTES:
1. Parts must be RoHS compliant.
2. Material: Round 8MM 304/304L SS TGP - .0005”
3. Rods must be consistently smooth and not contain
any pits or gouges.
Sinnema Design Services

seth.sinnema@gmail.com
Phone: (303) 250-8218
Fax: 1-267-393-7872

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

DO NOT SCALE DRAWING
