brut/3dp_taz/Juniper/ToProduce/PP-FP0008_rA.PDF

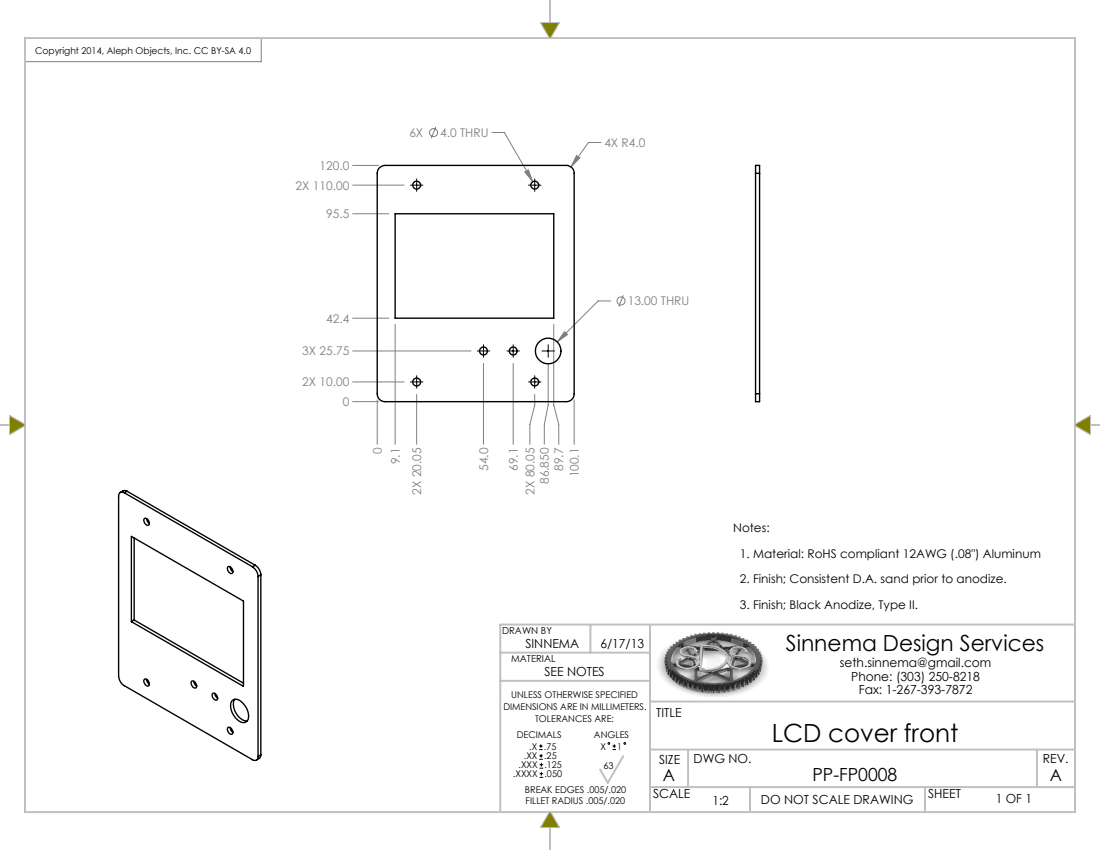
[picture p82: page 1]
13.00 THRU; 6X 4.0 THRU; SEE NOTES; DRAWN BY; SCALE; 1 OF 1 SHEET; DWG NO.; REV.

Copyright 2014, Aleph Objects, Inc. CC BY-SA 4.0

Notes:
1. Material: RoHS compliant 12AWG (.08") Aluminum
2. Finish; Consistent D.A. sand prior to anodize.
3. Finish; Black Anodize, Type II.
Sinnema Design Services

seth.sinnema@gmail.com
Phone: (303) 250-8218
Fax: 1-267-393-7872
LCD cover front
DO NOT SCALE DRAWING

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
