brut/3dp_taz/Juniper/ToProduce/PP-FP0009_rA.PDF

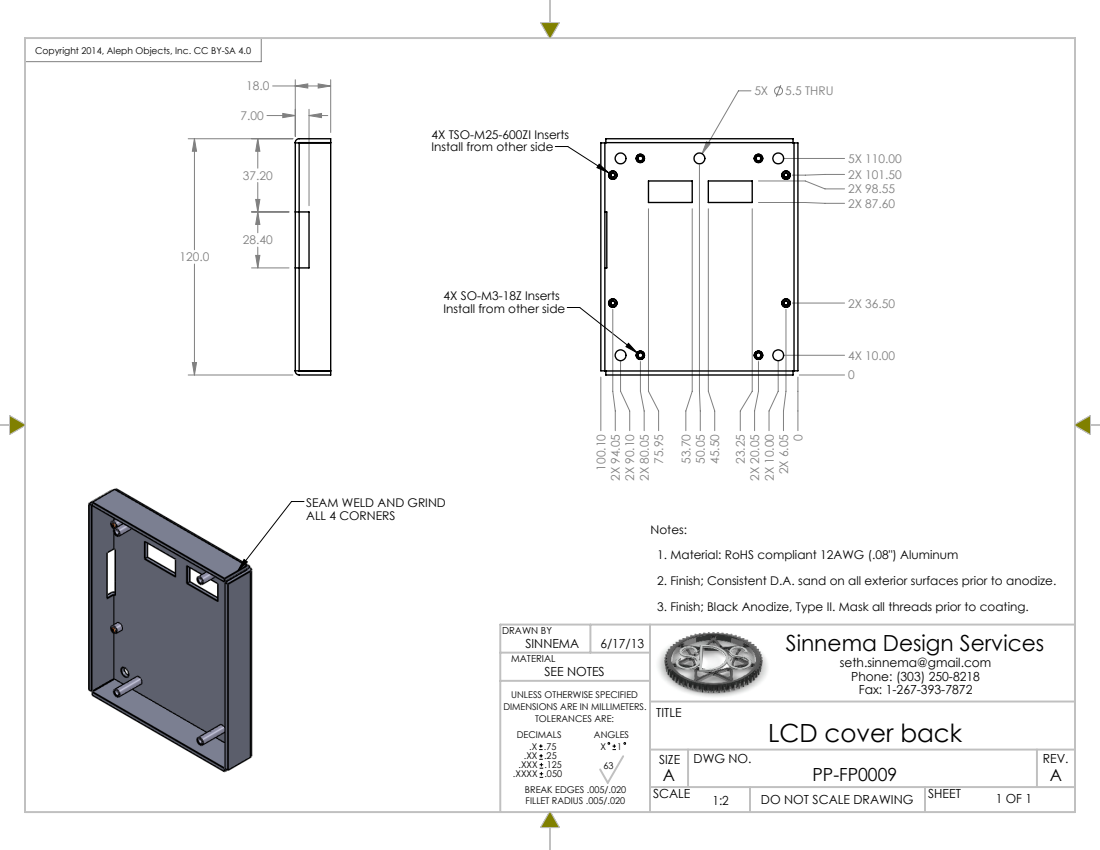
[picture p83: page 1]
5X 5.5 THRU; SEE NOTES; DRAWN BY; SCALE; 1 OF 1 SHEET; DWG NO.; REV.

Copyright 2014, Aleph Objects, Inc. CC BY-SA 4.0

4X TSO-M25-600ZI Inserts
Install from other side

4X SO-M3-18Z Inserts

SEAM WELD AND GRIND
ALL 4 CORNERS

Notes:
1. Material: RoHS compliant 12AWG (.08") Aluminum
2. Finish; Consistent D.A. sand on all exterior surfaces prior to anodize.
3. Finish; Black Anodize, Type II. Mask all threads prior to coating.

Sinnema Design Services

seth.sinnema@gmail.com
Phone: (303) 250-8218
Fax: 1-267-393-7872
LCD cover back
DO NOT SCALE DRAWING

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
