brut/3dp_taz/Juniper/ToProduce/PP-FP0015_rC.PDF

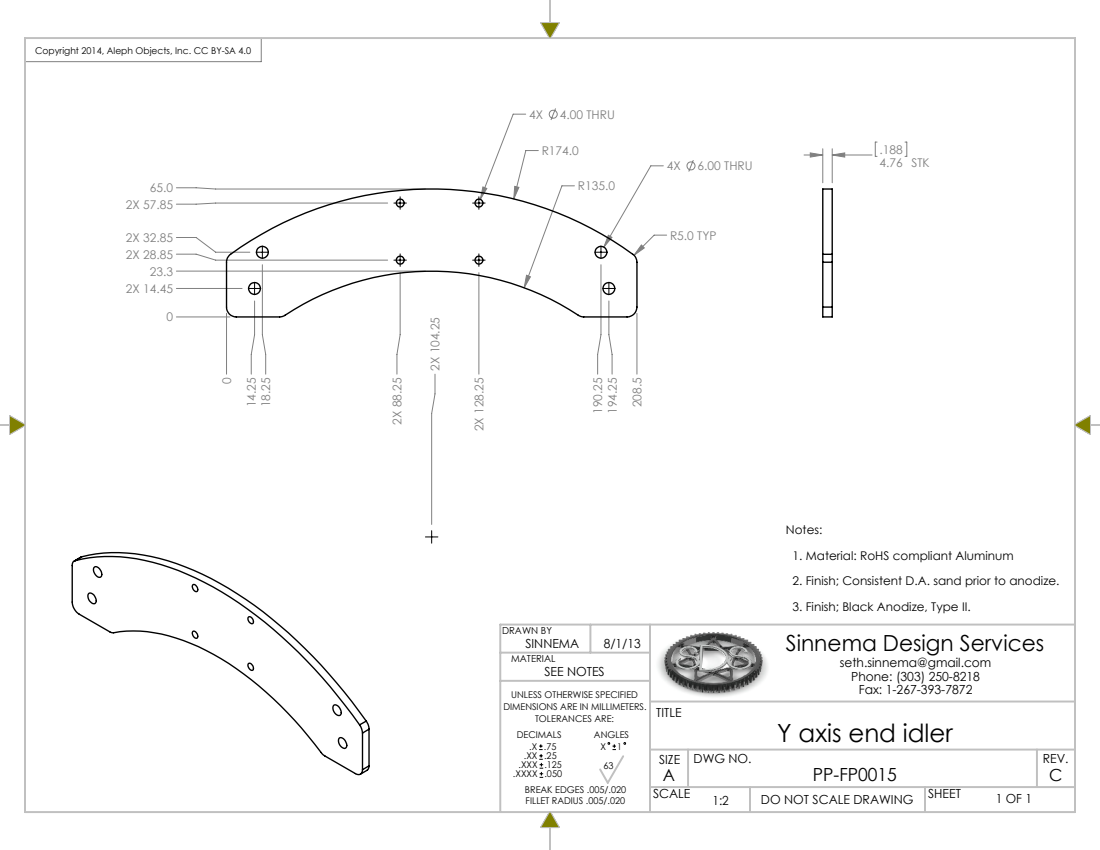
[picture p84: page 1]
4X 6.00 THRU; 4X 4.00 THRU; R5.0 TYP; 4.76 STK; SEE NOTES; DRAWN BY; SCALE; 1 OF 1 SHEET; DWG NO.; REV.

Copyright 2014, Aleph Objects, Inc. CC BY-SA 4.0

Notes:
1. Material: RoHS compliant Aluminum
2. Finish; Consistent D.A. sand prior to anodize.
3. Finish; Black Anodize, Type II.
Sinnema Design Services

seth.sinnema@gmail.com
Phone: (303) 250-8218
Fax: 1-267-393-7872
Y axis end idler
DO NOT SCALE DRAWING

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
