brut/3dp_taz/Juniper/ToProduce/PP-FP0030_rC.PDF

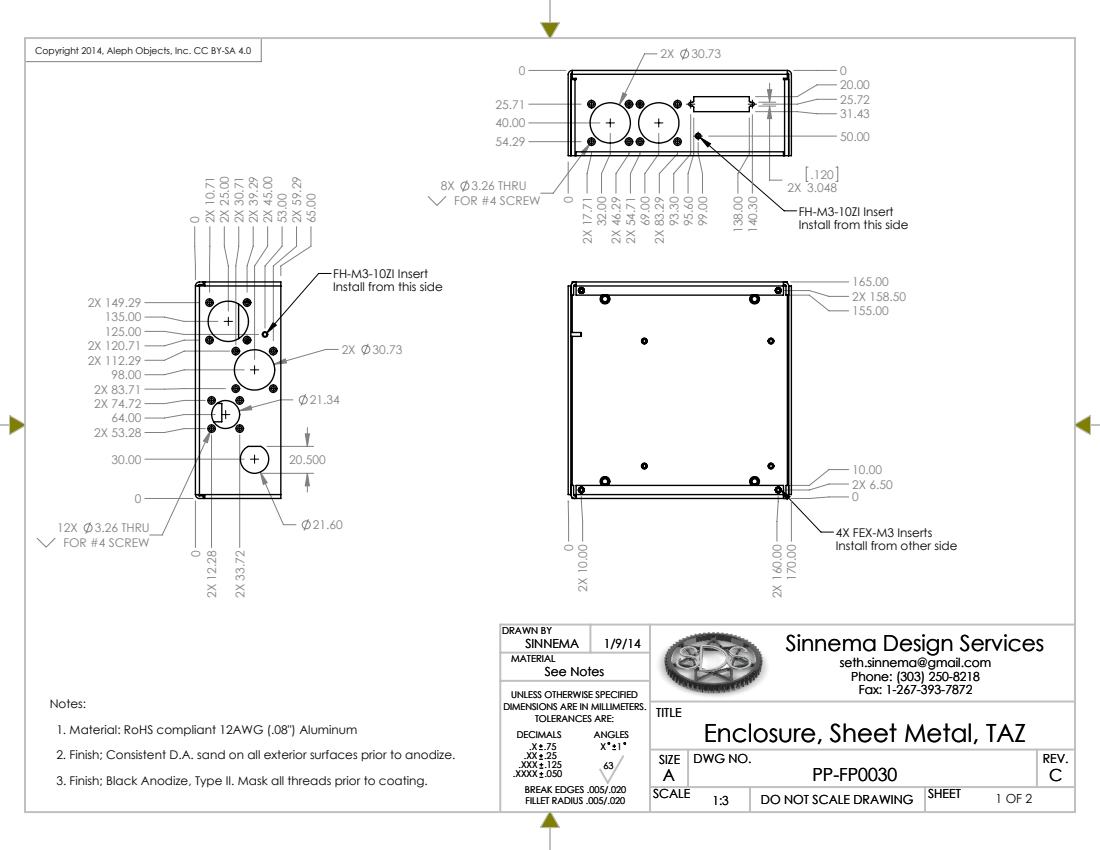
[picture p85: page 1]
8X 3.26 THRU; FOR #4 SCREW; 12X 3.26 THRU FOR #4 SCREW; See Notes; DRAWN BY; DWG NO.; REV.

Copyright 2014, Aleph Objects, Inc. CC BY-SA 4.0

FH-M3-10ZI Insert
Install from this side

4X FEX-M3 Inserts
Install from other side

Sinnema Design Services

seth.sinnema@gmail.com
Phone: (303) 250-8218
Fax: 1-267-393-7872

UNLESS OTHERWISE SPECIFIED
DIMENSIONS ARE IN MILLIMETERS.
TOLERANCES ARE:
DECIMALS
.XXX .125
.XXXX .050
BREAK EDGES .005/.020
FILLET RADIUS .005/.020

Notes:
1. Material: RoHS compliant 12AWG (.08") Aluminum
2. Finish; Consistent D.A. sand on all exterior surfaces prior to anodize.
3. Finish; Black Anodize, Type II. Mask all threads prior to coating.

TITLE
Enclosure, Sheet Metal, TAZ

DO NOT SCALE DRAWING

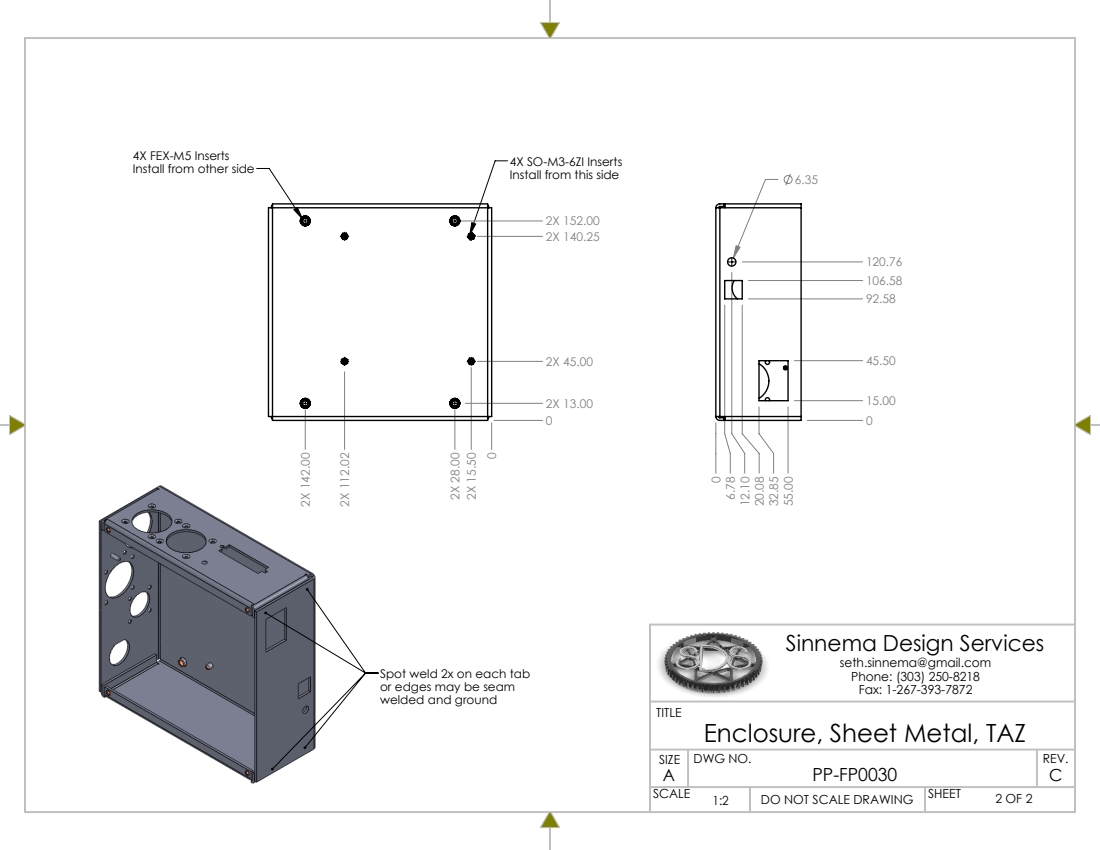
[picture p86: page 2]
SCALE; 2 OF 2 SHEET; DWG NO.; REV.

4X FEX-M5 Inserts
Install from other side

4X SO-M3-6ZI Inserts
Install from this side

Sinnema Design Services

seth.sinnema@gmail.com
Phone: (303) 250-8218
Fax: 1-267-393-7872

Spot weld 2x on each tab
or edges may be seam
welded and ground

TITLE
Enclosure, Sheet Metal, TAZ

DO NOT SCALE DRAWING
