brut/3dp_taz/(commit log)

2015-03-31 исходная спецификация
    [TAZ-BOM-Juniper.xlsx]
2015-03-31 Выделены (но не проверены) отдельные детали для печати
    [PP-GP0059 extruder_idler_v1.4.fcstd, PP-GP0059 extruder_idler_v1.4.stl, PP-GP0061 lrg_herringbone_gear_v1.3.blend, PP-GP0061 lrg_herringbone_gear_v1.3.stl, PP-GP0062 herringbone_small_gear-1.1-highres-035.stl, PP-GP0062 herringbone_small_gear-1.1-highres-050.stl, PP-GP0074 feed_tube_spinner-1.0-x6.stl, PP-GP0083 bed_finger-2.1.STL]
2015-04-01 добавлены файлы во FreeCAD
    [Bearing_Holder.fcstd, Bearing_Holder.stp, BeltClamp.fcstd, BeltClamp.stp, CableHolder.fcstd, CableHolder.stp, ElectronicEnclosureBottom.fcstd, ElectronicEnclosureBottom.stp]
